nicber/arduino-jupyter/PROTOCOL.md

# CtrlLink

Un protocolo serie para gobernar desde un notebook de Jupyter un banco que corre
en un Arduino: fijar sus parámetros, aplicar un escalón y traerse de vuelta la
serie temporal que resulta.

```python
from ctrllink import CtrlLink

dev = CtrlLink()                 # o CtrlLink('COM3'), o '/dev/ttyACM0'
dev.ctl_uff = 100
df = dev.step('ctl_uff', 200, pre=0.3, post=1.2)    # un DataFrame, t = 0 en el escalón
df.plot(x='t', y=['u', 'y_uw'])
```

El dispositivo describe por sí mismo sus parámetros y sus canales de telemetría,
así que la computadora no sabe nada de ningún sketch en particular. Agregar un
parámetro al firmware la hace aparecer en el notebook sin tocar una línea del lado
de Python.

## Diseño

**Un puerto, dos direcciones, sin capa de encuadre.** Las líneas que empiezan
con `#` son texto: respuestas a comandos, eventos, diagnósticos. Cualquier otra
línea es una fila de telemetría. Esa única convención hace que el flujo sea a la
vez interpretable por la máquina y legible en el Monitor Serie del IDE de
Arduino, y permite que una depuración con `Serial.print` conviva con una captura
en vivo en lugar de corromperla.

**Hexadecimal de ancho fijo, en lugar de decimal o binario.** La razón es el
*ancho fijo*, no el hexadecimal. Una fila mide siempre lo mismo, así que el
presupuesto de ancho de banda es exacto en vez de ser el del peor caso, `emit()`
puede pedir exactamente el lugar que necesita, y una captura se decodifica en una
sola llamada vectorizada en lugar de recorrerse línea por línea:

```python
raw = bytes.fromhex(b''.join(rows).decode())
arr = np.frombuffer(raw, dtype=structured_dtype)
```

El hexadecimal además es algo más barato de generar que el decimal —una consulta
a tabla y un `swap` por byte, contra las divisiones sucesivas de `itoa`—, pero el
`itoa` de avr-libc está escrito a mano en assembler, así que la diferencia es
como un 20 % del costo de codificar, no un orden de magnitud. Lo que pesa es
sacar cada byte por la UART, no elegir cómo se escribe (ver *Ancho de banda*), así
que la diferencia es secundaria frente a las ventajas de encuadre de arriba.

Un encuadre binario (COBS + CRC) ahorraría otro ~40 % de los bytes, pero a
1 Mbaud el ancho de banda no es la restricción activa, y costaría la posibilidad
de leer el flujo con los ojos. Subir la velocidad es la palanca más barata:
115200 → 1 Mbaud es 8,7×, mientras que hexadecimal → binario es 1,4×.

**1 Mbaud, no 115200.** En un AVR de 16 MHz, 1000000 es un divisor exacto
(UBRR=1); 115200 cae en UBRR=16, que da 117647 baudios reales, un 2,1 % de error.
La velocidad más alta es además la más exacta. 250000 y 500000 también son
exactas, por si el puente USB-serie de alguna placa no llega más arriba.

**Las dos direcciones no son igual de robustas.** La telemetría a 1 Mbaud es
sólida: medida sobre cinco segundos, cero filas perdidas y cero huecos. Los
comandos no. Un byte entrante llega cada 10 µs, el USART del AVR guarda dos, y
entre el muestreador de 5 kHz y el manejador de TWI de nI2C mantienen las
interrupciones deshabilitadas durante mucho más que eso.

Medido en el banco (2026-09-16), 60 comandos `get loop_div` de 13 bytes por caso:

| | espaciados 0,5 ms/byte | de corrido |
|---|---|---|
| sin flujo | 60/60 | 14/60 |
| con flujo | 60/60 | 8/60 |

De 13 bytes, `(1-p)^13 = 14/60` da **p ≈ 11 % de los bytes sin flujo y ≈ 14 % con
flujo**. Que la pérdida exista
igual sin telemetría confirma que lo que se come los bytes es el muestreador y no
la emisión.

Por eso la computadora espacia los bytes de un comando 0,5 ms (`_BYTE_GAP` en
`ctrllink.py`), que los lleva a 60 de 60 en las dos condiciones. Los comandos son
raros y cortos --un `set` tarda del orden de 10 ms en enviarse--, así que no cuesta
nada, y el tick que informa `# mark` hace que incluso un escalón enviado en medio de
una captura quede ubicado en la muestra exacta. Encima de eso, la computadora
reintenta todo comando que el dispositivo declare no haber entendido, y verifica el
valor que devuelve un `set` en lugar de confiar en él: un *comando* deformado se
rechaza a los gritos, pero un *valor* deformado se aceptaría en silencio.

Marcar el muestreador como `ISR_NOBLOCK` sí lo arreglaría, y por qué no se hizo
se ve con los números. El manejador de TWI dura ~9 µs, que entra holgado en los ~20 µs que da el
buffer de dos bytes del USART: el que no entra es el del muestreador, de ~62 µs
medidos. `ISR_NOBLOCK` ahí bajaría el peor apagón de 62 a ~9 µs. Lo que hace
falta antes es proteger `m_sum[]`/`m_n[]` en `RowAdc`, que hoy se leen y se ponen
en cero dando por sentado que la ISR del ADC no anida. Queda pendiente; el
espaciado de bytes lo tapa por completo mientras tanto.

**El enlace se limpia solo.** Una celda de notebook se interrumpe en cualquier
parte: el botón de parar en mitad de una captura, un traceback a mitad de un
`set`. Ahí el dispositivo queda emitiendo filas que nadie va a leer y media línea
de comando en su buffer de entrada, y la celda siguiente hereda el desastre: los
datos de una captura aparecen como respuesta a un `get`. Así que toda operación
toma el enlace y, si sale por una excepción, lo deja limpio antes de dejarla
pasar: una línea vacía cierra el comando a medio escribir, un `stop` calla al
dispositivo y lo que quede en el camino de vuelta se descarta. La prueba de que
el flujo paró es la respuesta al `stop`, que el dispositivo da esté emitiendo o
no, y no el silencio: con `dec` alto una fila tarda más que cualquier ventana de
silencio razonable, y un `stop` se puede perder de ida como cualquier otro
comando, así que se repite hasta que llega la confirmación. Si ni eso se logra,
el enlace queda marcado y la operación siguiente lo intenta de nuevo antes de
mandar nada. Nunca hace falta reiniciar el kernel para recuperar el control de
la placa.

**Flujo continuo, no captura en buffer.** Un ATmega328P tiene 2 KB de SRAM, así
que una captura en buffer entra unas 175 muestras: 350 ms a 500 Hz, mucho menos
que un transitorio hasta el establecimiento. El flujo continuo no tiene límite de
duración; lo que queda acotado es la frecuencia de muestreo, y a 1 Mbaud ese
tope está muy por encima de lo que puede muestrear un UNO.

**Nunca bloquear el muestreo.** `Serial.write` bloquea en cuanto se llena el
buffer de transmisión --128 bytes en `Banco`, que se compila con
`-DSERIAL_TX_BUFFER_SIZE=128`; el core trae 64--, lo que frenaría el muestreo y
distorsionaría justamente la dinámica que se está midiendo. `emit()` consulta primero
`availableForWrite()` y descarta la fila si no hay lugar, contando el descarte.
Una fila descartada deja un hueco visible en la secuencia de ticks; una escritura
bloqueante dejaría un error de temporización invisible.

Con una excepción, que conviene anotar en lugar de afirmar que no la hay:
`cmd_set()` escribe su respuesta con `Serial.print` sin consultar
`availableForWrite()`, así que un `set` en medio de una captura es la única
escritura bloqueante que queda en el camino del flujo. Durante un flujo esa respuesta
son unos 48 bytes --`# mark`, `# v` y `# ok`--: con el buffer de 128 bytes casi
siempre entran sin esperar, pero con el buffer casi lleno la escritura espera a que
salgan, hasta ~480 µs a 1 Mbaud. Está acotada y aparece medida en `loop_late`, pero
existe.

## Ancho de banda

El puerto serie usa 10 bits por byte, así que el enlace transporta `baud/10`
bytes por segundo. Una fila cuesta `4 + Σ(anchos de canal) + 1` bytes, donde un
canal ocupa 4 caracteres hexadecimales si es int16 y 8 si es int32 o float.

| | fila | @115200 | @250k | @500k | @1M |
|---|---|---|---|---|---|
| 4 × int16 | 21 B | 548 Hz | 1,2 kHz | 2,4 kHz | 4,8 kHz |
| 4 × float | 37 B | 311 Hz | 676 Hz | 1,4 kHz | 2,7 kHz |

Eso es al 100 % de utilización. Conviene quedarse por debajo de la mitad: el
sketch `Banco` corre cinco canales a 500 Hz —un int32, tres de 16 bits y uno de 8,
27 bytes por fila—, que son 13,5 kB/s, o el 14 % de un enlace de 1 Mbaud.

Pero a 1 Mbaud el cable no es lo que se acaba primero, sino la CPU del
dispositivo. Formatear un byte, copiarlo al buffer y sacarlo por la interrupción
de la UART le cuesta a un ATmega328P a 16 MHz del orden de 10 µs, así que una fila
ancha pesa más que un paso de control PID entero. Por eso los canales se eligen
por captura (ver `chans` más abajo).

Medido en el banco con `Banco`, `loop_div = 1` y el muestreador del AS5600
corriendo a 5 kHz (2026-09-16), filas efectivamente atendidas por segundo:

| Fila | Techo |
|---|---|
| 27 B (cinco canales) | 922 filas/s |
| 17 B (dos canales) | 1138 filas/s |
| 9 B (un canal) | 1396 filas/s |

El `loop_div` más chico que no pierde ni un período con los cinco canales es
**6 (833 Hz)**.

**En las tres, `drops = 0`**: no se descartó una sola fila por falta de buffer. A
922 filas/s de 27 bytes son 25 kB/s, el 25 % del cable. Lo que se acaba es el
CPU, nunca el enlace, y por eso cortar canales sube el techo.

Adónde va la CPU: la lectura de I2C a 5 kHz cuesta unos 21 puntos (medido
cortándola), y la ISR del muestreador se lleva otros 31. `ControlDemo` corre además
la ley de control, así que sus techos son más bajos que éstos y no están medidos.

## Protocolo de línea

Los comandos son ASCII, uno por línea, terminados en `\n`. Toda respuesta
termina en `# ok`, `# err <motivo>` o `# data`, así que la computadora puede
esperar un terminador definido en lugar de adivinar con una espera fija.

| Comando | Respuesta |
|---|---|
| `id` | `# id CtrlLink 1 <sketch> chans=<n> row=<bytes> dt_us=<n>`; `row` con los canales activos |
| `params` | un `# p <nombre> <tipo> <frac> <valor>` por parámetro |
| `chans` | un `# c <i> <nombre> <tipo> <escala> <unidad>` por canal, activo o no |
| `get <nombre>` | `# v <nombre> <valor>` |
| `set <nombre> <valor>` | `# v <nombre> <valor>` |
| `start` | el encabezado del flujo, terminado en `# data`, y después las filas |
| `stop` | `# end rows=<n> drops=<n>` |

Los tipos son `i8 u8 i16 u16 i32 u32 f32`. Una línea vacía se ignora, así que
enviar una es una forma segura de resincronizar.

Dos parámetros no son del sketch sino de la biblioteca, y aparecen en `params` de
cualquier dispositivo:

- `dec` emite una fila cada tantos períodos.
- `chans` elige qué canales van en la fila: una máscara de 16 bits donde el bit
  `i` es el canal `i` de `chans`. Por omisión vale 65535, todos. **Se toma en
  `start`**: cambiarlo durante el flujo vale recién para la captura siguiente,
  porque las filas que ya están en camino se leen con el encabezado de ésta. Un
  `start` cuya fila no entre en el buffer de transmisión se rechaza con
  `# err fila demasiado larga: apagar canales con chans`.

El `<valor>` que va por el cable es siempre el almacenamiento crudo del
dispositivo. `<frac>` dice cuántos bits fraccionarios lleva ese almacenamiento,
así que la computadora lee `raw / 2**frac` y escribe `round(valor * 2**frac)`.
Un dispositivo puede entonces guardar una ganancia en Q22 y el polo de un filtro
en Q16 —lo que su aritmética prefiera— mientras la computadora los sigue fijando
como `0.5` y `0.02`, y la conversión ocurre del lado que tiene unidad de punto
flotante y no tiene plazo que cumplir. `frac = 0` es un entero común.

Potencias de dos en lugar de la `escala` flotante arbitraria de un canal, porque
eso es lo que es un formato de punto fijo, y porque cruza el cable de forma
exacta: ningún número fijo de decimales imprime de manera útil tanto una escala
Q22 (2,4e-7) como una Q30 (9,3e-10). Todo lo que necesite una escala que no sea
potencia de dos —grados por cuenta, miliamperes por LSB— es un canal, y un canal
tiene una.

Con el límite que se sigue de ahí, que hay que tener presente al declarar un
canal: la escala de un canal **sí** se imprime con un número fijo de decimales
(siete), así que una escala por debajo de 5e-8 sale `0.0000000`, `float()` la
acepta sin quejarse y la columna entera vuelve en cero. Las de `Banco` están
lejos de ese piso --lo peor son 2,8e-7 de error relativo en `COUNTS_TO_DEG`--
pero una escala Q24 ya no entra. Un canal que necesite una escala así de chica
tiene que publicarse con otra unidad.

### Flujo

El encabezado lista sólo los canales activos, en el orden de la tabla:

```
# begin
# rate dt_us=1000 dec=1
# col tick u16 1 tick
# col ref i16 0.0878906 deg
# col y i16 0.0878906 deg
# col u i16 1.0000000 pwm
# data
0412CDB90C800076
0413CDB90C830074
```

La columna cero es siempre un contador de ticks de 16 bits, que avanza una vez por
cada llamada a `emit()`, se emita o no una fila: las que saltea `dec` y las que se
descartan por falta de buffer igual consumen su número. Un período de control
que el lazo no llegó a atender, en cambio, no llama a `emit()` y no deja hueco en
`tick`: ése lo cuenta el sketch (en `Banco`, `loop_missed`). Da la vuelta cada 65536
llamadas y la computadora la desenrolla. Multiplicar por `dt_us` para obtener
segundos; multiplicar un canal por su `escala` para obtener unidades de
ingeniería. Todos los valores son hexadecimal sin signo del almacenamiento crudo,
con el nibble más significativo primero: un float son sus cuatro bytes IEEE-754,
no una conversión a decimal, lo que lo hace gratis de emitir en un dispositivo
sin unidad de punto flotante.

El dispositivo sólo emite valores; la conversión de unidades ocurre en la
computadora.

### Eventos durante una captura

`set` funciona mientras hay flujo, y el dispositivo informa el tick en el que el
valor entró en vigencia:

```
0412CDB90C800076
# mark 1043 ref 1024
0413CDB90C830074
```

Esto es lo que hace exacta una respuesta al escalón. La computadora programa el
escalón con una precisión del orden del milisegundo, pero la *medición* usa el
tick que informa el dispositivo, así que la fluctuación de la computadora nunca
entra en los datos.

## API del lado de la computadora

`CtrlLink(port, baud=1_000_000)` abre el puerto, resetea la placa y descubre el
dispositivo. El reset se fuerza con un flanco de bajada de DTR: abrir el puerto
no alcanza, porque la línea puede venir activada de la conexión anterior —en
macOS con un puente CH340 se queda así—, y entonces no hay flanco y la placa
sigue corriendo con el estado que le dejó la corrida pasada. `reset_wait=0` se
engancha a un sketch que ya está corriendo, sin resetear nada.

- Los parámetros son atributos, siempre en unidades reales: `dev.ctl_uff = 120`,
  `print(dev.ctl_uff)`. `dev.params` los lee todos de vuelta.
- `dev.capture(duration, events=[(retardo, nombre, valor), ...], canales=None)`
  → DataFrame. `canales=['y_uw', 'u']` emite sólo esos, fijando `chans` antes de
  arrancar y restituyendo la selección anterior al terminar, aunque la captura se
  interrumpa. Las columnas salen en el orden de la tabla del dispositivo.
- `dev.step(nombre, valor, pre=0.1, post=0.9, back=None, canales=None)` →
  DataFrame con `t = 0` en el escalón. Si se interrumpe, `back` se restituye
  igual: del otro lado del cable puede haber un motor empujando contra un tope.
- `dev.resync()` deja el enlace en un estado conocido. Se llama sola cuando hace
  falta; está expuesta para forzarla a mano después de algo que el módulo no vio
  pasar.

El DataFrame trae `t` en segundos más una columna por canal en unidades de
ingeniería. `df.attrs` guarda `dt_us`, `dec`, `units`, `marks`, `notes`, los
contadores `rows`/`drops` del propio dispositivo, y `gaps`, la cantidad de cortes
en la secuencia de ticks, que vale 0 en una captura limpia.

## Firmware

Se declaran los parámetros ajustables y la telemetría como tablas en PROGMEM y
el resto sale solo:

```cpp
static const CtrlParam PROGMEM g_params[] = {
    { "escala", CTRL_I32, &g_escala, 22 },  // Q22: la PC fija 0.5, el dispositivo guarda 2097152
    { "ctl_uff", CTRL_I16, &g_uff,  0 },    // un entero común
};

static const CtrlChannel PROGMEM g_channels[] = {
    { "y", CTRL_I16, &g_y, 360.0f / 4096, "deg" },
    { "u", CTRL_I16, &g_u, 1.0f,          "pwm" },
};

void setup() {
    CtrlLink::set_id(F("MySketch"));
    CtrlLink::begin(1000000, g_params, 2, g_channels, 2, /* dt_us */ 1000);
}

void loop() {
    if (tick_due()) {
        paso();              // escribe g_y, g_u
        CtrlLink::emit();    // una fila, nunca bloquea
    }
    CtrlLink::poll();        // a lo sumo un comando por llamada
}
```

`emit()` lee los canales a través de sus direcciones, así que hay que llamarlo
desde el mismo contexto que los escribe: `loop()`, no una ISR. Los nombres tienen
11 caracteres como máximo (`CTRL_NAME_LEN` = 12 con el NUL), que es lo que permite ponerles un prefijo de módulo: una
tabla de tres docenas de parámetros planos no dice quién es dueño de cuál, y
`ctl_uff` contra `ang_cal` contra `loop_div` lo dice sin ir a leer el sketch. La
tabla de canales admite hasta 16 entradas, una por bit de `chans`, y puede
declarar más de lo que entra en una fila: lo que tiene que entrar en el buffer de
transmisión es la selección activa, y `start` la rechaza si no, en lugar de
descartar todas las muestras en silencio.

## Medido

Los números de `Banco` están donde se usan: la pérdida de bytes de los comandos en
*Diseño*, y cuántas filas por segundo atiende la placa --922 con los cinco canales,
1138 con dos y 1396 con uno, sin descartar ninguna-- en *Ancho de banda*.

El CH340 merece un párrafo aparte: es el puente que traen la mayoría de los
clones de UNO y el que suele darse por limitado a velocidades bajas, y sobre un clon
con CH340G aguantó 1 Mbaud sin perder una sola fila: 4983 filas de 21 bytes
enviadas en 5 s, a 1 kHz, y 4983 recibidas, sin huecos de tick.

El retardo de atención es el costo honesto de hacer el paso dentro de `loop()` al
lado del manejo del puerto serie; el muestreo en sí es rígido, porque lo gobierna el
Timer2, así que una atención tardía aparece como fluctuación en `u`, no en `y`.
`loop_late` informa el peor retardo y `loop_missed` los períodos que no se llegaron
a atender. `start` pone los dos en cero y `stop` los congela, así que describen la
captura y nada más, y se pueden leer después de terminada.

## Instalación

Ver *Puesta en marcha* en el README.

## Organización

- `libraries/CtrlLink/` — el protocolo, lado placa
- `python/ctrllink.py` — el protocolo, lado computadora
- `python/test_ctrllink.py` — pruebas del lado computadora contra una simulación
  del dispositivo fiel byte a byte
- `Banco/` — el banco en lazo abierto: PWM sobre el actuador, AS5600 muestreado a
  5 kHz, corriente por el ADC, filas a 500 Hz
- `notebooks/hardware.ipynb` — cómo está armado el banco, cada parte del montaje,
  y la API para el TP2

```
arduino-cli compile --fqbn arduino:avr:uno --libraries ./libraries \
  --build-property compiler.c.extra_flags=-O2 \
  --build-property "compiler.cpp.extra_flags=-O2 -DSERIAL_TX_BUFFER_SIZE=128" \
  --build-property compiler.c.elf.extra_flags=-O2 \
  Banco
arduino-cli upload  --fqbn arduino:avr:uno --libraries ./libraries -p <puerto> Banco
```

`Banco` se apropia de los tres timers, el ADC, el USART y el TWI: la lista y sus
consecuencias están en `notebooks/hardware.ipynb`, sección 0.
