nicber/arduino-jupyter/python/ctrllink.py

"""Lado computadora del protocolo CtrlLink.

Se comunica por un puerto serie con un Arduino que corre la biblioteca CtrlLink.
El dispositivo describe por sí mismo sus parámetros ajustables y sus canales de
telemetría, así que este módulo no sabe nada de ningún sketch en particular:
agregar una ganancia al firmware la hace aparecer acá sin tocar una línea de este
lado.

    from ctrllink import CtrlLink

    dev = CtrlLink()                    # o CtrlLink('COM3'), o '/dev/ttyACM0'
    dev.ctl_uff = 100
    df = dev.step('ctl_uff', 200, pre=0.3, post=1.2)
    df.plot(x='t', y=['u', 'y_uw'])

Los nombres de ese ejemplo son los del sketch de este proyecto y no del protocolo:
los parámetros salen de la tabla del dispositivo, así que cada sketch trae los
suyos. `dev.params` los lista.

Las filas de telemetría son hexadecimal de ancho fijo, así que una captura se
decodifica en una sola llamada a numpy en lugar de interpretarse línea por línea;
recibir un flujo de 1 kHz no cuesta casi nada.

Acá los parámetros están siempre en unidades reales. El dispositivo guarda cada
uno en la forma de punto fijo que su aritmética prefiera y dice cuántos bits
fraccionarios son; este lado multiplica a la ida y divide a la vuelta, así que el
lazo que corre en un microcontrolador de 8 bits nunca ejecuta una instrucción de
punto flotante y quien lo maneja nunca ve una cuenta cruda.

El enlace se limpia solo. Si una celda se corta por el medio —el botón de parar
en mitad de una captura, una excepción a mitad de un `set`—, la operación
siguiente encuentra el dispositivo callado y el puerto vacío en lugar de heredar
un flujo a medio terminar, así que nunca hace falta reiniciar el kernel para
recuperar el control de la placa.
"""

from __future__ import annotations

import sys
import time
from contextlib import contextmanager
from dataclasses import dataclass

import numpy as np

# Tipo del cable -> dtype big-endian de numpy. El ancho hexadecimal de un campo es
# el doble de su itemsize, y todos los anchos son pares, así que una tanda de
# filas se convierte de hexadecimal en un solo bloque.
_TYPES = {
    'i8': np.dtype('>i1'),
    'u8': np.dtype('>u1'),
    'i16': np.dtype('>i2'),
    'u16': np.dtype('>u2'),
    'i32': np.dtype('>i4'),
    'u32': np.dtype('>u4'),
    'f32': np.dtype('>f4'),
}

# Lo que entra en cada tipo del cable. El dispositivo hace strtol y un cast, así
# que un valor que no entre queda guardado deformado y nadie lo restituye: más vale
# no mandarlo. Con punto fijo se llega antes de lo que parece --un i32 con frac 22
# se pasa en 512--, y el mensaje tiene que hablar del pedido y no del almacenamiento.
_LIMITS = {
    'i8':  (-128, 127),
    'u8':  (0, 255),
    'i16': (-32768, 32767),
    'u16': (0, 65535),
    'i32': (-2**31, 2**31 - 1),
    'u32': (0, 2**32 - 1),
}

# Los dígitos de una fila. El ancho solo no alcanza para reconocerla: una línea de
# texto que por casualidad mida lo mismo rompía la captura entera.
_HEXDIG = b'0123456789ABCDEFabcdef'

# Respuestas que dan por terminada la contestación a un comando.
_TERMINATORS = ('# ok', '# err', '# data')

# Errores que significan que el dispositivo no recibió lo que se le mandó, y no
# que lo recibió y objetó. Sólo vale la pena reintentar éstos.
_GARBLED = ('comando desconocido', 'comando demasiado largo', 'necesita')

# Y éste, que depende del comando: un byte perdido adentro del *nombre* da
# exactamente «no existe ese parametro», que parece una objeción legítima y no lo
# es. Si el nombre que se mandó está en la tabla del dispositivo, que no exista es
# prueba de deformación. Ver _es_deformacion().
_GARBLED_SI_EXISTE = 'no existe ese parametro'

# Contadores de salud del lazo. Son los únicos que este módulo conoce, y lo son
# porque no dependen de ningún hardware: cualquier dispositivo que hable este
# protocolo tiene un período de control que puede no llegar a cumplir.
#
# Cada entrada es (clave, parámetro): el nombre corto con el que queda en
# `df.attrs` y el parámetro del dispositivo del que sale. Son dos cosas distintas
# a propósito. El vocabulario del notebook es estable y el del dispositivo no: los
# parámetros llevan prefijo de módulo, y un sketch distinto puede llamarlos de otra
# manera sin que cambie el nombre por el que se los mira desde un gráfico.
#
#   missed   períodos de control que el lazo nunca atendió
#   maxlate  peor retardo entre el disparo de un tick y el momento en que el lazo
#            lo levanta, en us
#
# Son totales acumulados y no lecturas instantáneas, así que una captura los pone
# en cero primero y lo que vuelve describe esa captura y nada más. Un dispositivo
# que no declare alguno simplemente no lo informa: la lista se cruza contra la
# tabla de parámetros.
_HEALTH = (('missed', 'loop_missed'),
           ('maxlate', 'loop_late'))

# Todo lo demás que se pueda querer saber de una captura depende del equipo, y
# este módulo no sabe qué equipo hay del otro lado. Un sensor que no contesta, un
# imán mal montado, un bus que no sigue: nada de eso es del protocolo, así que no
# vive acá.
#
# Quien sí lo sepa se lo pasa a __init__ como `diagnostico`, un colaborador con
# cinco métodos, todos opcionales:
#
#   parametros_de_salud()  -> ((clave, parametro), ...)  cuentas, se ponen en cero
#   parametros_de_estado() -> ((clave, parametro), ...)  lecturas de ahora, no se
#                          ponen en cero
#   parametros_de_configuracion() -> (parametro, ...)  perillas que cambian lo
#                          que se mide; van en df.attrs['config']
#   notas_primero(df)      -> [texto, ...]   antes de las genéricas
#   notas_despues(df)      -> [texto, ...]   después
#
# Que las notas se partan en dos no es una comodidad: el orden importa. Si el
# sensor no está, todo lo demás que se mida es consecuencia de eso y no un problema
# por derecho propio, así que esa nota tiene que ir primera. Ver
# bench.DiagnosticoDeBanco.

# Los parámetros que administra la propia biblioteca y no el sketch: aparecen en
# `params` de cualquier dispositivo, pero no en su tabla. `dec` diezma el flujo y
# `chans` elige qué canales van en la fila; ver capture().
LINK_PARAMS = ('dec', 'chans')

# Fracción del período de control a partir de la cual vale la pena mencionar un
# retardo de atención, aunque todavía no se haya perdido nada.
_LATE_WARN = 0.5

# Segundos entre los bytes de un comando saliente.
#
# La telemetría corre a 1 Mbaud sin problemas, pero el camino de vuelta es frágil:
# llega un byte cada 10 us, el USART del AVR guarda dos, y entre el muestreador de
# 5 kHz y la interrupción de TWI de nI2C mantienen las interrupciones
# deshabilitadas durante más que eso. Enviados de corrido se pierde, medido, un
# 11 % de los bytes de comando sin flujo y un 14 % con flujo (ver PROTOCOL.md).
# Espaciarlos lo soluciona por completo --llegaron enteros 120 comandos de 120--,
# y los comandos son demasiado raros y cortos como para que el retardo
# importe: a medio milisegundo por byte, un `set` tarda del orden de 10 ms en
# enviarse.
_BYTE_GAP = 0.0005

# Los retardos más cortos que esto se esperan en vacío en lugar de dormirse. Ver
# _pause().
_SPIN_UNDER = 0.002


def _pause(seconds):
    """Un retardo corto que efectivamente es corto.

    Antes de Python 3.11, time.sleep() en Windows redondea hacia arriba hasta el
    tic del temporizador del sistema —15,6 ms por omisión, treinta veces la
    separación entre bytes de comando—. Dormir _BYTE_GAP ahí haría que un `set`
    tardara unas treinta veces más, y capture(), que alrededor de cada corrida
    envía un comando por contador y por perilla registrada --con Banco, unos
    treinta--, sumaría segundos de espera.

    Así que cualquier cosa por debajo de un par de milisegundos se espera en vacío
    sobre perf_counter(), que tiene alta resolución en todas partes. Cuesta tener
    la CPU ocupada durante los milisegundos que tarda en enviarse un comando, un
    costo aceptable a cambio de comportarse igual en cualquier máquina.
    """
    if seconds >= _SPIN_UNDER:
        time.sleep(seconds)
        return

    deadline = time.perf_counter() + seconds
    while time.perf_counter() < deadline:
        pass


class CtrlLinkError(RuntimeError):
    pass


def find_port(hint=None):
    """Busca en qué puerto serie está la placa.

    Los adaptadores Bluetooth y las consolas de depuración también se presentan
    como puertos serie, así que la búsqueda se limita a los de USB, y por
    identificador de fabricante USB, que todas las plataformas informan y que no
    dice nada sobre cómo se *llama* el puerto. Windows los llama COM3, macOS
    /dev/cu.usbmodem1101 y Linux /dev/ttyACM0, y buscar por esos nombres encuentra
    una placa en una máquina y nada en la siguiente.

    `hint` acota todavía más por subcadena, que es lo que hay que usar cuando hay
    más de una placa enchufada.
    """
    from serial.tools import list_ports

    found = list(list_ports.comports())
    usb = [p for p in found if p.vid is not None]

    if not usb:
        # Algunas plataformas y algunas versiones antiguas de pyserial dejan vid sin
        # cargar. Se recurre entonces a los nombres que suele tener un puerto serie
        # USB, puertos COM incluidos.
        usb = [p for p in found
               if any(tag in p.device for tag in
                      ('usbserial', 'usbmodem', 'ttyUSB', 'ttyACM',
                       'wchusbserial', 'COM'))]

    ports = [p.device for p in usb]

    if hint:
        ports = [p for p in ports if hint in p]

    if not ports:
        raise CtrlLinkError('no se encontró ningún puerto serie USB '
                            '-- ¿está enchufada la placa?')
    if len(ports) > 1:
        raise CtrlLinkError(f'se encontraron varios puertos serie USB '
                            f'({", ".join(ports)}); pasar uno explícitamente '
                            f'o acotarlo con un hint')
    return ports[0]


def _ended(buf):
    """True cuando la respuesta completa a `stop` está en el buffer.

    El dispositivo contesta "# end rows=... drops=..." y **después** "# ok".
    Darse por satisfecho con la línea "# end" deja el "# ok" todavía en el
    puerto, y entonces el comando siguiente lo lee como si fuera su propio
    terminador y vuelve sin datos, lo que se manifiesta como un "no hay valor en
    la respuesta para 'missed'" intermitente al terminar una captura. Así que se
    espera también la línea que cierra.
    """
    at = buf.find(b'# end ')
    if at < 0:
        return False

    end_of_line = buf.find(b'\n', at)
    if end_of_line < 0:
        return False

    return buf.find(b'\n', end_of_line + 1) >= 0


def _quiso_decir(name, candidatos):
    """La sugerencia para un nombre mal escrito, o '' si no se parece a ninguno."""
    import difflib
    parecidos = difflib.get_close_matches(name, candidatos, n=3)
    return f' ¿Quiso decir {" o ".join(map(repr, parecidos))}?' if parecidos else ''


@dataclass
class Param:
    """Un parámetro del dispositivo, y el formato de punto fijo en que se guarda.

    `frac` es cuántos bits fraccionarios lleva el entero del dispositivo, así que
    las unidades reales son `raw / 2**frac`. Una potencia de dos en lugar de una
    escala arbitraria, para que la conversión sea exacta en los dos sentidos y no
    se pierda nada al imprimirla: ningún número fijo de decimales sirve a la vez
    para una escala Q22 (2,4e-7) y para una Q30 (9,3e-10).
    """
    name: str
    type: str
    frac: int

    @property
    def integral(self) -> bool:
        """True si el dispositivo lo guarda como entero."""
        return self.type != 'f32'

    @property
    def scale(self) -> float:
        """Unidades reales por cuenta almacenada. Exacto: una potencia de dos."""
        return 2.0 ** -self.frac


@dataclass
class Column:
    name: str
    type: str
    scale: float
    unit: str

    @property
    def dtype(self) -> np.dtype:
        return _TYPES[self.type]

    @property
    def width(self) -> int:
        """Ancho de este campo, en caracteres hexadecimales."""
        return self.dtype.itemsize * 2


class CtrlLink:
    # Estado del enlace. Son atributos de clase para que también valgan en un
    # objeto armado sin pasar por __init__.
    _depth = 0       # operaciones anidadas: sólo la de más afuera limpia
    _broken = False  # una operación se cortó por el medio y dejó el enlace sucio

    # Quien sepa qué equipo hay del otro lado, o None. Atributo de clase por la
    # misma razón que los dos de arriba, y además porque sin él una property que
    # lo consulte falla con AttributeError y el intérprete cae en __getattr__:
    # el error que sale entonces nombra la property y no la causa.
    _diag = None

    def __init__(self, port=None, baud=1_000_000, reset_wait=1.8, timeout=1.0,
                 diagnostico=None):
        """Abre el puerto, resetea la placa y descubre el dispositivo.

        `reset_wait` es cuánto se le da al bootloader; con 0 no se resetea nada y
        el enlace se engancha a un sketch que ya está corriendo.

        `diagnostico` es quien sepa qué equipo hay del otro lado, para que este
        módulo no tenga que saberlo. Sin él, una captura informa lo del lazo y nada
        más, que es exactamente lo que el protocolo permite saber.
        """
        if port is None:
            port = find_port()

        # pyserial se importa recién acá: el resto del módulo --y el banco simulado,
        # que lo importa-- corre sin él.
        import serial

        self._diag = diagnostico
        self.ser = serial.Serial(port, baud, timeout=timeout)

        try:
            if reset_wait:
                self._reset_board(reset_wait)

            self._descubrir()
        except BaseException:
            # El puerto ya está abierto, y un puerto serie es exclusivo. En un
            # notebook el traceback de la celda sobrevive en sys.last_traceback,
            # así que este objeto a medio construir no se recolecta y se queda
            # con el puerto: el intento siguiente falla con «no se pudo abrir el
            # puerto» y parece un problema distinto del que realmente pasó.
            self.ser.close()
            raise

    # ------------------------------------------------------ gestión del puerto

    def _reset_board(self, wait):
        """Resetea la placa y espera a que arranque el sketch.

        Lo que resetea un UNO es el flanco de bajada de DTR, no que DTR esté
        activado: la línea llega al RESET por un condensador. Abrir el puerto
        activa DTR, así que alcanzaría con abrirlo *si* DTR hubiera estado
        desactivado antes; y no siempre lo está. En macOS, con un puente CH340,
        la línea se queda activada entre un cierre y la apertura siguiente, así
        que reabrir el puerto no genera ningún flanco y la placa no se entera.

        Sin el flanco, reconectar parecería resetear la placa sin hacerlo: una
        segunda corrida del notebook heredaría `loop_div`, las ganancias y el modo
        de la primera, y la puesta en marcha no lo detectaría, porque el
        dispositivo contesta el período en el que efectivamente está corriendo.

        Así que el flanco se produce a mano. Después hay que esperar: el
        bootloader tarda, y nada de lo que diga el dispositivo antes de correr
        setup() vale la pena leerse.
        """
        self.ser.dtr = False
        time.sleep(0.05)
        self.ser.dtr = True

        time.sleep(wait)
        self.ser.reset_input_buffer()

    def close(self):
        if not self.ser.is_open:
            return

        # Cerrar en medio de una captura deja al dispositivo emitiendo contra un
        # puerto que ya nadie lee. Reabrir lo resetea, así que no es fatal, pero
        # detenerlo cuesta un comando y no vale la pena dejarlo emitiendo.
        if self._broken or self._depth:
            try:
                self._send('stop')
                self._drain(timeout=0.3)
            except Exception:
                pass

        self.ser.close()
        self._broken = False

    def __enter__(self):
        return self

    def __exit__(self, *exc):
        self.close()

    # --------------------------------------------------------- toma del enlace
    #
    # Una celda de notebook se interrumpe en cualquier parte: el botón de parar
    # en medio de una captura, una excepción a mitad de un `set`, un traceback
    # que sale de algo que no tiene nada que ver. El enlace queda entonces en un
    # estado que ninguna de las dos puntas conoce del todo —el dispositivo
    # emitiendo filas que nadie lee, media línea de comando en su buffer de
    # entrada, media respuesta en el nuestro— y la celda siguiente hereda ese
    # estado: los datos de una captura aparecen como respuesta a un `get`, y
    # el enlace parece pedir un reinicio del kernel.
    #
    # Así que toda operación toma el enlace, y si sale por una excepción lo deja
    # limpio antes de dejarla pasar. Si ni siquiera eso se logra —una segunda
    # interrupción encima de la primera, la placa desenchufada— el enlace queda
    # marcado y la operación siguiente lo intenta de nuevo antes de mandar nada.

    @contextmanager
    def _hold(self, heal=True):
        """Toma el enlace para una operación y lo deja limpio pase lo que pase.

        `heal=False` es para la limpieza misma, que no puede llamarse a sí misma.
        """
        if self._depth:
            yield                 # anidada dentro de otra operación: ya está tomado
            return

        self._depth = 1
        try:
            if heal and self._broken:
                self._resync()    # levanta si el dispositivo no se deja limpiar

            try:
                yield
            except BaseException:
                self._broken = True
                if heal:
                    self._heal()
                raise
            else:
                self._broken = False
        finally:
            self._depth = 0

    def _heal(self):
        """Limpia el enlace sin levantar nada.

        Corre mientras una excepción está saliendo, así que taparla con otra
        sería cambiar un problema por uno peor: si no puede, deja el enlace
        marcado y la operación siguiente vuelve a intentarlo.
        """
        try:
            self._resync()
        except Exception:
            return
        self._broken = False

    def resync(self, timeout=6.0):
        """Deja el enlace en un estado conocido: nada a medio enviar, el
        dispositivo callado y contestando.

        Se llama sola cuando hace falta; está expuesta para poder forzarla a
        mano después de algo que este módulo no vio pasar.
        """
        with self._hold(heal=False):
            self._resync(timeout)

    def _resync(self, timeout=6.0):
        deadline = time.monotonic() + timeout

        # Una línea vacía termina el comando que haya quedado a medio escribir,
        # que si no se pegaría adelante del siguiente. El dispositivo descarta
        # las líneas vacías, así que también es inofensiva si no había nada a
        # medias.
        self._send('')

        # `stop` es idempotente, y el dispositivo lo contesta esté emitiendo o
        # no, así que su respuesta es la prueba de que paró. El silencio no
        # alcanza: con `dec` alto una fila puede tardar más que cualquier ventana
        # de silencio razonable, y entonces un puerto callado no significa nada.
        # El `stop` mismo se puede perder en el camino de ida como cualquier otro
        # comando, así que se repite hasta que llegue la confirmación.
        seen = bytearray()

        for _ in range(4):
            self._send('stop')
            self._drain(into=seen)
            if _ended(seen):
                break
        else:
            raise CtrlLinkError('el dispositivo no contesta a "stop" -- sigue '
                                'emitiendo, o dejó de escuchar; desenchufar y '
                                'volver a enchufar la placa')

        return self.sync(timeout=max(1.0, deadline - time.monotonic()))

    def _drain(self, into=None, settle=0.15, timeout=1.0):
        """Lee del puerto hasta que no quede nada que leer.

        Que no quede nada es que el puerto pase `settle` segundos callado, o que
        `into` —donde se va acumulando lo leído, si se lo pasa— ya contenga la
        respuesta completa a un `stop`, que es lo último que el dispositivo tiene
        para decir. Devuelve False si se agotó `timeout` con el dispositivo
        todavía hablando, que es lo que pasa cuando el flujo no paró.
        """
        deadline = time.monotonic() + timeout
        quiet_since = time.monotonic()

        while True:
            now = time.monotonic()
            waiting = self.ser.in_waiting

            if waiting:
                chunk = self.ser.read(waiting)
                if into is not None:
                    into += chunk
                    if _ended(into):
                        return True
                quiet_since = now
            elif now - quiet_since >= settle:
                return True
            elif now >= deadline:
                return False
            else:
                time.sleep(0.005)

    # ------------------------------------------------------------- comandos

    def _readline(self, deadline) -> str | None:
        """Una línea, o None una vez pasado `deadline`."""
        while time.monotonic() < deadline:
            raw = self.ser.readline()
            if raw:
                return raw.decode('ascii', 'replace').rstrip('\r\n')
        return None

    def _send(self, line):
        """Escribe un comando con sus bytes espaciados. Ver _BYTE_GAP."""
        for byte in (line + '\n').encode('ascii'):
            self.ser.write(bytes([byte]))
            if _BYTE_GAP:
                _pause(_BYTE_GAP)
        self.ser.flush()

    def cmd(self, line, timeout=2.0, tries=3) -> list[str]:
        """Envía un comando y devuelve las líneas de su respuesta, terminador incluido.

        Una respuesta que diga que el dispositivo no entendió el comando significa
        que se perdieron bytes en el camino de ida, así que el comando se
        reenvía. Un error que signifique que el dispositivo entendió y objetó se
        levanta de inmediato.

        Las filas de telemetría que lleguen mientras la respuesta está en vuelo se
        descartan, así que es seguro llamar a esto en medio de una captura; pero
        durante una captura conviene el argumento `events` de capture(), que
        conserva las filas.
        """
        with self._hold():
            return self._cmd(line, timeout, tries)

    def _cmd(self, line, timeout, tries):
        for attempt in range(tries):
            self._send(line)

            deadline = time.monotonic() + timeout
            reply = []

            while True:
                text = self._readline(deadline)
                if text is None:
                    raise CtrlLinkError(f'se agotó la espera de una respuesta a {line!r}')
                if not text.startswith('#'):
                    continue  # una fila de telemetría que se adelantó a la respuesta
                reply.append(text)
                if not text.startswith(_TERMINATORS):
                    continue

                if not text.startswith('# err'):
                    return reply

                reason = text[6:]
                if attempt + 1 < tries and self._es_deformacion(line, reason):
                    break  # el comando se deformó en tránsito; se manda de nuevo
                raise CtrlLinkError(f'{line!r}: {reason}')

    def _es_deformacion(self, line, reason):
        """Si el error significa que al dispositivo le llegó otra cosa de la que se mandó.

        Los tres de _GARBLED lo significan siempre. «no existe ese parametro» sólo
        si el nombre que se mandó SÍ está en la tabla: entonces lo que no existe es
        lo que llegó, no lo que se pidió, y reintentar es lo correcto. Sin esto, un
        byte perdido adentro del nombre --la deformación más probable que hay-- se
        trataría como una objeción legítima y el `set` no se reintentaría.
        """
        if any(g in reason for g in _GARBLED):
            return True

        if _GARBLED_SI_EXISTE not in reason:
            return False

        campos = line.split()
        return len(campos) > 1 and campos[1] in self.__dict__.get('_params', {})

    def sync(self, timeout=4.0) -> str:
        """Vacía lo que el dispositivo estuviera diciendo y confirma que escucha."""
        deadline = time.monotonic() + timeout
        while time.monotonic() < deadline:
            self.ser.reset_input_buffer()
            try:
                for text in self.cmd('id', timeout=0.5):
                    if text.startswith('# id '):
                        return text[5:]
            except CtrlLinkError:
                continue
        raise CtrlLinkError('no hubo respuesta a "id" -- puerto equivocado, '
                            'velocidad equivocada, o el sketch no está '
                            'corriendo CtrlLink')

    # ----------------------------------------------------------- descubrimiento

    def _descubrir(self):
        """Confirma que el dispositivo escucha y lee su identidad, parámetros y canales."""
        self.info = self.sync()
        # `_params` se asigna al final a propósito: es lo que __setattr__ usa para
        # decidir si un nombre es un parámetro, y mientras no exista los atributos
        # normales del objeto se asignan sin pasar por esa comprobación.
        params = self._read_params()
        self.channels = self._read_channels()
        self._params = params

    def _read_params(self) -> dict:
        """nombre -> Param, tal como los declara el dispositivo.

        El formato es el del propio dispositivo: guarda cada parámetro en la forma
        de punto fijo que su aritmética prefiera y dice cuántos bits fraccionarios
        son. Todo lo que está por encima de esta línea trabaja en unidades
        naturales y nunca ve el entero.
        """
        params = {}
        for text in self.cmd('params'):
            if not text.startswith('# p '):
                continue

            fields = text[4:].split(None, 3)
            if len(fields) < 4:
                # Un sketch grabado con una versión de CtrlLink anterior al
                # punto fijo declara los parámetros sin la columna de bits
                # fraccionarios. Conviene decirlo explícitamente: si no, lo que
                # se ve es un ValueError de desempaquetado, que no indica la causa.
                raise CtrlLinkError(
                    f'el dispositivo declara sus parámetros en un formato '
                    f'anterior ({text!r}): tiene grabado un sketch desactualizado. '
                    f'Volver a grabarlo -- sync_board(force_upload=True) lo hace.')

            name, type_, frac, _value = fields
            params[name] = Param(name, type_, int(frac))
        return params

    def _read_channels(self) -> list[Column]:
        """La tabla de canales, verificada contra lo que el propio dispositivo declara.

        El índice de cada línea y el total que informa `id` se comparan en lugar de
        descartarse. La máscara de _select_channels() se arma con la posición en
        ESTA lista, así que una línea perdida correría la tabla entera: se pediría
        el canal `e` y volvería `y` rotulado `e`, sin un solo aviso.
        """
        chans = []
        for text in self.cmd('chans'):
            if not text.startswith('# c '):
                continue
            indice, name, type_, scale, *unit = text[4:].split()
            if int(indice) != len(chans):
                raise CtrlLinkError(
                    f'la tabla de canales llegó incompleta: el canal {name!r} dice '
                    f'ser el número {indice} y va en la posición {len(chans)}. '
                    f'Se perdió una línea en el cable; volver a conectar.')
            if type_ not in _TYPES:
                raise CtrlLinkError(
                    f'el canal {name!r} declara un tipo que este módulo no conoce '
                    f'({type_!r}): se deformó en el cable, o el sketch habla una '
                    f'versión más nueva del protocolo.')
            chans.append(Column(name, type_, float(scale),
                                unit[0] if unit else ''))

        for field in self.info.split():
            if field.startswith('chans='):
                if int(field[6:]) != len(chans):
                    raise CtrlLinkError(
                        f'el dispositivo declara {field[6:]} canales y describió '
                        f'{len(chans)}: se perdió alguna línea en el cable. '
                        f'Volver a conectar.')
                break

        return chans

    @property
    def dt(self) -> float:
        """Período de control en segundos, preguntado al dispositivo y no supuesto.

        Se mueve cuando se mueve `loop_div`, y cualquier conversión entre
        magnitudes de tiempo continuo y por muestra necesita el valor vigente.
        """
        for field in self.cmd('id')[0].split():
            if field.startswith('dt_us='):
                return int(field[6:]) * 1e-6
        raise CtrlLinkError('el dispositivo no informó su período de control')

    def _del_diagnostico(self, metodo, *args):
        """Lo que el colaborador conteste a `metodo`, o nada si no hay colaborador.

        Todos sus métodos son opcionales, así que un objeto que sólo sepa nombrar
        parámetros no tiene que además saber redactar notas.
        """
        fn = getattr(self._diag, metodo, None) if self._diag is not None else None
        return fn(*args) if fn is not None else ()

    @property
    def _health(self) -> tuple:
        """Los contadores acumulados que este dispositivo exponga, como (clave, param).

        Se deduce de la tabla de parámetros en lugar de guardarse en caché, así
        que acompaña a un dispositivo que se haya conectado a mano y no a través
        de __init__.
        """
        pairs = tuple(_HEALTH) + tuple(self._del_diagnostico('parametros_de_salud'))
        return tuple((k, p) for k, p in pairs if p in self._params)

    @property
    def _state(self) -> tuple:
        """Las lecturas de ahora que exponga, como (clave, param). No se ponen en cero."""
        pairs = tuple(self._del_diagnostico('parametros_de_estado'))
        return tuple((k, p) for k, p in pairs if p in self._params)

    @property
    def _config(self) -> tuple:
        """Las perillas que cambian lo que se mide, de las que este dispositivo tenga."""
        return tuple(p for p in self._del_diagnostico('parametros_de_configuracion')
                     if p in self._params)

    @property
    def params(self) -> dict:
        """Cada parámetro y su valor actual, releídos del dispositivo."""
        return {name: self.get(name) for name in self._params}

    def get(self, name):
        """El valor del parámetro, en unidades reales.

        El nombre que devuelve el dispositivo se compara en lugar de descartarse: el
        protocolo ya lo manda, verificarlo es gratis, y es la única deformación que
        produce una respuesta bien formada. Sin esto, `get('ref')` podía devolver el
        valor de `mode`.
        """
        for text in self.cmd(f'get {name}'):
            if text.startswith('# v '):
                echoed, value = text[4:].split(None, 1)
                self._mismo_nombre(name, echoed)
                return self._coerce(name, value)
        raise CtrlLinkError(f'no hay valor en la respuesta para {name!r}')

    @staticmethod
    def _mismo_nombre(pedido, contestado):
        if contestado != pedido:
            raise CtrlLinkError(
                f'se preguntó por {pedido!r} y el dispositivo contestó por '
                f'{contestado!r}: la respuesta se deformó en el cable.')

    def set(self, name, value, tries=3):
        """Fija un parámetro, en unidades reales, y confirma lo que guardó el dispositivo.

        Un comando corrompido en general se rechaza de plano, pero un *valor*
        deformado se aceptaría en silencio, así que el valor devuelto se verifica
        en lugar de darse por bueno. La verificación contempla la cuantización del
        propio dispositivo: un parámetro guardado en punto fijo no puede contener
        todos los valores que se le pidan, y redondear al representable más cercano
        es lo correcto, no un error.
        """
        stored = None

        for _ in range(tries):
            for text in self.cmd(f'set {name} {self._encode(name, value)}'):
                if not text.startswith('# v '):
                    continue
                nombre, echoed = text[4:].split(None, 1)
                self._mismo_nombre(name, nombre)
                stored = self._coerce(name, echoed)
                if self._agrees(name, stored, value):
                    return stored
                break

        raise CtrlLinkError(
            f'se fijo {name} en {value!r} pero el dispositivo '
            f'informa {stored!r}')

    def _encode(self, name, value):
        """Unidades reales -> el entero (o float) que el dispositivo quiere en el cable.

        Se verifica que entre en el tipo del dispositivo ANTES de mandarlo: allá hay
        un strtol y un cast, así que un valor que no entra queda guardado deformado
        y nadie lo restituye. Con punto fijo se llega mucho antes de lo que parece,
        y el mensaje habla del pedido y no del almacenamiento.
        """
        param = self._params[name]

        if not param.integral:
            # Nueve cifras redondean un float32 sin pérdida, y dejan la línea muy por
            # debajo del largo máximo de un comando: str(float) de un número chico
            # con exponente se pasa.
            return f'{float(value):.9g}'

        raw = int(round(float(value) * 2.0 ** param.frac))
        lo, hi = _LIMITS.get(param.type, (None, None))
        if lo is not None and not lo <= raw <= hi:
            escala = param.scale if param.frac else 1
            raise CtrlLinkError(
                f'{value!r} no entra en {name}, que el dispositivo guarda como '
                f'{param.type} con {param.frac} bit(s) fraccionarios: el rango va de '
                f'{lo * escala:g} a {hi * escala:g}.')
        return raw

    def _coerce(self, name, text):
        """El entero (o float) del cable -> unidades reales."""
        param = self._params[name]

        if not param.integral:
            return float(text)
        raw = int(text)
        return raw * param.scale if param.frac else raw

    def _agrees(self, name, stored, requested):
        try:
            wanted = float(requested)
        except (TypeError, ValueError):
            return False

        param = self._params[name]

        # Un parámetro entero guarda el representable más cercano a lo pedido, así
        # que el eco puede apartarse medio paso y nada más. Sin holgura relativa: en
        # un entero grande como `ang_lutw` (unos 4e6) el 1e-6 de abajo dejaría pasar
        # un eco deformado en ±4.
        if param.integral:
            return abs(float(stored) - wanted) <= param.scale / 2

        # Un `f32` guarda exactamente lo que se le pide; la holgura es para los seis
        # decimales con los que lo imprime. Su `frac` es 0 por convención, así que
        # el medio paso de un entero sería 0,5 y desarmaría la verificación.
        return abs(float(stored) - wanted) <= max(5e-7, abs(wanted) * 1e-6)

    # Los parámetros como atributos, para que en un notebook se lea
    # `dev.kp = 2.5`. Todo lo que no esté en la tabla del dispositivo cae en el
    # manejo normal de atributos.
    def __getattr__(self, name):
        params = self.__dict__.get('_params', {})
        if name in params:
            return self.get(name)
        raise AttributeError(name)

    def __setattr__(self, name, value):
        params = self.__dict__.get('_params', {})
        if name in params:
            self.set(name, value)
            return

        # Un nombre que no está en la tabla y que tampoco es un atributo que este
        # objeto ya tenga es, casi siempre, un parámetro mal escrito. Dejarlo caer
        # en el manejo normal de atributos lo guardaría en el objeto, __getattr__ ni
        # se enteraría, y `dev.reff = 1000` se leería de vuelta como 1000 con la placa
        # sin enterarse. Con un motor del otro lado eso es creer que se bajó una
        # ganancia y que el lazo siga con la vieja.
        if params and not name.startswith('_') and name not in self.__dict__:
            raise AttributeError(
                f'{name!r} no es un parámetro del dispositivo ni un atributo de '
                f'este objeto, así que asignarlo no llegaría a la placa.'
                f'{_quiso_decir(name, params)}')

        super().__setattr__(name, value)

    def __dir__(self):
        return list(super().__dir__()) + list(self.__dict__.get('_params', {}))

    # -------------------------------------------------------------- captura

    def capture(self, duration, events=(), poll=0.005, warn=True, canales=None):
        """Emite durante `duration` segundos y devuelve un DataFrame.

        `canales` es la lista de canales que van en la captura, por nombre; por
        omisión, los que el dispositivo tenga activos, que al arrancar son todos.
        Cada canal cuesta bytes de cable y tiempo de CPU del lado del dispositivo
        --en un UNO, del orden de 10 us por byte--, así que emitir sólo los que se
        van a mirar es lo que permite subir la frecuencia del lazo; ver el techo
        medido en la sección «El enlace» del README. Las columnas
        salen en el orden de la tabla del dispositivo, no en el de la lista, y la
        selección anterior se restituye al terminar, así que la celda siguiente
        recibe lo mismo que habría recibido sin ésta.

        `events` es una secuencia de (retardo_s, nombre, valor): cada parámetro se
        fija esa cantidad de segundos después de que arranca el flujo. El
        dispositivo informa el tick exacto en el que cayó cada set, así que la
        fluctuación de programación de la computadora no entra en la medición; ver
        `df.attrs['marks']`.

        Los contadores de salud del dispositivo se ponen en cero antes de la
        corrida y se leen después, así que `df.attrs` dice si el lazo realmente
        llegó mientras se producían estas filas en particular. Todo problema
        detectado además se imprime, porque una captura que perdió períodos en silencio se ve
        exactamente igual que una que no hasta que uno va a fijarse. Pasar
        `warn=False` para tener los números sin el comentario.

        Si la captura se interrumpe —el botón de parar del notebook, un
        Ctrl-C—, el dispositivo queda callado igual antes de que la excepción
        llegue a la celda: ver _hold().
        """
        # _select_channels publica el valor previo acá adentro y no lo devuelve: si
        # la interrupción cae DENTRO de ella --entre el `set chans` y la lectura de
        # su respuesta-- el dispositivo ya aplicó la máscara nueva y un valor
        # devuelto no llegaría a nadie, así que no se restituiría nada y la captura
        # siguiente volvería con las columnas que dejó ésta.
        self._chans_previo = None

        try:
            with self._hold():
                self._select_channels(canales)
                df = self._capture(duration, events, poll, warn)
        except BaseException:
            # _hold() ya dejó el enlace limpio, así que restituir es un comando
            # común. Si ni eso sale, la excepción que viene es la noticia.
            if self._chans_previo is not None:
                try:
                    self.set('chans', self._chans_previo)
                except Exception:
                    pass
            raise
        finally:
            previo, self._chans_previo = self._chans_previo, None

        if previo is not None:
            self.set('chans', previo)

        return df

    def _select_channels(self, canales):
        """Activa sólo `canales` y deja en `_chans_previo` la máscara que había.

        Sin `canales` no toca nada.
        """
        if canales is None:
            return

        if isinstance(canales, str):
            canales = [canales]

        if 'chans' not in self._params:
            raise CtrlLinkError(
                'el dispositivo no permite elegir canales: tiene grabada una '
                'versión de CtrlLink anterior a `chans`. Volver a grabar el sketch.')

        names = [c.name for c in self.channels]
        unknown = [c for c in canales if c not in names]
        if unknown:
            raise CtrlLinkError(f'no hay canales llamados {unknown}; los que hay son {names}')

        mask = 0
        for name in canales:
            mask |= 1 << names.index(name)

        # Se publica ANTES de emitir el `set`: a partir de ahí la máscara puede
        # estar cambiada, y quien limpie tiene que saber a qué volver.
        self._chans_previo = self.get('chans')
        self.set('chans', mask)

    def _capture(self, duration, events, poll, warn):
        pending = sorted(events, key=lambda e: e[0])

        for _clave, param in self._health:
            self.set(param, 0)

        self.ser.reset_input_buffer()
        header = self.cmd('start')
        columns, dt_us, dec = self._parse_header(header)

        buf = bytearray()
        started = time.monotonic()
        deadline = started + duration

        while True:
            now = time.monotonic()

            while pending and now - started >= pending[0][0]:
                _, name, value = pending.pop(0)

                # Con el formato del parámetro, igual que set(): un evento habla
                # las mismas unidades reales que el resto de la interfaz, y sin
                # esto un `ref` en punto fijo sale 2**frac veces más chico. Lo que
                # este camino sí saltea es la confirmación, y a propósito: en
                # medio de una captura no hay respuesta que esperar sin comerse la
                # serie temporal. El `# mark` que devuelve el dispositivo trae el
                # valor que efectivamente guardó, así que la verificación existe
                # igual, sólo que después y en los datos.
                self._send(f'set {name} {self._encode(name, value)}')

            if now >= deadline:
                break

            chunk = self.ser.read(max(1, self.ser.in_waiting))
            if chunk:
                buf += chunk
            elif not pending:
                time.sleep(poll)

        # Seguir leyendo hasta que el dispositivo confirme que paró, para tener a
        # mano tanto la cola del flujo como los recuentos finales de filas. Tiene
        # que estar la línea entera, no sólo sus primeros bytes: esperar apenas el
        # prefijo "# end" le entrega al decodificador una línea cortada a mitad de
        # campo.
        #
        # Un "stop" se puede perder en el camino de ida como cualquier otro
        # comando, y no hay respuesta contra la cual reintentar hasta que el flujo
        # efectivamente termine, así que simplemente se repite hasta que el
        # dispositivo conteste.
        for _ in range(4):
            self._send('stop')

            tail_deadline = time.monotonic() + 1.5
            while not _ended(buf) and time.monotonic() < tail_deadline:
                chunk = self.ser.read(max(1, self.ser.in_waiting))
                if chunk:
                    buf += chunk
                else:
                    time.sleep(poll)

            if _ended(buf):
                break
        else:
            raise CtrlLinkError('el dispositivo no dejó de emitir')

        # Duración real de la ventana de emisión, medida entre el momento en que
        # el dispositivo confirmó `start` y aquel en que confirmó `stop`. Es la
        # única referencia de tiempo independiente que hay: los ticks los cuenta
        # el dispositivo y avanzan una vez por período *atendido*, así que
        # dividir filas por ticks da el período nominal pase lo que pase y no
        # puede delatar un lazo que no llega.
        wall = time.monotonic() - started

        df = self._decode(buf, columns, dt_us, dec)
        df.attrs['wall'] = wall

        # Se leen una vez que el flujo paró, no durante: un `get` en medio de una
        # captura cuesta milisegundos de tráfico de comandos, que es justamente lo
        # que se está midiendo.
        df.attrs.update(self.health())

        # Con qué configuración se midió, tal como quedó al terminar la captura. Es
        # lo que ensayo.guardar() escribe arriba del CSV.
        df.attrs['config'] = dict({'dispositivo': getattr(self, 'info', '')},
                                  **{p: self.get(p) for p in self._config})
        df.attrs['health'] = self._health_notes(df)

        if warn:
            for note in df.attrs['health']:
                print(f'ctrllink: {note}', file=sys.stderr)

        return df

    def health(self):
        """Los contadores de salud del dispositivo y su estado, como dict.

        Vacío si el sketch no expone ninguno.
        """
        return {clave: self.get(param)
                for clave, param in self._health + self._state}

    def _health_notes(self, df):
        """Avisos legibles sobre una captura, el más grave primero.

        Todo lo que hay acá es una forma de que la serie temporal esté mal sin
        parecerlo: un período perdido es una muestra que el controlador nunca
        calculó, y una fila descartada es una que calculó y nunca envió. Ninguna de
        las dos deja marca en los datos mismos.

        Y todo lo que hay acá es del protocolo y del lazo, no del equipo. Lo que
        dependa del hardware lo redacta el colaborador, y va antes o después de esto
        según importe más o menos que un período perdido.
        """
        notes = list(self._del_diagnostico('notas_primero', df))
        dt_us = df.attrs['dt_us']
        rate = 1e6 / dt_us if dt_us else 0

        missed = df.attrs.get('missed') or 0
        if missed:
            notes.append(
                f'se perdieron {missed} período(s) de control '
                f'({missed / max(rate, 1):.3f} s de tiempo de lazo): el '
                f'muestreador volvió a pasar antes de que se atendiera el tick '
                f'anterior, así que esos períodos directamente no corrieron. '
                f'Emitir menos canales con capture(..., canales=[...]) --cada '
                f'fila le cuesta al lazo más que el cálculo de control--, bajar '
                f'la frecuencia del lazo, o sacarle trabajo al paso de control.')

        if missed and dt_us:
            notes.append(
                f'el eje `t` quedó {missed * dt_us * 1e-6:.3f} s corto: los ticks '
                f'avanzan una vez por período ATENDIDO, así que un período perdido '
                f'no deja hueco y no se ve en los datos. Toda constante de tiempo '
                f'que se identifique de acá sale chica en esa proporción. '
                f'`df.attrs["wall"]` tiene la duración real de la ventana.')

        late = df.attrs.get('maxlate')
        if late is not None and dt_us and late > dt_us * _LATE_WARN:
            # El retardo se mide desde el primer tick sin atender, así que puede
            # valer muchos períodos: con un 7530 %, decir «llegó, pero por poco»
            # sería exactamente al revés.
            veces = late / dt_us
            cola = ('el lazo llegó, pero por poco.' if veces < 2 else
                    'o sea que el lazo se atrasó ' + f'{veces:.1f} períodos enteros.')
            notes.append(
                f'peor retardo de atención {late} us contra un período de '
                f'{dt_us} us ({veces:.0%}): {cola}')

        # El eje de tiempo contra el reloj de pared, que es la única referencia
        # independiente que hay. Cualquier forma de que los dos se separen --no sólo
        # un período perdido-- aparece acá.
        wall = df.attrs.get('wall')
        tick = df.attrs.get('tick')
        if wall and dt_us and tick is not None and len(tick) > 1:
            span = (int(tick[-1]) - int(tick[0]) + df.attrs.get('dec', 1)) * dt_us * 1e-6
            if abs(span - wall) > max(0.05 * wall, 4 * dt_us * 1e-6):
                notes.append(
                    f'el eje `t` abarca {span:.3f} s y la ventana de emisión duró '
                    f'{wall:.3f} s: los ticks y el reloj de pared no coinciden, así '
                    f'que el eje de tiempo de esta captura no es de fiar.')

        basura = df.attrs.get('basura') or 0
        if basura:
            notes.append(
                f'se descartaron {basura} línea(s) que no eran ni comentario ni '
                f'fila: algo más está escribiendo en el puerto, o se perdieron '
                f'bytes. Las filas que sí llegaron se decodificaron igual.')

        if df.attrs.get('dec_movido'):
            notes.append(
                '`dec` se movió durante la captura, así que el paso entre ticks no '
                'es uno solo y no se buscaron huecos en la secuencia.')

        drops = df.attrs.get('drops') or 0
        if drops:
            notes.append(
                f'se descartaron {drops} fila(s) de telemetría: el dispositivo no '
                f'tenía lugar en su buffer de transmisión. Subir dec, o emitir '
                f'menos canales con capture(..., canales=[...]).')

        sent = df.attrs.get('rows')
        if sent and len(df) < sent:
            notes.append(
                f'{sent - len(df)} de {sent} fila(s) enviadas nunca llegaron: se '
                f'perdieron bytes entre el dispositivo y acá.')

        gaps = df.attrs.get('gaps') or 0
        if gaps and not (drops or (sent and len(df) < sent)):
            notes.append(f'{gaps} hueco(s) en la secuencia de ticks: faltan filas '
                         f'en la serie temporal.')

        return notes + list(self._del_diagnostico('notas_despues', df))

    def _marca_del_escalon(self, df, name, value):
        """La marca del escalón de `name` en la captura, y su fila.

        El `set` del evento se manda sin verificar a propósito --verificarlo costaría
        tráfico en medio de la captura-- porque el `# mark` que devuelve el
        dispositivo trae el valor que efectivamente guardó. Si no está, esa
        verificación no ocurrió y el escalón puede no haber ocurrido tampoco: volver
        con un DataFrame de aspecto normal, con `t` medido desde el arranque y sin
        escalón adentro, es lo peor que se puede hacer.
        """
        filas = df.attrs.get('mark_rows') or [None] * len(df.attrs['marks'])
        marks = [(m, f) for m, f in zip(df.attrs['marks'], filas) if m[1] == name]
        if not marks:
            raise CtrlLinkError(
                f'el dispositivo nunca confirmó el escalón de {name!r}: no hay '
                f'ninguna marca en la captura. El `set` se perdió en el cable, así '
                f'que estos datos no tienen el escalón adentro.')

        marca, fila = marks[0]
        if not self._agrees(name, marca[2], value):
            raise CtrlLinkError(
                f'se pidió un escalón de {name} a {value!r} y el dispositivo marcó '
                f'{marca[2]!r}: el valor se deformó en el cable.')
        return marca, fila

    def step(self, name, value, pre=0.1, post=0.9, back=None, warn=True, canales=None):
        """Captura una respuesta al escalón, con `t = 0` en el escalón mismo.

        Mantiene `pre` segundos, pone `name` en `value`, y mantiene `post`
        segundos más. Si se da `back`, el parámetro se restituye al final.
        `canales` es como en capture().
        """
        try:
            df = self.capture(pre + post, events=[(pre, name, value)], warn=warn,
                              canales=canales)
            marca, fila = self._marca_del_escalon(df, name, value)
        except BaseException:
            # El escalón ya salió, o puede haber salido: ni interrumpir la captura ni
            # descubrir que la marca falta lo deshacen, y dejar un parámetro movido en
            # un dispositivo que sigue corriendo no es un estado en el que convenga
            # abandonarlo. El enlace ya quedó limpio para este punto, así que
            # restituir es un comando común; si aun así no se puede, la excepción que
            # viene saliendo es la noticia importante.
            if back is not None:
                try:
                    self.set(name, back)
                except Exception:
                    pass
            raise

        # Se desplaza en el espacio de ticks, no en segundos: restar dos float que
        # son cada uno un tick por un período deja un residuo de redondeo, y un t de
        # -5e-17 pone la muestra del escalón del lado equivocado de t < 0.
        origin = self._mark_tick(df, marca[0], fila)
        df['t'] = (df.attrs['tick'] - origin) * (df.attrs['dt_us'] * 1e-6)

        if back is not None:
            self.set(name, back)

        return df

    @staticmethod
    def _mark_tick(df, raw_tick, fila=None):
        """Tick desenrollado de una marca, que el dispositivo informa en 16 bits crudos.

        Los ticks del propio cuadro ya están desenrollados, así que los dos viven
        en espacios distintos y no se pueden restar sin más.

        `fila` es en qué fila de la captura llegó la marca, que es lo que desempata
        cuando hay más de un tick del cuadro cuyos 16 bits bajos coinciden --una
        captura de más de 65536 ticks, o sea 65 s a 1 kHz--. Sin desempatar se
        tomaría el primer candidato y el origen quedaría 65,5 s corrido.
        """
        tick = df.attrs['tick']

        if len(tick) == 0:
            return 0

        here = np.flatnonzero((tick & 0xFFFF) == raw_tick)
        if len(here):
            if len(here) == 1 or fila is None:
                return int(tick[here[0]])
            return int(tick[here[int(np.argmin(np.abs(here - fila)))]])

        # La diezmación o una fila descartada pueden dejar al tick marcado sin
        # fila propia; se lo ubica por cuánto queda pasado el primer tick de la
        # captura. La diferencia va CON SIGNO: la marca puede preceder al primer
        # tick del cuadro --las filas que más se descartan son justo las primeras,
        # porque el encabezado de `start` deja el buffer cargado-- y sin signo eso
        # daría 65536 - 1 y correría el origen 65,5 s.
        delta = ((raw_tick - (tick[0] & 0xFFFF) + 0x8000) & 0xFFFF) - 0x8000
        return int(tick[0] + delta)

    # ---------------------------------------------------------- decodificación

    @staticmethod
    def _parse_header(lines):
        columns, dt_us, dec = [], None, 1

        for text in lines:
            if text.startswith('# col '):
                name, type_, scale, *unit = text[6:].split()
                if type_ not in _TYPES:
                    # Acá todavía se está a tiempo: esto corre inmediatamente
                    # después de `start` y antes de que salga una sola fila. Sin
                    # esta comprobación el tipo se tocaría recién en _decode(), o
                    # sea un KeyError pelado después de toda la captura.
                    raise CtrlLinkError(
                        f'el encabezado declara el canal {name!r} con un tipo que '
                        f'este módulo no conoce ({type_!r}): se deformó en el cable, '
                        f'o el sketch habla una versión más nueva del protocolo.')
                columns.append(Column(name, type_, float(scale),
                                      unit[0] if unit else ''))
            elif text.startswith('# rate '):
                fields = dict(f.split('=') for f in text[7:].split())
                dt_us = int(fields['dt_us'])
                dec = int(fields['dec'])

        if not columns or dt_us is None:
            raise CtrlLinkError('el dispositivo no envió un encabezado de flujo utilizable')

        return columns, dt_us, dec

    def _decode(self, buf, columns, dt_us, dec):
        import pandas as pd

        dtype = np.dtype([(c.name, c.dtype) for c in columns])
        width = sum(c.width for c in columns)

        # println() emite CRLF y las filas emiten sólo LF; el hexadecimal nunca
        # contiene CR, así que descartar todos los CR de entrada uniformiza los dos
        # tipos de línea.
        lines = buf.replace(b'\r', b'').split(b'\n')

        marks, notes, mark_rows = [], [], []
        stats = {'rows': None, 'drops': None}
        rows = []
        basura = 0

        for line in lines:
            if line.startswith(b'#'):
                text = line.decode('ascii', 'replace')
                if text.startswith('# mark '):
                    tick, name, value = text[7:].split(None, 2)
                    if name not in self._params:
                        raise CtrlLinkError(
                            f'el dispositivo marcó un parámetro que no está en su '
                            f'tabla ({name!r}): la línea se deformó en el cable.')
                    marks.append((int(tick), name, self._coerce(name, value)))
                    # En qué fila de la captura cayó. El tick de una marca viaja en
                    # 16 bits crudos, y en una captura de más de 65536 ticks hay más
                    # de una fila que le corresponde: esto dice cuál.
                    mark_rows.append(len(rows))
                elif text.startswith('# note '):
                    notes.append(text[7:])
                elif text.startswith('# end '):
                    stats.update((k, int(v)) for k, v in
                                 (f.split('=', 1) for f in text[6:].split()
                                  if '=' in f))
            elif len(line) == width and not line.translate(None, _HEXDIG):
                rows.append(line)
            elif line:
                # Una línea que no es ni comentario ni fila: medir lo mismo que una
                # fila no alcanza para entrar, porque bytes.fromhex() tiraría la
                # captura entera con un ValueError que no dice qué línea fue. Se
                # cuentan y las informa _health_notes(), que es la maquinaria que
                # ya existe para esto.
                basura += 1

        raw = bytes.fromhex(b''.join(rows).decode('ascii')) if rows else b''

        # El cable es big-endian, así que frombuffer devuelve campos big-endian.
        # pandas se niega a indexarlos en una máquina little-endian, y algunos de
        # sus caminos devuelven los valores equivocados en silencio en lugar de dar
        # error, así que el arreglo se lleva al orden nativo antes de que nada más
        # lo toque.
        arr = np.frombuffer(raw, dtype=dtype).astype(dtype.newbyteorder('='))

        tick = self._unwrap(arr['tick'].astype(np.int64))

        df = pd.DataFrame({'t': tick * dt_us * 1e-6})
        for column in columns:
            if column.name == 'tick':
                continue
            values = arr[column.name]
            df[column.name] = values * column.scale if column.scale != 1.0 else values

        # Un hueco en la secuencia de ticks es una fila que el dispositivo descartó
        # o una que se perdió en el camino. En cualquier caso es un agujero en la
        # serie temporal, no una pausa.
        # `dec` sale del encabezado, que se imprime en `start`, pero el protocolo
        # permite moverlo durante el flujo: si se movió, el paso entre ticks deja de
        # ser uno solo y contar diferencias distintas de `dec` informaría huecos que
        # no existen: 63 en una captura de 140 filas enviadas y 140 recibidas.
        dec_movido = any(m[1] == 'dec' for m in marks)
        gaps = (0 if dec_movido or len(tick) <= 1
                else int(np.count_nonzero(np.diff(tick) != dec)))

        df.attrs.update(dt_us=dt_us, dec=dec, marks=marks, notes=notes,
                        gaps=gaps, tick=tick, mark_rows=mark_rows,
                        basura=basura, dec_movido=dec_movido,
                        units={c.name: c.unit for c in columns},
                        **stats)
        return df

    @staticmethod
    def _unwrap(tick):
        """Deshace la vuelta al cero del tick de 16 bits del dispositivo."""
        if len(tick) < 2:
            return tick
        wraps = np.concatenate([[0], np.cumsum(np.diff(tick) < 0)])
        return tick + wraps * 65536
