nicber/arduino-jupyter/python/catalogo.py

"""Qué significa cada parámetro de la placa, y cómo mostrarlo.

Es la mitad del banco que está escrita para una persona: la placa declara su tabla
al conectarse --nombre, tipo y escala, que es lo que la aritmética necesita-- y acá
está lo que hace falta para entenderla. Unidad, si se puede mover o sólo mirar, y una
línea de qué es.

Vive en un módulo propio y sin una sola dependencia. Lo usan las dos puntas, el
banco real y el simulado, y el simulado tiene que poder correr sin pyserial para que
la clase se pueda dar con el cable desenchufado.

Que no se desactualice no depende de la buena voluntad: `test_catalogo.py` compara
esta tabla contra la del sketch y falla si sobra o falta una entrada. Es la misma
idea que el golden de `test_tablas.py`.
"""

# Cada entrada es (clase, unidad, qué es). La clase va primera porque es lo primero
# que alguien quiere saber: contesta «¿esto lo puedo mover?».
#
#   perilla   se fija; es una decisión de quien hace el experimento
#   lectura   la placa la publica; escribirla no significa nada
#   cuenta    un total acumulado; ponerla en cero empieza a contar de nuevo
_CATALOGO = {
    # Lo único que mueve el motor.
    'ctl_uff':     ('perilla', '-255 a 255',  'el comando sobre el actuador; lo que salió efectivamente es el canal u'),

    # El actuador.
    'mot_bidir':   ('perilla', '0, 1',        '1 con puente en H; 0 con un solo cuadrante, y un comando negativo sale como cero'),

    # El sensor de ángulo y su calibración.
    'ang_inv':     ('perilla', '0, 1',        '1 si el ángulo se publica con el signo invertido; lo mide bringup()'),
    'ang_cal':     ('perilla', '0, 1',        '1 si la corrección de la tabla está aplicada'),
    'ang_lutw':    ('perilla', 'empaquetado', 'una entrada de la tabla: (índice << 16) | valor'),
    'ang_lutsum':  ('lectura', '',            'suma de Fletcher de la tabla: verifica las 64 con una lectura'),
    'ang_status':  ('lectura', 'bits',        'STATUS del AS5600: imán detectado, muy débil, muy fuerte'),
    'ang_present': ('lectura', '0, 1',        '0 si el sensor no contesta en el bus I2C'),
    'ang_agc':     ('lectura', '0 a 255',     'ganancia con la que lee; contra un extremo, imán mal montado'),
    'ang_mag':     ('lectura', 'cuentas',     'módulo del vector de campo que ve el sensor'),
    'ang_busovr':  ('cuenta',  'muestras',    'muestras que el bus I2C no llegó a seguir'),
    'ang_buserr':  ('cuenta',  'transferencias', 'transferencias del sensor que fallaron'),

    # La medición de corriente.
    'cur_zero':    ('perilla', 'cuentas ADC', 'el cero del sensor, en cuentas crudas del conversor y no en la unidad del canal i; `dev.zero_current()` lo mide'),
    'cur_frac':    ('lectura', 'bits',        'bits fraccionarios de la unidad del canal i: 4 son dieciseisavos de cuenta del conversor'),
    'cur_inv':     ('perilla', '0, 1',        '1 si la corriente se publica con el signo invertido; lo mide bringup()'),
    'cur_div':     ('perilla', '1/10000',     'relación del divisor de los 5 V del sensor en A1: la corriente sale de A0/A1; 0 = sin divisor, contra AVCC. La mide dev.medir_divisor() o la declara dev.declarar_divisor()'),
    'cur_a1':      ('lectura', 'cuentas',     'A1: la fracción de los 5 V del sensor que lee el divisor; 0 sin divisor'),
    'cur_notch':   ('perilla', 'máscara',     'notch de la red sobre la corriente, cada uno por separado: 1 = 50 Hz, 2 = 100 Hz, 4 = 150 Hz, 7 los tres, 0 ninguno (por omisión); dos notch por armónico, en 49,5 y 50,5 Hz, sin calibrar la red'),
    'cur_notchr':  ('perilla', '1/1000',      'radio del polo del notch: más cerca de 1, más angosto y más lento'),
    'cur_nyq':     ('perilla', '0, 1',        'notch en el Nyquist de las filas (250 Hz a 500 Hz), donde cae lo que queda del PWM: 1 prendido (por omisión), 0 apagado'),
    'cur_ma':      ('perilla', '0, 1',        'media de 4 ticks de 5 kHz, un período del PWM, antes de sumar la fila: 1 prendida (por omisión), 0 apagada'),
    'cur_filas':   ('perilla', 'filas',       'promedio de la corriente sobre tantas filas: 10 a 500 Hz son 20 ms y anulan la red y lo que queda del PWM; 1 = sólo la fila'),

    # El reloj del muestreo.
    'loop_div':    ('perilla', 'muestras',    'muestras de 5 kHz por fila: 10 son 500 Hz, 5 son 1 kHz'),
    'loop_late':   ('cuenta',  'us',          'peor retardo entre el disparo de un tick y su atención'),
    'loop_missed': ('cuenta',  'períodos',    'filas que la placa nunca llegó a atender'),

    # Del enlace y no del sketch: éste lo administra CtrlLink.
    'dec':         ('perilla', 'períodos',    'emitir una fila cada tantos períodos, para no saturar el cable'),
    'chans':       ('perilla', 'bits',        'qué canales van en la fila, uno por bit; mejor capture(..., canales=[...])'),
}

# Las perillas que no son de configuración: el comando es el experimento mismo --y
# ya viene en el canal u--, `ang_lutw` es un registro de escritura y las dos del
# enlace no cambian lo que se mide.
_NO_CONFIGURAN = ('ctl_uff', 'ang_lutw', 'dec', 'chans')

# Y una lectura que sí configura: la suma dice qué tabla estaba puesta.
_TABLAS = ('ang_lutsum',)


def de_configuracion():
    """Las perillas que cambian lo que mide una captura, en el orden de la tabla.

    Es lo que `df.attrs['config']` registra de cada captura, y lo que
    `ensayo.guardar()` escribe arriba del CSV.
    """
    return tuple(n for n, (clase, _, _) in _CATALOGO.items()
                 if (clase == 'perilla' and n not in _NO_CONFIGURAN) or n in _TABLAS)


# El título de cada grupo, en el orden en que conviene leerlos: primero lo que se
# mueve para hacer un experimento, después lo que se mira.
_GRUPOS = (
    ('ctl',   'El comando'),
    ('mot',   'El actuador'),
    ('ang',   'El sensor de ángulo'),
    ('cur',   'La medición de corriente'),
    ('loop',  'El reloj del muestreo'),
    ('',      'El enlace'),
)


def catalogo_de(nombre):
    """Lo que se sabe de un parámetro: (clase, unidad, qué es).

    Devuelve una entrada vacía si no está, y no levanta excepción a propósito: un
    sketch puede declarar un parámetro que este archivo todavía no conozca, y eso
    tiene que salir como una fila sin explicación y no como una celda que no corre.
    De que la tabla esté completa se encarga `test_catalogo.py`.
    """
    return _CATALOGO.get(nombre, ('', '', ''))


def nombres_conocidos():
    """Los nombres que este catálogo explica. Lo usa el test que lo verifica."""
    return set(_CATALOGO)


def por_grupo(nombres):
    """Los nombres repartidos por grupo, en el orden de _GRUPOS.

    Un nombre que no caiga en ningún prefijo conocido va al último grupo, así que no
    desaparece de la lista por no haber sido previsto.
    """
    quedan = list(nombres)
    salida = []

    for prefijo, titulo in _GRUPOS:
        miembros = ([n for n in quedan if n.startswith(prefijo + '_')] if prefijo
                    else list(quedan))
        quedan = [n for n in quedan if n not in miembros]

        if miembros:
            salida.append((titulo, sorted(miembros)))

    return salida


# ------------------------------------------------------------------- la vista
#
# Las dos formas de mostrar lo mismo: texto para una terminal y una tabla para
# Jupyter. Las dos toman los mismos datos en lugar de un objeto, así que sirven igual
# para el banco real y para el simulado, y ninguna de las dos puntas tiene que
# saber de la otra.
#
#   encabezado  qué dispositivo es, en una línea
#   resumen     la segunda línea: frecuencias, cuántos canales
#   nombres     los parámetros que este dispositivo declara
#   valor_de    nombre -> texto con el valor de ahora
#   canales     [(nombre, escala, unidad)], o vacío

_AYUDA = (
    'para verificar el equipo: rest()  zero_current()  bringup()',
    'para medir: capture(segundos)  step(parámetro, valor)',
    'para procesar: ensayo.velocidad()  ensayo.normalizar()  ensayo.guardar()',
)


def texto(encabezado, resumen, nombres, valor_de, canales=()):
    """La descripción entera como texto plano."""
    lineas = [encabezado, '', resumen]

    for titulo, miembros in por_grupo(nombres):
        lineas += ['', titulo, '-' * len(titulo)]

        for nombre in miembros:
            clase, unidad, que_es = catalogo_de(nombre)
            lineas.append(f'  {nombre:<12} {valor_de(nombre):>12}  '
                          f'{unidad:<14} {clase:<8} {que_es}')

    if canales:
        lineas += ['', 'los canales que devuelve capture(), con su escala:']
        lineas += [f'  {n:<7} {escala:>12.5f} {unidad} por unidad del canal'
                   for n, escala, unidad in canales]

    return '\n'.join(lineas + [''] + list(_AYUDA))


def html(encabezado, resumen, nombres, valor_de, canales=()):
    """La misma descripción como tabla, que es lo que Jupyter muestra.

    Se arma a mano y no con pandas para no arrastrar el estilo de un DataFrame, que
    en una tabla de cuarenta filas de texto se lee peor que una lista. Los colores
    son los de la paleta de los notebooks, y los tres de `clase` son el punto: de un
    vistazo se ve qué se puede mover.
    """
    from html import escape

    COLOR = {'perilla': '#2a78d6', 'lectura': '#52514e', 'cuenta': '#eda100'}

    def celda(x, **estilo):
        css = ';'.join(f'{k.replace("_", "-")}:{v}' for k, v in estilo.items())
        return f'<td style="{css};padding:2px 12px 2px 0">{escape(str(x))}</td>'

    partes = [f'<div style="font-weight:600">{escape(encabezado)}</div>',
              f'<div style="color:#52514e">{escape(resumen)}</div>',
              '<table style="border-collapse:collapse;font-size:90%">']

    for titulo, miembros in por_grupo(nombres):
        partes.append('<tr><td colspan="5" style="padding:12px 0 2px;'
                      f'font-weight:600">{escape(titulo)}</td></tr>')

        for nombre in miembros:
            clase, unidad, que_es = catalogo_de(nombre)
            partes.append(
                '<tr>'
                + celda(nombre, font_family='monospace')
                + celda(valor_de(nombre), font_family='monospace', text_align='right')
                + celda(unidad, color='#52514e')
                + celda(clase, color=COLOR.get(clase, '#52514e'))
                + celda(que_es)
                + '</tr>')

    partes.append('</table>')

    if canales:
        partes.append('<div style="color:#52514e;padding-top:10px">canales de '
                      + escape(', '.join(f'{n} ({u})' for n, _e, u in canales))
                      + '</div>')

    partes += [f'<div style="color:#52514e;padding-top:4px">{escape(l)}</div>'
               for l in _AYUDA]
    return ''.join(partes)
