nicber/arduino-jupyter/ControlDemo/ControlDemo.ino

// Lazo de control de posición sobre CtrlLink, gobernado desde un notebook de
// Jupyter.
//
// Hardware:
// Arduino UNO
// Sensor de posición de efecto Hall: AS5600 (I2C)   SDA -> A4, SCL -> A5
// Medición de corriente (opcional): ACS712 en A0, y en A1 los 5 V que lo alimentan
// por un divisor resistivo, si la placa no funciona a 5 V
// Actuador (opcional): puente L298N, ENA -> 9 (PWM, 1250 Hz), IN1 -> 6, IN2 -> 7
//
// Este archivo no hace casi nada por sí mismo: arma los módulos, los cablea entre
// sí y publica sus parámetros. Cada cosa que se puede medir, accionar o ajustar
// tiene un dueño, y el dueño se lleva su estado adentro:
//
//   g_clock    el reloj del lazo          Sampler/SampleClock.h
//   g_adc      el conversor, encadenado    Sense/RowAdc.h
//   g_sense    la corriente con sentido: la ventana, el divisor, el cero, el notch
//                                          Sense/CurrentSense.h
//   g_current  la corriente que lee el lazo Control/LoopCurrent.h
//   g_sampler  el ángulo, muestreado y desenrollado en la ISR
//                                          AngleSensor/AngleSampler.h
//   g_lut      la corrección del ángulo    Calibracion/AngleLut.h
//   g_angle    la posición del lazo        Control/LoopAngle.h
//   g_health   qué se le puede creer al sensor  AngleSensor/SensorHealth.h
//   g_pid      la ley de control           Control/Pid.h
//   g_set      la referencia y el objetivo Control/Setpoint.h
//   g_motor    el puente                   Control/LoopDrive.h
//
// Lo que queda acá es lo que de verdad es de este sketch y de ningún módulo: qué
// pines, qué sensor, qué escalas, y el orden en el que las cosas arrancan.
//
// El Timer2 muestrea el AS5600 a 5 kHz; cada `loop_div` muestras se ejecuta la ley
// de control, así que la frecuencia del lazo es 5000/loop_div Hz y por omisión vale
// 500 Hz. De esa manera el muestreo mantiene un período rígido aun cuando el
// cálculo de control fluctúe. `loop_late` informa cuánta fluctuación hubo y
// `loop_missed` cuenta los períodos de control que se saltearon del todo.
//
// El ángulo y la corriente de cada período se congelan en la ISR, en el tick mismo,
// y no cuando loop() llega a atenderlo: si no, un paso atendido tarde calcularía con
// una medición de hasta `loop_late` después, y en un lazo cerrado ese retardo
// variable entra en la realimentación. Congelado, el ángulo tiene un retardo fijo de
// un tick (200 us), y la ventana de la corriente termina en el tick. Ver Banco.ino,
// donde se midió.
//
// La ley de control es aritmética entera de punta a punta; ver ControlMath. Y
// también lo es cada parámetro que lee: cada uno se guarda en la forma de punto
// fijo que la aritmética necesita, y la tabla de parámetros declara la escala
// que lo convierte. La computadora multiplica a la ida y divide a la vuelta, así
// que el alumno sigue escribiendo `dev.pid_kp = 0.5` y la ley de control no ejecuta
// una sola instrucción de punto flotante. El único punto flotante que queda es el de
// los coeficientes del notch de la red, que refresh_tuning() recalcula cuando la
// computadora escribe un parámetro, fuera del paso de control.
//
// Los nombres de los parámetros llevan un prefijo de módulo, y eso es lo que hace
// que una tabla de tres docenas de entradas planas diga quién es dueño de cada
// una: `pid_kp` contra `ang_offset` contra `mot_top`. La computadora los descubre
// en tiempo de ejecución, así que agregar una ganancia no cuesta nada del lado de
// Python.
//
// El puerto serie va a 1 Mbaud. En un AVR de 16 MHz ése es un divisor exacto
// (UBRR=1), a diferencia de 115200, que queda 2,1 % desviado. La telemetría
// sostiene esa velocidad con comodidad, pero los bytes entrantes llegan cada
// 10 us y el USART guarda sólo dos, así que entre el muestreador de 5 kHz y la
// interrupción de TWI de nI2C se pierde un pequeño porcentaje de los bytes de un
// comando enviado de corrido. La computadora espacia los bytes de comando para
// compensarlo; ver PROTOCOL.md. Los comandos son raros y diminutos, así que eso
// no cuesta nada.
//
// La tabla de canales entera son 47 bytes por fila, o el 24 % del enlace a 500 Hz,
// que es el "bastante por debajo de la mitad" que le gusta a este protocolo. Pero
// antes que el cable se acaba la CPU: formatear una fila y sacarla por la UART le
// cuesta a esta placa más que el paso PID. Por eso la computadora elige qué canales
// emitir en cada captura --`chans`, o `capture(..., canales=[...])` del lado de
// Python--. Los techos medidos en PROTOCOL.md son de Banco; éste corre además la ley
// de control, así que los suyos son más bajos y no están medidos con el muestreo del
// AS5600 a 5 kHz.
//
// Periféricos de los que se apropia este sketch: el Timer2, así que analogWrite()
// en los pines 3 y 11 y tone() dejan de funcionar; el Timer1, que modula el
// puente con su propio TOP, así que analogWrite() en los pines 9 y 10 y Servo
// dejan de servir; y el ADC, que se maneja directamente acá, así que no hay que
// llamar a analogRead(). El Timer0 sigue llevando millis(), pero a 1000 Hz en lugar
// de 976,6 Hz, así que millis() queda un 2,4 % rápido y el PWM de los pines 5 y 6 deja
// de servir (ver BoardStart/BoardClock.h).

#include <nI2C.h>

#include <AS5600.h>
#include <NI2CBus.h>
#include <BoardStart.h>
#include <CtrlLink.h>
#include <FixedPoint.h>
#include <FirstOrderFilter.h>

#include <AngleLut.h>
#include <AngleSampler.h>
#include <SensorHealth.h>
#include <CurrentSense.h>
#include <RowAdc.h>
#include <HBridge.h>
#include <LoopAngle.h>
#include <LoopCurrent.h>
#include <LoopDrive.h>
#include <Pid.h>
#include <SampleClock.h>
#include <Setpoint.h>

// -------------------------------------------------------------------- el banco

static const uint32_t BAUD           = 1000000;
static const uint16_t SAMPLE_HZ      = 5000;
static const int16_t  COUNTS_PER_REV = 4096;

// Actuador: un puente en H L298N. ENA lleva la magnitud por PWM y el par IN1/IN2
// el sentido. Se puede correr el lazo sin nada conectado acá: los pines conmutan
// igual y todo lo demás, telemetría incluida, se comporta idéntico.
//
// ENA va al pin 9 porque es OC1A, y el Timer1 es el único que queda libre: el
// Timer0 (pines 5 y 6) lleva millis() y el Timer2 (pines 3 y 11) es el muestreador
// de 5 kHz. IN1 e IN2 son salidas digitales comunes y pueden ir a cualquier pin. Ver
// HBridge.h.
static const uint8_t MOTOR_PWM_PIN = 9;     // ENA del L298N, OC1A
static const uint8_t MOTOR_IN1_PIN = 6;     // IN1
static const uint8_t MOTOR_IN2_PIN = 7;     // IN2

// El TOP del Timer1 con el que arranca el PWM del puente, que es la forma en que
// se guarda la frecuencia: f = 16 MHz / (2 * top). Se guarda el TOP y no los Hz
// por la misma razón por la que el divisor del lazo se guarda como divisor y no
// como frecuencia: es por lo que cuenta el hardware, es exacto, y la conversión la
// hace el lado que tiene la aritmética: `dev.mot_top` del lado del notebook.
//
// Por qué ~1 kHz y no 20 kHz con un L298N: notebooks/hardware.ipynb, sección 2.1.
// Por qué 1250 Hz, lo mismo que en Banco: son exactamente 4 ticks del muestreador de
// 5 kHz, que sale del mismo reloj, y la media de 4 ticks de RowAdc (`cur_ma`) tiene
// ceros en todos los armónicos del PWM; lo que se pliega igual cae en el Nyquist de
// los períodos, donde va el notch de `cur_nyq`. Las dos cosas valen para este TOP:
// con otro `mot_top` hay que volver a elegirlas, o apagarlas. Con un puente MOSFET
// --un TB6612FNG, un DRV8833-- se podría modular mucho más rápido.
static const uint16_t PWM_TOP_DEFAULT = 6400;   // 1250 Hz

// Medición de corriente en A0. Nada de este bloque entra en la ley de control
// salvo que alguien ponga el objetivo en corriente: sobre todo fija las unidades
// que se le informan a la computadora.
static const uint8_t SENSE_CHANNEL = 0;
static const uint8_t SUPPLY_CHANNEL = 1;

// La sensibilidad del sensor, que es lo único que convierte cuentas en amperes.
// 185 mV/A es un ACS712-05B conectado directo, que es como está pensado el banco.
// Atención si no cierra con lo que mide un tester en serie con el motor: un reposo muy
// por debajo de los 2500 mV que da un ACS712 alimentado a 5 V delata un divisor en
// la salida, y un divisor divide las dos cosas a la vez --el cero y la
// sensibilidad--, así que ahí va 185 dividido por lo mismo.
static const float SENSE_MV_PER_A = 185.0f;

// El ADC convierte de corrido contra AVCC y cada período del lazo promedia todas sus
// conversiones: una conversión suelta cae siempre en la misma fase del PWM, y la
// corriente adentro del período es un escalón de cientos de mA. Contra AVCC, porque
// es donde un ACS712 --bipolar y ratiométrico-- reposa con margen para los dos
// sentidos. La corriente de base del transistor carga la alimentación del micro y
// corre la lectura mientras conduce; con el divisor de los 5 V del sensor en A1 y
// `cur_div`, la corriente sale de A0/A1 y eso se cancela: ver Sense/SupplyRatio.h. Las
// referencias internas del LGT8F328P se probaron y no sirven con el I2C del AS5600
// funcionando: ver Sense/RowAdc.h.
//
// Todo cuenta en la escala de SupplyRatio en las dos placas: una cuenta equivalente son
// 1,25 mV en la entrada, así que con 185 mV/A son 6,8 mA --27 en el UNO, que cuenta de
// a cuatro--. Acá el canal publica cuentas enteras y no dieciseisavos como en Banco:
// las ganancias del PID de LoopCurrent están afinadas en cuentas.
static const uint16_t ADC_FULL         = 4096;
static const int16_t  SENSE_ZERO       = ADC_FULL / 2;
static const float    SENSE_MA_PER_LSB =
    (float)SupplyRatio::UV_PER_COUNT / SENSE_MV_PER_A;

// Un período: una ventana larga atrasa el lazo.
static const uint8_t CURRENT_ROWS = 1;

// Son dos elecciones independientes, y vale la pena mantenerlas separadas.
//
// `ctl_mode` elige el controlador: la ley que convierte un error en un comando.
// `ctl_target` elige la realimentación: sobre qué magnitud medida cierra esa ley.
// Un controlador es un caso en control_step(); una realimentación es una rama en
// measured_value(). Ninguno de los dos sabe del otro.
enum : uint8_t
{
    MODE_OPEN = 0,      // u = ctl_uff, controlador puenteado
    MODE_PID  = 1,      // PID sobre la magnitud seleccionada
    MODE_RAMP = 2,      // PID, con la referencia avanzando por período
};

// La referencia está siempre en las unidades crudas de la magnitud seleccionada:
// cuentas para POSITION, LSBs del ADC para CURRENT.
enum : uint8_t
{
    TARGET_POSITION = 0,
    TARGET_CURRENT  = 1,
};

// ------------------------------------------------------------------ los módulos

typedef AS5600<NI2CBus>                                        Sensor;
typedef AngleLut<COUNTS_PER_REV, 64>                           Lut;
typedef LoopAngle<COUNTS_PER_REV>                              Angle;
typedef LoopDrive<HBridge<MOTOR_PWM_PIN, MOTOR_IN1_PIN, MOTOR_IN2_PIN> > Motor;
typedef RowAdc<SENSE_CHANNEL, SUPPLY_CHANNEL>                  Adc;

// Los divisores por omisión: 10 muestras de 5 kHz por período de control son
// 500 Hz de lazo.
static SampleClock  g_clock(10);
static Adc          g_adc;
static CurrentSense g_sense(SENSE_ZERO, CURRENT_ROWS);
static LoopCurrent  g_current;
static Lut          g_lut;
static Angle        g_angle;
static AngleSampler<Sensor, COUNTS_PER_REV> g_sampler;
static SensorHealth g_health;
static Pid          g_pid;
static Setpoint     g_set(MODE_OPEN, TARGET_POSITION);
static Motor        g_motor(PWM_TOP_DEFAULT);

// ------------------------------------------------ lo que es de este sketch y de nadie

// El filtro lento interno del AS5600, y lo último que de verdad se le escribió.
//
// Son dos campos y no dos globales sueltas, y ninguno es un static escondido
// adentro de la función de ajuste: escribirle al sensor puede fallar --viaja por el
// bus-- y entonces el intento siguiente tiene que volver a probar, así que hace
// falta saber qué quedó puesto. Ver AS5600::write_slow_filter().
struct SensorFilter
{
    uint8_t want;       // el parámetro que fija la computadora
    uint8_t applied;    // lo último que el sensor aceptó
};

// SF_2X es el más rápido: el retardo de respuesta al escalón son 0,286 ms contra
// los 2,2 ms de 16x, y para un lazo esos 1,9 ms son mucho más caros que el ruido.
static SensorFilter g_sfilt = { 3, 0xFF };

// Una sola instancia de la escritura, para setup() y para refresh_tuning(): este sketch
// va justo de flash.
static bool __attribute__((noinline)) write_sensor_filter(void)
{
    return Sensor::write_slow_filter(g_sfilt.want, g_clock);
}

// Lo que la placa mide de sí misma al arrancar, publicado para que la computadora
// no tenga que adivinarlo. Ver BoardStart.h.
struct BoardFacts
{
    uint16_t adcfs;     // fondo de escala real del conversor de esta placa
    uint16_t bgadc;     // el canal interno contra Vcc, en cuentas
    uint16_t malsb;     // mA por cuenta de `i` en esta placa, en Q8
    uint8_t  bus;       // estado eléctrico de las líneas del bus al arrancar
};

static BoardFacts g_board = { ADC_FULL, 0, 0, 0 };

// 1 si la cuenta de este período repite la anterior: la transferencia del AS5600
// que tenía que traerla no terminó a tiempo. El mismo canal que en Banco.
static uint8_t g_y_rep = 0;

// La cuenta cruda del sensor, sin corregir, sin offset y sin el signo invertido.
// Es lo que indexa la tabla de calibración, así que es lo que la computadora
// necesita para calcularla: reconstruirla desde el ángulo desenrollado se puede,
// pero deshacer un signo y un offset a mano es justo el lugar donde una
// calibración sale espejada y nadie se da cuenta hasta el final.
static uint16_t g_y_raw = 0;

// Prende y apaga la corrección en caliente, que es lo que permite medir cuánto
// sirve en lugar de suponerlo.
static uint8_t g_cal = 0;

// Una entrada de la tabla de calibración por escritura. Ver AngleLut::apply().
static uint32_t g_lutw = Lut::NOTHING;

// Los polos de los tres filtros. El estado filtrado vive adentro de cada módulo,
// pero el polo es un parámetro y se publica desde acá: alpha = dt / (tau + dt), una
// fracción en [0, 1]. alpha = 1 deja pasar la señal tal cual, que es la manera de
// apagar un filtro. Una computadora que piense en constantes de tiempo hace la
// conversión, porque es el lado que conoce dt.
//
// Juntos y no cada uno al lado de su módulo, para que se vea que son tres del mismo
// tipo y que los tres se aplican en el mismo lugar.
static int32_t g_alpha_y = Angle::Alpha::from_int(1).raw();                  // posición
static int32_t g_alpha_i = LoopCurrent::Alpha::from_float(0.1667f).raw();   // corriente
static int32_t g_alpha_e = Pid::Alpha::from_float(0.0909f).raw();            // error

// El contador de escrituras que se vio la última vez. Es de este archivo y no
// static adentro de una función, por la misma razón que todo lo demás: estado
// escondido en un lugar donde nadie lo busca.
static uint16_t g_last_writes = 0;

// ------------------------------------------------------------ la calibración

// La tabla NO se guarda en la placa. El dispositivo arranca siempre sin calibrar,
// y quien tiene la tabla es la computadora, que la empuja al conectarse --ver
// extras/calibracion_as5600/calib.py--. Es una decisión, no una limitación de memoria:
//
//   - Una calibración es una propiedad del *banco* --este imán, en este eje, con
//     este sensor--, no de la placa. En un archivo se lee, se compara, se revisa
//     y entra en el repositorio; en la EEPROM es estado invisible que sobrevive
//     a la reprogramación y que nadie recuerda haber puesto.
//   - Un dispositivo que arranca sin corregir no puede mentirle a nadie. El caso
//     feo de la EEPROM no es la tabla que falta: es la tabla vieja, de otro
//     montaje, que se aplica en silencio.
//   - Y para el aula: la corrección se prende y se apaga con `ang_cal` mientras el
//     motor gira. Eso es lo que hace que se pueda mostrar.

// --------------------------------------------------------------------- tablas

// Cada entrada se guarda exactamente como la quiere la aritmética; la columna de
// escala es lo que le permite a la computadora seguir hablando en unidades
// naturales. El prefijo dice de qué módulo es el parámetro.
static const CtrlParam PROGMEM g_params[] =
{
    { "pid_kp",      CTRL_I32, &g_pid.kp,            Pid::Kp::FRAC     },
    { "pid_ki",      CTRL_I32, &g_pid.ki,            Pid::Ki::FRAC     },
    { "pid_kd",      CTRL_I32, &g_pid.kd,            Pid::Kd::FRAC     },
    { "pid_alpha",   CTRL_I32, &g_alpha_e,           Pid::Alpha::FRAC  },

    { "ctl_ref",     CTRL_I32, &g_set.ref,           Setpoint::FRAC    },
    { "ctl_rate",    CTRL_I32, &g_set.rate,          Setpoint::FRAC    },
    { "ctl_uff",     CTRL_I16, &g_set.uff,           0                 },
    { "ctl_mode",    CTRL_U8,  &g_set.mode,          0                 },
    { "ctl_target",  CTRL_U8,  &g_set.target,        0                 },

    { "mot_top",     CTRL_U16, &g_motor.top,         0                 },
    { "mot_bidir",   CTRL_U8,  &g_motor.bidir,       0                 },
    { "mot_inv",     CTRL_U8,  &g_motor.invert,      0                 },

    { "ang_offset",  CTRL_I16, &g_angle.offset,      0                 },
    { "ang_alpha",   CTRL_I32, &g_alpha_y,           Angle::Alpha::FRAC },
    { "ang_cal",     CTRL_U8,  &g_cal,               0                 },
    { "ang_sfilt",   CTRL_U8,  &g_sfilt.want,        0                 },
    { "ang_lutw",    CTRL_U32, &g_lutw,              0                 },
    { "ang_lutsum",  CTRL_U16, &g_lut.sum,           0                 },
    { "ang_y",       CTRL_I16, &g_angle.track.y,     0                 },
    { "ang_y_uw",    CTRL_I32, &g_angle.track.y_uw,  0                 },
    { "ang_status",  CTRL_U8,  &g_health.status,     0                 },
    { "ang_present", CTRL_U8,  &g_health.present,    0                 },
    { "ang_agc",     CTRL_U8,  &g_health.agc,        0                 },
    { "ang_mag",     CTRL_U16, &g_health.magnitude,  0                 },
    { "ang_busovr",  CTRL_U16, &g_health.overruns,   0                 },
    { "ang_buserr",  CTRL_U16, &g_health.errors,     0                 },

    { "cur_zero",    CTRL_I16, &g_sense.zero,              0                 },
    { "cur_inv",     CTRL_U8,  &g_sense.invert,            0                 },
    { "cur_alpha",   CTRL_I32, &g_alpha_i,           LoopCurrent::Alpha::FRAC },
    { "cur_filas",   CTRL_U8,  &g_sense.window.rows,       0                 },
    { "cur_div",     CTRL_U16, &g_sense.ratio.div_e4,      0                 },
    { "cur_a1",      CTRL_U16, &g_sense.ratio.supply,      0                 },
    { "cur_notch",   CTRL_U8,  &g_sense.notch.harmonics,   0                 },
    { "cur_notchr",  CTRL_U16, &g_sense.notch.pole_milli,  0                 },
    { "cur_nyq",     CTRL_U8,  &g_sense.notch.nyquist,     0                 },
    { "cur_ma",      CTRL_U8,  &g_adc.ma,                  0                 },
    { "cur_ma_lsb",  CTRL_U16, &g_board.malsb,       8                 },

    { "board_adcfs", CTRL_U16, &g_board.adcfs,       0                 },
    { "board_bgadc", CTRL_U16, &g_board.bgadc,       0                 },
    { "board_bus",   CTRL_U8,  &g_board.bus,         0                 },

    { "loop_div",    CTRL_U8,  &g_clock.divide,      0                 },
    { "loop_late",   CTRL_U16, &g_clock.late,        0                 },
    { "loop_missed", CTRL_U16, &g_clock.missed,      0                 },
};

static const float COUNTS_TO_DEG = 360.0f / COUNTS_PER_REV;

// Los canales NO llevan prefijo: son columnas de una serie temporal y viajan
// hasta un DataFrame, donde el nombre lo escribe quien grafica. Un prefijo ahí
// sería ruido en cada llamada a plot().
//
// `ref` y `e` están en las unidades crudas de lo que seleccione `ctl_target`, así
// que no llevan escala de ingeniería: declarar grados sería mentir apenas el lazo
// pase a corriente. La computadora multiplica por la escala de `y_uw` o la de `i`
// según corresponda.
static const CtrlChannel PROGMEM g_channels[] =
{
    { "ref",   CTRL_I32, &g_set.ref,      1.0f / (1 << Setpoint::FRAC), "tgt" },
    { "y_raw", CTRL_U16, &g_y_raw,        COUNTS_TO_DEG,    "deg" },
    { "y_uw",  CTRL_I32, &g_angle.track.y_uw, COUNTS_TO_DEG,    "deg" },
    { "y_rep", CTRL_U8,  &g_y_rep,        1.0f,             ""    },
    { "y_uwf", CTRL_I32, &g_angle.y_uwf,  COUNTS_TO_DEG,    "deg" },
    { "e",     CTRL_I16, &g_set.e,        1.0f,             "tgt" },
    { "u",     CTRL_I16, &g_motor.u,      1.0f,             "pwm" },
    { "i",     CTRL_I16, &g_current.i,    SENSE_MA_PER_LSB, "mA"  },
};

// ----------------------------------------------------------------------- la ISR

// Una muestra del sensor por tick, y en el tick de cada período se congela lo que
// el lazo va a usar. Cada módulo se lleva su estado.
ISR(TIMER2_COMPA_vect)
{
    // Lo que el ADC sumó en este tick, antes que nada: el ADC no interrumpe esta ISR.
    g_adc.close_tick();

    g_sampler.on_tick();

    if (g_clock.on_isr())
    {
        g_sampler.freeze();
        g_adc.close_row();
    }
}

// El ADC convierte de corrido, sin relación con el muestreador: cada conversión se
// suma al período en curso. Ver Sense/RowAdc.h.
ISR(ADC_vect)
{
    g_adc.on_conversion();
}

// ------------------------------------------------------------------- el lazo

// Lee los sensores y actualiza todas las variables medidas. Corre una vez por
// período de control cualquiera sea el modo, así que la telemetría sigue viva en
// lazo abierto.
//
// La corrección de la tabla se aplica acá y no adentro del seguimiento del ángulo:
// así el seguimiento no sabe que existe una calibración, y la decisión de corregir
// o no queda donde se toma. La tabla se indexa con la cuenta cruda, que es la
// única que conserva el ángulo de adentro de la vuelta.
//
// La corriente pasa por la misma cadena que en Banco (ver Sense/CurrentSense.h), y
// LoopCurrent la redondea a cuentas y la filtra para el lazo.
static void measure(void)
{
    uint16_t raw16;
    int32_t  raw_uw;
    bool     fresh;
    g_sampler.take(raw16, raw_uw, fresh);
    g_y_rep = !fresh;

    uint32_t sum, supply_sum;
    uint16_t n, supply_n;
    g_adc.row(sum, n, supply_sum, supply_n);

    g_sense.push(sum, n, supply_sum, supply_n);
    g_current.update(g_sense.i);

    const Lut::Counts raw = (Lut::Counts)raw16;

    g_y_raw = (uint16_t)raw;
    const int32_t corrected_uw = raw_uw - (g_cal ? g_lut.correction(raw) : 0);
    g_angle.update_unwrapped(corrected_uw);
}

// El despacho de la realimentación: sobre qué magnitud medida cierra el lazo.
static Setpoint::Value measured_value(void)
{
    if (g_set.target == TARGET_CURRENT)
    {
        return (Setpoint::Value)g_current.i;
    }

    // Posición. Con ang_alpha = 1 el filtro deja pasar la señal tal cual, así que
    // ésta es la cuenta desenrollada cruda salvo que la computadora haya pedido
    // suavizado.
    return (Setpoint::Value)g_angle.y_uwf;
}

static void control_step(void)
{
    measure();

    if (g_set.mode == MODE_RAMP)
    {
        // La rampa es el PID con una referencia móvil, así que es el PID más una
        // línea y no un controlador aparte.
        g_set.advance();
    }

    const Setpoint::Value e = g_set.error(measured_value());

    // Avisarle al controlador con qué configuración se está por correr. Reinicia si
    // cambió el modo *o* el objetivo, porque el integrador acumula en las unidades
    // de la magnitud realimentada. Ver Pid::configure().
    g_pid.configure(g_set.mode, g_set.target, e);

    Motor::Command u;

    switch (g_set.mode)
    {
        case MODE_PID:
        case MODE_RAMP:
            u = g_pid.step(e, g_motor.floor(), Motor::MAX, g_set.uff);
            break;

        // Lazo abierto: la computadora pone `ctl_uff` directamente sobre el
        // actuador. Éste es el modo para identificar la planta. Y un modo
        // desconocido cae acá a propósito: un error de tipeo en la computadora no
        // puede dejar el actuador gobernado por un controlador que nadie eligió.
        case MODE_OPEN:
        default:
            u = Pid::clamp(g_set.uff, g_motor.floor(), Motor::MAX);
            break;
    }

    g_motor.write(u);
}

// ---------------------------------------------------------------------- ajuste

// Aplica lo que la computadora acaba de escribir. Los parámetros llegan ya en la
// forma que quiere la aritmética --esa conversión es trabajo de la computadora--
// así que esto no hace más que avisarle a cada dueño que su parámetro se movió. Lo
// único caro es el notch de la red, que recalcula sus coeficientes en punto
// flotante; corre entre dos pasos de control, no adentro de uno.
//
// Una línea por dueño. Cada módulo se hace cargo de su propia detección de
// cambios, así que un barrido de ganancia no sacude el puente ni reescribe la
// tabla de calibración: eso vive adentro del que sabe por qué importa.
//
// Lo dispara el contador de escrituras de CtrlLink: una comparación de 16 bits por
// pasada de loop(), en lugar de vigilar parámetro por parámetro.
static void refresh_tuning(void)
{
    CtrlLink::set_period_us(g_clock.apply(SAMPLE_HZ));

    g_motor.apply();

    g_pid.refresh(Motor::MAX);
    g_pid.set_alpha(Pid::Alpha::from_raw(g_alpha_e));

    g_angle.set_alpha(Angle::Alpha::from_raw(g_alpha_y));
    g_current.set_alpha(LoopCurrent::Alpha::from_raw(g_alpha_i));

    g_lut.apply(g_lutw);

    g_sense.apply((float)SAMPLE_HZ / (float)g_clock.divide);
    g_adc.alternate(g_sense.ratio.active());

    // Siempre: si la cadena del ADC quedó parada, esto es lo único que la levanta.
    g_adc.reconfigure();

    // El filtro del sensor, sólo cuando cambió: escribirlo en cada `set pid_kp`
    // pararía el muestreador sin motivo. Sólo con el muestreador corriendo, porque
    // la lectura del CONF que precede a la escritura viaja en un tick de muestreo;
    // y nunca en medio de una captura, porque para el muestreador hasta 7 ms. Si la
    // escritura no sale, no se marca como aplicada y la escritura siguiente de
    // cualquier parámetro vuelve a probar.
    if (g_sfilt.want > Sensor::SF_2X)
    {
        g_sfilt.want = Sensor::SF_2X;
    }

    if (g_clock.running() && !CtrlLink::streaming() && g_sfilt.want != g_sfilt.applied
        && write_sensor_filter())
    {
        g_sfilt.applied = g_sfilt.want;
    }
}

// ------------------------------------------------------------------- Arduino

void setup()
{
    // El reloj antes que nada: si la placa no corre a 16 MHz, el UART de acá abajo
    // emite al ritmo equivocado y ni el mensaje de error llega. Ver BoardStart.h.
    board::clock_begin();

    // millis() en fase fija con el muestreador. Ver BoardStart/BoardClock.h.
    board::millis_1000hz();

    // El ancho del conversor primero, porque es lo que dice qué placa es; esa sonda
    // no necesita una referencia correcta, porque cae al CLKPR de arranque.
    g_board.adcfs = board::adc_full_scale();

    // Y enseguida la referencia, antes de cualquier cosa que mida. En una de las
    // dos placas del banco los bits REFS no la eligen, así que todo lo que se mida
    // antes de esta línea corre contra una referencia de resabio: el bandgap, y
    // sobre todo el estado eléctrico de las líneas del bus, que se juzga con
    // umbrales que son fracciones del fondo de escala.
    board::adc_select_vcc(g_board.adcfs >= ADC_FULL);

    g_board.bgadc = board::adc_bandgap();

    // La escala del canal de corriente, en Q8, para la computadora: la de RowAdc,
    // que es la misma en las dos placas.
    g_board.malsb = (uint16_t)(256.0f * SENSE_MA_PER_LSB + 0.5f);

    // El estado eléctrico del bus, antes de que el TWI tome las líneas. Desde el
    // protocolo, un cable al aire, un módulo sin alimentación y un corto contra
    // masa se ven los tres igual --el sensor no contesta-- y se arreglan en lugares
    // distintos. Medirlo cuesta cuatro conversiones y una sola vez.
    g_board.bus = board::bus_check(g_board.adcfs);

    // Y la falla que sobrevive a todo lo anterior: los dos cables cambiados entre
    // sí. El bus se ve impecable y no contesta nadie. Se pregunta antes de
    // destrabar, que es lo que después deja el bus en un estado conocido.
    if (board::responds_swapped(Sensor::DEVICE_ADDRESS))
    {
        g_board.bus |= board::BUS_SWAPPED;
    }

    board::bus_recover();

    // El puente: deja ENA abierto y las dos entradas de sentido en bajo, que es el
    // estado del que parte write().
    g_motor.begin();

    CtrlLink::set_id(F("ControlDemo"));
    CtrlLink::begin(BAUD,
                    g_params,   sizeof(g_params)   / sizeof(g_params[0]),
                    g_channels, sizeof(g_channels) / sizeof(g_channels[0]),
                    (uint32_t)g_clock.divide * 1000000UL / SAMPLE_HZ);

    // El conversor antes que refresh_tuning(), que lo reconfigura. Los dos filtros del
    // PWM arrancan prendidos, como en Banco.
    g_adc.begin(g_board.adcfs);
    g_sense.notch.nyquist = 1;
    g_adc.ma              = 1;
    refresh_tuning();

    Sensor::begin();
    g_clock.begin(SAMPLE_HZ);

    // El filtro del sensor, recién ahora: la lectura del CONF que precede a la
    // escritura viaja en un tick de muestreo, así que antes de esta línea no hay
    // quién la lleve. Unos pocos intentos, por si la primera muestra todavía no
    // salió; sin sensor en el bus se sigue igual.
    // Si no sale, `applied` queda distinto de `want` y refresh_tuning() vuelve a
    // probar con la próxima escritura de parámetro.
    for (uint8_t i = 0; i < 10 && g_sfilt.applied != g_sfilt.want; i++)
    {
        if (write_sensor_filter())
        {
            g_sfilt.applied = g_sfilt.want;
        }
        else
        {
            delay(2);
        }
    }

    CtrlLink::note(F("ControlDemo listo"));
}

void loop()
{
    if (g_clock.take())
    {
        control_step();

        g_health.accumulate(Sensor::overruns(), Sensor::errors(), Sensor::present());

        CtrlLink::emit();
    }

    // Después del paso de control, nunca antes: un `set` que caiga justo cuando se
    // dispara un tick quedaría de otro modo por delante de él.
    const uint16_t writes = CtrlLink::writes();
    if (writes != g_last_writes)
    {
        g_last_writes = writes;
        refresh_tuning();
    }

    // El montaje del imán, sólo entre capturas: cada lectura le cuesta al muestreo
    // dos muestras. Ver SensorHealth::refresh_mounting().
    if (!CtrlLink::streaming())
    {
        g_health.refresh_mounting<Sensor>(millis());
    }

    CtrlLink::poll();

    // Después de poll(): ver SampleClock::window().
    g_clock.window(CtrlLink::streaming());
}
