nicber/arduino-jupyter/python/test_ctrllink.py

"""Ejercita el módulo del lado computadora contra un dispositivo CtrlLink simulado byte a byte.

El simulacro reproduce lo que CtrlLink.cpp realmente pone en el cable —CRLF en las
líneas de println() y sólo LF en las filas de telemetría incluidos—, así que el
decodificador se prueba contra el encuadre real y no contra una versión idealizada.
"""
import sys, time
sys.path.insert(0, __import__("os").path.dirname(__file__) or ".")

import numpy as np

# La simulación del dispositivo vive en su propio módulo: la usan estas pruebas y
# también las de la calibración, y un archivo de pruebas que importa a otro corre
# al otro entero.
from fakeuno import PARAMS, CHANS, WIDTH, FakeUno, OldFakeUno, FakeSerial, connect



failures = []


def _raises(call, kind):
    try:
        call()
    except kind:
        return True
    except Exception:
        return False
    return False


def check(label, condition, detail=''):
    print(f'{"PASA " if condition else "FALLA"}  {label}' + (f'  -- {detail}' if detail and not condition else ''))
    if not condition:
        failures.append(label)


# ------------------------------------------------------------ descubrimiento
dev = connect(FakeUno())
check('se interpreta id', dev.info.startswith('CtrlLink 1 FakeUno'), dev.info)
check('se descubren los parámetros', set(dev._params) == set(PARAMS), str(dev._params))
check('se descubren los canales', [c.name for c in dev.channels] == ['ref', 'y', 'e', 'u'])
check('parámetro float tipado', dev._params['kp'].type == 'f32')
check('se descubre el formato del parámetro', dev._params['kq'].frac == 22
      and dev._params['kq'].scale == 2.0 ** -22, str(dev._params['kq']))

# ------------------------------------------------------- acceso a parámetros
dev.kp = 2.5
check('ida y vuelta de un float', abs(dev.kp - 2.5) < 1e-6, str(dev.kp))
dev.ref = 1024
check('ida y vuelta de un entero', dev.ref == 1024, str(dev.ref))
check('el entero sigue siendo entero', isinstance(dev.ref, int))
check('instantánea de parámetros', dev.params['kp'] == 2.5, str(dev.params))
try:
    dev.nonexistent
    check('un atributo desconocido levanta excepción', False)
except AttributeError:
    check('un atributo desconocido levanta excepción', True)

# ------------------------------------------------------------------ captura
dev.ref = 0
df = dev.capture(0.30)
check('la captura devolvió filas', len(df) > 100, f'{len(df)} filas')
check('columnas como se declararon', list(df.columns) == ['t', 'ref', 'y', 'e', 'u'], str(list(df.columns)))
check('sin huecos de tick', df.attrs['gaps'] == 0, str(df.attrs['gaps']))
check('el tiempo crece uniformemente',
      np.allclose(np.diff(df['t']), 1e-3, atol=1e-9), str(np.unique(np.diff(df['t']))[:3]))
check('coincide el conteo de filas del dispositivo', abs(df.attrs['rows'] - len(df)) <= 2,
      f"dispositivo {df.attrs['rows']} contra computadora {len(df)}")
check('se informan los descartes', df.attrs['drops'] == 0)
check('un canal escalado es float', df['y'].dtype == float)
check('un canal sin escalar sigue entero', np.issubdtype(df['u'].dtype, np.integer), str(df['u'].dtype))
check('se transportan las unidades', df.attrs['units']['y'] == 'deg')
check('las columnas están en el orden de bytes nativo',
      all(df[c].values.dtype.byteorder in '=|' for c in df.columns if c != 't'),
      str({c: df[c].values.dtype.str for c in df.columns}))
check('el indexado booleano funciona en todas las columnas',
      all(len(df[c][df['t'] > df['t'].median()]) > 0 for c in df.columns))

# ------------------------------------------------------------------- escalón
dev.ref = 0
df = dev.step('ref', 2048, pre=0.10, post=0.25)
marks = df.attrs['marks']
check('el escalón produjo una marca', len(marks) == 1 and marks[0][1] == 'ref', str(marks))
check('t es exactamente cero en el escalón', (df['t'] == 0.0).sum() == 1,
      str(df['t'].abs().min()))
check('la muestra del escalón no cuenta como previa',
      df['u'][df['t'] < 0].nunique() <= 1, str(df['u'][df['t'] < 0].unique()))
check('el escalón tiene datos previos al disparo', (df['t'] < 0).sum() > 50, str((df['t'] < 0).sum()))
check('el escalón tiene datos posteriores al disparo', (df['t'] > 0).sum() > 100, str((df['t'] > 0).sum()))
check('ref efectivamente dio el escalón', df['ref'].iloc[0] == 0 and df['ref'].iloc[-1] > 100,
      f"{df['ref'].iloc[0]} -> {df['ref'].iloc[-1]}")

# Un escalón sobre un parámetro en punto fijo tiene que llegar en unidades
# reales, igual que un `set`. El camino del evento no espera confirmación --en
# medio de una captura no hay respuesta que esperar-- así que la marca que
# devuelve el dispositivo es la única prueba de lo que realmente guardó, y es
# contra eso que se verifica.
dev.kq = 0.0
dfq = dev.step('kq', 1.5, pre=0.05, post=0.10)
mq = [m for m in dfq.attrs['marks'] if m[1] == 'kq']
check('un escalón en punto fijo llega en unidades reales',
      len(mq) == 1 and abs(mq[0][2] - 1.5) < 2.0 ** -22, str(dfq.attrs['marks']))
check('y el dispositivo lo guardó escalado', abs(dev.kq - 1.5) < 2.0 ** -22, str(dev.kq))
dev.kq = 0.0

check('la respuesta se establece hacia ref',
      abs(df['y'].iloc[-1] - df['ref'].iloc[-1]) < abs(df['y'].iloc[0] - df['ref'].iloc[-1]))
check('se aplicó el escalado', abs(df['ref'].max() - 2048 * 0.0878906) < 0.01, str(df['ref'].max()))

# ---------------------------------------------------------------- diezmado
dev.set('dec', 4)
dev.ref = 0
df = dev.capture(0.30)
check('se informa el diezmado', df.attrs['dec'] == 4)
check('separación de muestras diezmadas',
      np.allclose(np.diff(df['t']), 4e-3, atol=1e-9), str(np.unique(np.diff(df['t']))[:3]))
check('la corrida diezmada no tiene huecos', df.attrs['gaps'] == 0, str(df.attrs['gaps']))
dev.set('dec', 1)

# ------------------------------------------------------ elección de canales
from ctrllink import CtrlLinkError

dev.ref = 2048
df = dev.capture(0.20, canales=['u', 'y'])
check('se emiten sólo los canales pedidos', list(df.columns) == ['t', 'y', 'u'], str(list(df.columns)))
check('y en el orden de la tabla, no el de la lista', list(df.columns)[1:] == ['y', 'u'])
check('la fila angosta se decodifica sin huecos', len(df) > 100 and df.attrs['gaps'] == 0,
      f'{len(df)} filas, {df.attrs["gaps"]} huecos')
check('los valores son los de esos canales',
      abs(df['y'].iloc[-1] - 2048 * 0.0878906) < abs(df['y'].iloc[0] - 2048 * 0.0878906) + 1e-9
      and df['u'].abs().max() <= 255)
check('la selección anterior se restituye', dev._uno_raw('chans') == 0xFFFF, str(dev._uno_raw('chans')))

df = dev.capture(0.05)
check('sin canales= salen todos', list(df.columns) == ['t', 'ref', 'y', 'e', 'u'], str(list(df.columns)))

check('un canal que no existe se explica',
      _raises(lambda: dev.capture(0.05, canales=['y', 'nada']), CtrlLinkError))
check('y no toca la selección', dev._uno_raw('chans') == 0xFFFF, str(dev._uno_raw('chans')))

df = dev.capture(0.05, canales='u')
check('un solo canal puede ir como texto', list(df.columns) == ['t', 'u'], str(list(df.columns)))

# La máscara se toma en `start`: un `set chans` a mitad de captura no puede cambiar
# el ancho de las filas que ya se están leyendo con el encabezado de esta corrida.
df = dev.capture(0.20, events=[(0.05, 'chans', 1)])
check('cambiar chans durante el flujo no cambia la captura en curso',
      list(df.columns) == ['t', 'ref', 'y', 'e', 'u'] and df.attrs['gaps'] == 0,
      f'{list(df.columns)}, {df.attrs["gaps"]} huecos')
df = dev.capture(0.05)
check('vale para la captura siguiente', list(df.columns) == ['t', 'ref'], str(list(df.columns)))
dev.set('chans', 0xFFFF)

dfs = dev.step('ref', 1024, pre=0.05, post=0.10, back=0, canales=['y'])
check('step acepta canales=', list(dfs.columns) == ['t', 'y'], str(list(dfs.columns)))
check('y también restituye la selección', dev._uno_raw('chans') == 0xFFFF)

dev.set('chans', 0b0101)
df = dev.capture(0.05, canales=['u'])
check('restituye la selección que había, no todos', dev._uno_raw('chans') == 0b0101,
      str(dev._uno_raw('chans')))
dev.set('chans', 0xFFFF)

uno_c = FakeUno()
dev_c = connect(uno_c)
dev_c.ser.fail_read_after = 3          # se corta en plena captura
check('una captura con canales= interrumpida se interrumpe',
      _raises(lambda: dev_c.capture(0.40, canales=['y']), KeyboardInterrupt))
check('y deja la selección como estaba', uno_c.params['chans'][2] == 0xFFFF,
      str(uno_c.params['chans'][2]))

uno_v = FakeUno()
del uno_v.params['chans']              # un sketch sin el parámetro `chans`
dev_v = connect(uno_v)
check('un dispositivo sin chans lo explica en lugar de fallar sin explicación',
      _raises(lambda: dev_v.capture(0.05, canales=['y']), CtrlLinkError))
check('y sin canales= sigue funcionando', len(dev_v.capture(0.05)) > 10)
dev.ref = 0

# ------------------------------------------- vuelta al cero del tick de 16 bits
uno = FakeUno(start_tick=65500)
dev2 = connect(uno)
df = dev2.capture(0.20)
tick = df.attrs['tick']
check('el tick dio la vuelta durante la corrida', tick[0] < 65536 <= tick[-1], f'{tick[0]} .. {tick[-1]}')
check('el tick desenrollado es monótono', bool(np.all(np.diff(tick) == 1)))
check('el tiempo es monótono a través de la vuelta', bool(np.all(np.diff(df['t']) > 0)))

# ------------------------- escalón cuya marca cae del otro lado de la vuelta
uno = FakeUno(start_tick=65450)
dev4 = connect(uno)
dev4.ref = 0
df = dev4.step('ref', 2048, pre=0.10, post=0.20)
tick = df.attrs['tick']
check('el escalón con vuelta dio la vuelta', tick[0] < 65536 <= tick[-1], f'{tick[0]} .. {tick[-1]}')
check('el escalón con vuelta quedó en cero en la marca',
      abs(df['t'].abs().min()) < 1.5e-3, str(df['t'].abs().min()))
check('el escalón con vuelta tiene los dos lados',
      (df['t'] < 0).sum() > 50 and (df['t'] > 0).sum() > 50,
      f"{(df['t'] < 0).sum()} antes, {(df['t'] > 0).sum()} después")
check('en el escalón con vuelta ref efectivamente se movió',
      df['ref'].iloc[0] == 0 and df['ref'].iloc[-1] > 100)

# --------------------------------------------------------- entrada mal formada
uno = FakeUno()
dev3 = connect(uno)
uno.out += b'GARBAGE\nDEADBEE\n'          # filas de ancho equivocado antes del encabezado
df = dev3.capture(0.15)
check('se descartan las filas cortas', len(df) > 50 and df.attrs['gaps'] == 0, f'{len(df)} filas')

# ------------------------------------------------- parámetros en punto fijo
# El dispositivo los guarda como enteros; la computadora es el único lado que los
# ve alguna vez en unidades reales.
dev.kq = 0.5
check('un parámetro en punto fijo se guarda como entero',
      dev._uno_raw('kq') == 1 << 21, str(dev._uno_raw('kq')))
check('un parámetro en punto fijo se relee en unidades reales', abs(dev.kq - 0.5) < 1e-6, str(dev.kq))

dev.kq = -0.001
check('ida y vuelta de un punto fijo negativo', abs(dev.kq + 0.001) < 1e-6, str(dev.kq))

# Por debajo de la resolución del dispositivo: redondear al valor representable
# más cercano es la respuesta correcta, no una escritura fallida.
dev.kq = 1e-9
check('fijar por debajo de la resolución no levanta excepción', abs(dev.kq) < 1e-6, str(dev.kq))

dev.alpha = 0.1667
check('alpha cuantizado a Q16', dev._uno_raw('alpha') == round(0.1667 * 65536),
      str(dev._uno_raw('alpha')))
check('alpha se relee cerca', abs(dev.alpha - 0.1667) < 2 ** -17, str(dev.alpha))

check('dt leído del dispositivo', abs(dev.dt - 0.001) < 1e-9, str(dev.dt))

# --------------------------------------------------------------------- salud
# Una captura pone en cero los contadores que el dispositivo declara, así que lo
# que vuelve describe esa captura y no todo lo ocurrido desde que arrancó la placa.
#
# Cada contador tiene dos nombres: la clave con la que queda en df.attrs y el
# parámetro del dispositivo del que sale. El primero es el vocabulario del
# notebook y es estable; el segundo lleva prefijo de módulo y es del sketch.
uno = FakeUno()
uno.params['loop_missed'] = ('u16', 0, 77)     # resto de alguna corrida anterior
uno.params['loop_late']   = ('u16', 0, 900)
dev4 = connect(uno)

check('se descubren los contadores del lazo',
      dev4._health == (('missed', 'loop_missed'), ('maxlate', 'loop_late')),
      str(dev4._health))

df = dev4.capture(0.15)
check('los contadores de corridas anteriores se ponen en cero antes de la corrida', df.attrs['missed'] == 0
      and df.attrs['maxlate'] == 0, str(df.attrs['maxlate']))
check('una captura limpia no informa nada', df.attrs['health'] == [], str(df.attrs['health']))

# Ahora un dispositivo que pierde períodos, llega tarde y descarta filas mientras
# emite.
uno = FakeUno(unhealthy={'loop_missed': 12, 'loop_late': 950}, drops=4)
dev5 = connect(uno)
df = dev5.capture(0.15, warn=False)

check('se informan los períodos perdidos', df.attrs['missed'] == 12, str(df.attrs['missed']))
notes = ' | '.join(df.attrs['health'])
check('se explican los períodos perdidos', 'perdieron' in notes and '12' in notes, notes)
check('se explica la atención tardía', '950 us' in notes, notes)
check('se explican las filas descartadas', 'descartaron' in notes, notes)
check('health() los lee directamente', dev5.health()['missed'] == 12, str(dev5.health()))

import ctrllink as _cl

# ------------------------------------------- el enlace no sabe de ningún sensor
# Lo que sigue es la propiedad que hace que este módulo sirva para otro equipo:
# los avisos sobre una captura no nombran el AS5600 ni sus pines desde acá adentro.
#
# Un dispositivo con todas las fallas, y un enlace sin diagnóstico: lo que vuelve
# tiene que hablar del lazo y de nada más.
uno = FakeUno(unhealthy={'loop_missed': 5, 'ang_buserr': 3, 'ang_busovr': 7,
                         'ang_present': 0})
sin_diagnostico = connect(uno)
df = sin_diagnostico.capture(0.15, warn=False)
notes = ' | '.join(df.attrs['health'])

for palabra in ('AS5600', 'SDA', 'SCL', 'pull-up', 'motor', 'sensor', 'iman',
                'imán', 'angulo', 'ángulo'):
    check(f'un enlace sin diagnóstico no menciona {palabra}', palabra not in notes, notes)

check('y tampoco pide los contadores del sensor', sin_diagnostico._state == (), str(sin_diagnostico._state))
check('pero sí informa lo del lazo', 'perdieron' in notes, notes)

# ------------------------------------------------- sensor ausente en el bus
# Con un colaborador que sepa que hay un AS5600, en cambio, aparece todo eso. El
# estado dice si el sensor contesta *ahora*, que es lo que separa un imán mal
# montado -- el sensor contesta e informa un problema del imán -- de un sensor que
# no está.
from bench import DiagnosticoDeBanco

uno = FakeUno()
con_diag = connect(uno, diagnostico=DiagnosticoDeBanco())
check('con colaborador se descubren los contadores del sensor',
      con_diag._health == (('missed', 'loop_missed'), ('maxlate', 'loop_late'),
                           ('sovr', 'ang_busovr'), ('serr', 'ang_buserr')),
      str(con_diag._health))
check('y los parámetros de estado',
      con_diag._state == (('spres', 'ang_present'), ('mstat', 'ang_status')),
      str(con_diag._state))

uno = FakeUno(unhealthy={'ang_present': 0, 'ang_buserr': 2})
dev6 = connect(uno, diagnostico=DiagnosticoDeBanco())
df = dev6.capture(0.15, warn=False)
notes = ' | '.join(df.attrs['health'])
check('el sensor ausente se informa', df.attrs['spres'] == 0, str(df.attrs['spres']))
check('el sensor ausente se explica primero',
      df.attrs['health'] and 'no contesta' in df.attrs['health'][0], notes)
check('el sondeo al sensor ausente no se cuenta como intermitencia',
      'transferencia(s) del sensor' not in notes, notes)

# Con el sensor presente, en cambio, las fallas sueltas sí son intermitencias.
uno = FakeUno(unhealthy={'ang_buserr': 2})
dev7 = connect(uno, diagnostico=DiagnosticoDeBanco())
df = dev7.capture(0.15, warn=False)
notes = ' | '.join(df.attrs['health'])
check('con el sensor presente las fallas sueltas se informan',
      'transferencia(s) del sensor' in notes, notes)
check('los contadores sanos no generan avisos', 'desborde' not in notes, notes)

# El estado no se pone en cero antes de una captura: hacerlo sería inventar una
# lectura, y además dejaría el sensor diciendo "ausente" en cada corrida.
check('el estado no se pone en cero antes de la corrida',
      dev7._uno_raw('ang_present') == 1, str(dev7._uno_raw('ang_present')))

# ---------------------------------------------- fin de captura sin carrera
# El dispositivo contesta "# end ..." y después "# ok". Darse por satisfecho con
# el "# end" deja el "# ok" en el puerto, y el comando siguiente lo lee como su
# propio terminador y vuelve vacio.
check('_ended espera la línea que cierra',
      not _cl._ended(b'# end rows=149 drops=0\r\n'))
check('_ended con la respuesta completa',
      _cl._ended(b'# end rows=149 drops=0\r\n# ok\r\n'))
check('_ended con una fila delante',
      _cl._ended(b'0412CDB9\n# end rows=1 drops=0\r\n# ok\r\n'))

# ----------------------------------------------- duración real de la ventana
# La única referencia de tiempo independiente que hay: los ticks los cuenta el
# dispositivo y avanzan una vez por período *atendido*, así que filas sobre
# ticks da el período nominal pase lo que pase.
df = dev7.capture(0.20, warn=False)
check('la captura informa su duración real',
      0.20 <= df.attrs['wall'] < 0.20 * 4, str(df.attrs.get('wall')))

# ------------------------------------------------------ firmware desactualizado
uno_old = OldFakeUno()
dev8 = _cl.CtrlLink.__new__(_cl.CtrlLink)
dev8.ser = FakeSerial(uno_old)
try:
    dev8._descubrir()
    check('el firmware desactualizado se explica', False)
except Exception as exc:
    check('el firmware desactualizado se explica',
          isinstance(exc, _cl.CtrlLinkError) and 'sketch desactualizado' in str(exc), str(exc))

# ------------------------------------------------------------- portabilidad
# Dos cosas que funcionan en esta máquina y no funcionarían en otra, así que se
# verifican acá en lugar de que las descubra un alumno en una distinta.

class _FakePort:
    def __init__(self, device, vid=None):
        self.device, self.vid = device, vid


import serial.tools.list_ports as _lp

_real_comports = _lp.comports

# Los puertos se eligen por identificador de fabricante USB, no por como se
# llaman: COM3 en Windows, /dev/cu.usbmodem en macOS, /dev/ttyACM0 en Linux.
_lp.comports = lambda: [_FakePort('COM1'), _FakePort('COM3', vid=0x2341)]
check('se encuentra el puerto COM de Windows', _cl.find_port() == 'COM3', _cl.find_port())

_lp.comports = lambda: [_FakePort('/dev/cu.Bluetooth-Incoming-Port'),
                        _FakePort('/dev/cu.usbmodem1101', vid=0x2341)]
check('se ignora el puerto Bluetooth', _cl.find_port() == '/dev/cu.usbmodem1101',
      _cl.find_port())

# Algunas plataformas dejan vid sin cargar; el respaldo por nombre tiene que
# cubrir COM también.
_lp.comports = lambda: [_FakePort('COM3')]
check('el respaldo por nombre cubre COM', _cl.find_port() == 'COM3', _cl.find_port())

_lp.comports = lambda: [_FakePort('COM1', vid=1), _FakePort('COM3', vid=2)]
check('se rechazan los puertos ambiguos',
      _raises(lambda: _cl.find_port(), _cl.CtrlLinkError))
check('el hint desambigua', _cl.find_port('COM3') == 'COM3')

_lp.comports = _real_comports

# La separación entre bytes de comando es medio milisegundo. Antes de Python 3.11,
# time.sleep() en Windows redondea hacia arriba hasta el tic de 15,6 ms del
# sistema, lo que haría cada comando treinta veces más lento de lo previsto, así
# que las esperas cortas se hacen en vacío. La cota es lo bastante holgada como
# para no ser inestable en una maquina ocupada y sigue estando un orden de
# magnitud por debajo de la falla que previene.
_t0 = time.perf_counter()
for _ in range(200):
    _cl._pause(_cl._BYTE_GAP)
_each = (time.perf_counter() - _t0) / 200
check('las esperas cortas son realmente cortas', _each < 2e-3, f'{_each * 1e6:.0f} us cada una')
check('las esperas largas siguen durmiendo', _cl._SPIN_UNDER <= 2e-3, str(_cl._SPIN_UNDER))

# --------------------------------------------------------------------- banco
# Las convenciones del equipo, que se apoyan sobre el protocolo en lugar de estar
# dentro de él: los canales por nombre, y las unidades de un ensayo.
import bench
import ensayo
import tempfile
from pathlib import Path
import pandas as pd

rig = bench.Bench.__new__(bench.Bench)
rig.channels = [_cl.Column('y_uw', 'i32', 360.0 / 4096, 'deg'),
                _cl.Column('i',    'i16', 26.4,         'mA')]

check('un canal por nombre', rig.channel('i').scale == 26.4)
check('un canal desconocido levanta excepción',
      _raises(lambda: rig.channel('nope'), _cl.CtrlLinkError))

# Un eje que gira parejo a una vuelta por segundo, muestreado a 500 Hz, con el
# comando positivo: la velocidad tiene que dar 2*pi rad/s.
_t = np.arange(0, 1.0, 0.002)
_df = pd.DataFrame({'t': _t, 'y_uw': 360.0 * _t, 'u': np.full(len(_t), 204.0),
                    'i': np.full(len(_t), 100.0)})
_tv, _w = ensayo.velocidad(_df, ventana=0)
check('la velocidad sale en rad/s',
      np.allclose(_w, 2 * np.pi) and len(_w) == len(_t) - 1, str(_w[:3]))
check('el promedio no cambia una velocidad constante',
      np.allclose(ensayo.velocidad(_df, ventana=0.05)[1], 2 * np.pi))
check('el promedio es centrado: una rampa de velocidad no se atrasa',
      abs(ensayo.velocidad(pd.DataFrame({'t': _t, 'y_uw': 360.0 * _t ** 2}),
                           ventana=0.05)[1][250] - 2 * np.pi * 2 * _tv[250]) < 0.05)
_rampa = pd.DataFrame({'t': _t, 'y_uw': np.rad2deg(50.0 * _t ** 2)})
_tr, _wr = ensayo.velocidad(_rampa, ventana=0)
check('la diferencia central no atrasa: en una rampa de velocidad da 2at en t',
      np.allclose(_wr[:-1], 100.0 * _tr[:-1]), str(np.abs(_wr[:-1] - 100.0 * _tr[:-1]).max()))
_hueco = _rampa.drop(index=300).reset_index(drop=True)
_th, _wh = ensayo.velocidad(_hueco, ventana=0)
check('una fila perdida no se convierte en un pico: se divide por el tiempo real',
      np.abs(_wh[5:-5] - 100.0 * _th[5:-5]).max() < 0.2)
_df['y_uw'] = -_df['y_uw']
_n = ensayo.normalizar(_df, ventana=0)
check('normalizar no toca el signo: ya viene resuelto de la placa',
      np.allclose(_n['omega'], -2 * np.pi))
check('normalizar pone u en por ciento e i en amperes',
      abs(_n['u'].iloc[0] - 80.0) < 1e-9 and abs(_n['i'].iloc[0] - 0.1) < 1e-12)
check('normalizar trae las columnas de un ensayo', list(_n.columns) == ensayo.COLUMNAS)
with tempfile.TemporaryDirectory() as _tmp:
    _ruta = ensayo.guardar(_df, Path(_tmp) / 'sub' / 'e.csv', ventana=0)
    _leido = ensayo.cargar(_ruta)
check('guardar y cargar devuelven lo mismo',
      np.allclose(_leido.to_numpy(), _n.to_numpy(), rtol=1e-5, atol=1e-6))

# El archivo dice con qué configuración se midió.
_df.attrs['config'] = {'dispositivo': 'CtrlLink 1 Banco', 'loop_div': 10, 'cur_div': 2817}
with tempfile.TemporaryDirectory() as _tmp:
    _ruta = ensayo.guardar(_df, Path(_tmp) / 'c.csv', ventana=0.02)
    _texto = _ruta.read_text(encoding='utf-8')
    _leido = ensayo.cargar(_ruta)
    _pandas = pd.read_csv(_ruta, comment='#')
check('guardar escribe la configuración arriba de las columnas',
      '# loop_div: 10' in _texto and _texto.index('# loop_div') < _texto.index('t,u,'), _texto[:200])
check('cargar devuelve la configuración en attrs',
      _leido.attrs['config'].get('loop_div') == 10 and _leido.attrs['config'].get('cur_div') == 2817
      and _leido.attrs['config'].get('ventana') == 0.02
      and _leido.attrs['config'].get('dispositivo') == 'CtrlLink 1 Banco', str(_leido.attrs['config']))
check('pandas lo lee salteando el encabezado', list(_pandas.columns) == ensayo.COLUMNAS)


class _DiagConKp:
    def parametros_de_configuracion(self):
        return ('kp', 'ki', 'no_existe')


_devc = connect(FakeUno(), diagnostico=_DiagConKp())
_c1 = _devc.capture(0.1, warn=False).attrs['config']
_devc.kp = 1.25
_c2 = _devc.capture(0.1, warn=False).attrs['config']
_devc.step('kp', 2.0, pre=0.05, post=0.05, warn=False)
_c3 = _devc.capture(0.1, warn=False).attrs['config']
check('la captura registra la configuración que el dispositivo tiene',
      _c1.get('kp') == 0.5 and 'ki' in _c1 and 'no_existe' not in _c1, str(_c1))
check('un set se refleja en la captura siguiente', _c2.get('kp') == 1.25, str(_c2))
check('un evento de captura no deja la configuración anterior', _c3.get('kp') == 2.0, str(_c3))

# --------------------------------------------- celda cortada por el medio
# Lo que realmente pasa en un notebook: el botón de parar en mitad de una
# captura, un traceback a mitad de un `set`. El dispositivo queda emitiendo o el
# comando queda a medio escribir, y la celda siguiente encontraría el enlace en un
# estado inconsistente. La operación siguiente tiene que encontrar el enlace limpio sin reiniciar nada.

uno = FakeUno()
dev9 = connect(uno)
dev9.ser.fail_read_after = 3          # se corta en plena captura
check('la captura interrumpida propaga la interrupción',
      _raises(lambda: dev9.capture(0.40), KeyboardInterrupt))
check('la captura interrumpida detuvo el flujo del dispositivo', not uno.streaming)
check('la captura interrumpida dejó el enlace limpio', dev9._broken is False)

dev9.ref = 512
check('después de la interrupción se puede fijar un parámetro', dev9.ref == 512, str(dev9.ref))
df = dev9.capture(0.20)
check('después de la interrupción se puede volver a capturar',
      len(df) > 50 and df.attrs['gaps'] == 0, f"{len(df)} filas, {df.attrs['gaps']} huecos")

# Una excepción cualquiera, no una interrupción: el enlace no distingue, porque
# lo que lo ensucia es haberse cortado y no el motivo.
uno = FakeUno()
dev10 = connect(uno)
dev10.ser.fail_with = ValueError
dev10.ser.fail_read_after = 3
check('una excepción en plena captura sale a la celda',
      _raises(lambda: dev10.capture(0.40), ValueError))
check('una excepción en plena captura también detiene el flujo del dispositivo', not uno.streaming)
check('el enlace sobrevive a una excepción cualquiera', dev10.get('kp') == 0.5, str(dev10.get('kp')))

# Cortado a mitad de una línea de comando: los bytes que llegaron están en el
# buffer del dispositivo y se pegarían adelante del comando siguiente.
uno = FakeUno()
dev11 = connect(uno)
dev11.ser.fail_write_after = 3        # "set" enviado, el resto no
check('el comando interrumpido propaga la interrupción',
      _raises(lambda: dev11.set('ref', 1024), KeyboardInterrupt))
check('la media línea no corrompe el comando siguiente', dev11.kp == 0.5, str(dev11.kp))
check('el comando interrumpido no dejó la referencia a medias', dev11.ref == 0, str(dev11.ref))

# Un escalón interrumpido no deja la referencia en pie: `back` es donde el
# usuario indicó que quería terminar, y del otro lado del cable puede haber un
# motor empujando contra un tope.
uno = FakeUno()
dev12 = connect(uno)
dev12.ref = 0
dev12.ser.fail_read_after = 3
check('el escalón interrumpido propaga la interrupción',
      _raises(lambda: dev12.step('ref', 2048, pre=0.05, post=0.35, back=0),
              KeyboardInterrupt))
check('el escalón interrumpido restituye la referencia', dev12.ref == 0, str(dev12.ref))

# La limpieza se puede pedir a mano, para lo que este módulo no vio pasar.
uno = FakeUno()
dev13 = connect(uno)
dev13.cmd('start')
check('el dispositivo quedó emitiendo', uno.streaming)
dev13.resync()
check('resync detuvo el flujo del dispositivo', not uno.streaming)
check('resync deja el enlace usable', dev13.get('kp') == 0.5, str(dev13.get('kp')))

# Un enlace marcado como sucio se limpia automáticamente antes de mandar nada,
# aunque nadie haya llegado a limpiarlo en su momento (una segunda interrupción
# encima de la primera).
uno = FakeUno()
dev14 = connect(uno)
dev14.cmd('start')
dev14._broken = True
check('un enlace sucio se limpia antes del comando siguiente',
      dev14.get('kp') == 0.5 and not uno.streaming, str(uno.streaming))

# Un `stop` se puede perder en el camino de ida, y entonces el puerto en silencio
# no prueba nada: con `dec` alto una fila tarda más que cualquier ventana de
# silencio razonable. La limpieza espera la confirmación del `stop`, no el
# silencio, y lo reintenta hasta tenerla.
uno = FakeUno()
dev15 = connect(uno)
dev15.set('dec', 400)                 # una fila cada 400 ms
dev15.ser.deaf_after_fail = 6         # el primer "stop" de la limpieza se pierde
dev15.ser.fail_read_after = 2
check('la captura lenta interrumpida propaga la interrupción',
      _raises(lambda: dev15.capture(0.40), KeyboardInterrupt))
check('un stop perdido se reintenta hasta que el dispositivo confirma',
      not uno.streaming)
check('el enlace queda usable después del stop perdido',
      dev15.get('kp') == 0.5, str(dev15.get('kp')))
dev15.set('dec', 1)

# ---------------------------------------- el puerto no queda tomado si falla
# Un puerto serie es exclusivo. Si el descubrimiento falla después de abrirlo, el
# traceback de la celda sobrevive en sys.last_traceback y se queda con el puerto:
# el intento siguiente falla con "no se pudo abrir el puerto" y parece otra cosa.

class _MutePort:
    """Un puerto que abre pero del que no contesta nadie."""
    def __init__(self):
        self.is_open = True
        self.edges = []          # transiciones de DTR, que es lo que resetea la placa
        self._dtr = True
    @property
    def dtr(self):
        return self._dtr
    @dtr.setter
    def dtr(self, value):
        self._dtr = value
        self.edges.append(value)
    def readline(self):
        return b''
    def read(self, n=1):
        return b''
    @property
    def in_waiting(self):
        return 0
    def write(self, data):
        return len(data)
    def flush(self):
        pass
    def reset_input_buffer(self):
        pass
    def close(self):
        self.is_open = False


import serial

_opened = []
_real_serial, _real_sync = serial.Serial, _cl.CtrlLink.sync


def _mute_serial(*args, **kwargs):
    _opened.append(_MutePort())
    return _opened[-1]


def _mute_sync(self, timeout=4.0):
    raise _cl.CtrlLinkError('no hubo respuesta a "id"')


serial.Serial, _cl.CtrlLink.sync = _mute_serial, _mute_sync
try:
    check('un descubrimiento fallido se explica',
          _raises(lambda: _cl.CtrlLink('COM9', reset_wait=0.02), _cl.CtrlLinkError))
    _raises(lambda: _cl.CtrlLink('COM9', reset_wait=0), _cl.CtrlLinkError)
finally:
    serial.Serial, _cl.CtrlLink.sync = _real_serial, _real_sync

check('un descubrimiento fallido no se queda con el puerto',
      bool(_opened) and not _opened[0].is_open)

# Lo que resetea un UNO es el flanco de bajada de DTR, no que DTR quede activado.
# Abrir el puerto no alcanza: la línea puede venir activada de la conexión
# anterior, y entonces no hay flanco y la placa sigue corriendo con el estado que
# le dejó la corrida pasada.
check('la placa se resetea con un flanco de DTR y no con abrir el puerto',
      _opened[0].edges == [False, True], str(_opened[0].edges))
check('reset_wait=0 se engancha a un sketch que ya corre, sin resetear',
      _opened[1].edges == [], str(_opened[1].edges))

# ------------------------------------------------- error del lado dispositivo
try:
    dev3.cmd('bogus')
    check('un error del dispositivo levanta excepción', False)
except Exception as exc:
    check('un error del dispositivo levanta excepción',
          'comando desconocido' in str(exc), str(exc))

# -------------------------------------- lo que volvía mal sin quejarse
#
# Todo lo de acá tiene la misma forma: el dispositivo contesta algo bien formado
# pero equivocado, y la computadora lo daba por bueno. Un error del enlace que
# levanta excepción se ve; uno que devuelve un DataFrame de aspecto normal, no.


def _levanta(fn, tipos=(Exception,)):
    """(si levantó, el mensaje). Para afirmar sobre el mensaje y no sólo el tipo."""
    try:
        fn()
    except tipos as exc:
        return True, str(exc)
    return False, 'no levantó nada'


# Un f32 no tiene cuantización, así que la verificación de un `set` no puede
# aflojarse medio LSB entero para él: eso dejaba pasar 0,4 de error.
class _MienteEnFloat(FakeUno):
    def command(self, cmd):
        if cmd.startswith('set kp '):
            pedido = float(cmd.split()[2])
            self.params['kp'] = ('f32', 0, pedido)      # guarda lo que se le pide
            self.println(f'# v kp {pedido + 0.4:.6f}')  # e informa otra cosa
            self.println('# ok')
            return
        super().command(cmd)


dev_f = connect(_MienteEnFloat())
salto, msg = _levanta(lambda: dev_f.set('kp', 2.0))
check('un f32 informado con 0,4 de error no se acepta', salto, msg)

# Un entero no tiene más holgura que medio paso. Una relativa, sobre un valor del
# tamaño de una entrada empaquetada de la tabla (`ang_lutw`, unos 4e6), dejaría
# pasar un eco corrido en unas pocas cuentas.
class _MienteEnEntero(FakeUno):
    def __init__(self, veces, **kw):
        super().__init__(**kw)
        self.params['lutw'] = ('u32', 0, 0)
        self.veces = veces

    def command(self, cmd):
        if cmd.startswith('set lutw ') and self.veces:
            self.veces -= 1
            pedido = int(cmd.split()[2])
            self.params['lutw'] = ('u32', 0, pedido)
            self.println(f'# v lutw {pedido + 3}')
            self.println('# ok')
            return
        super().command(cmd)


salto, msg = _levanta(lambda: connect(_MienteEnEntero(veces=99)).set('lutw', 0x003F0123))
check('un entero grande informado con 3 cuentas de error no se acepta', salto, msg)
uno_e = _MienteEnEntero(veces=1)
dev_e = connect(uno_e)
check('y un eco deformado una vez se reintenta',
      dev_e.set('lutw', 0x003F0123) == 0x003F0123 and uno_e.veces == 0, str(dev_e.lutw))

# Un nombre mal escrito no puede quedarse en el objeto y leerse de vuelta: con un
# motor del otro lado eso es creer que se bajó una ganancia y que el lazo siga con
# la vieja.
dev_n = connect(FakeUno())
salto, msg = _levanta(lambda: setattr(dev_n, 'reff', 1000), (AttributeError,))
check('un parámetro mal escrito levanta en lugar de guardarse en el objeto', salto, msg)
check('y no llegó a la placa', dev_n.ref == 0, str(dev_n.ref))

# El nombre que devuelve `# v` se compara: es la única deformación que produce una
# respuesta bien formada.
class _ContestaOtroParametro(FakeUno):
    def command(self, cmd):
        if cmd == 'get ref':
            self.println('# v mode 77')
            self.println('# ok')
            return
        super().command(cmd)


salto, msg = _levanta(lambda: connect(_ContestaOtroParametro()).get('ref'))
check('un `# v` que contesta por otro parámetro se rechaza', salto, msg)

# La máscara de canales se arma con la posición en la tabla que armó la
# computadora, así que una línea perdida corría la tabla entera y se pedía un canal
# y volvía otro con el nombre del pedido.
class _PierdeUnCanal(FakeUno):
    def command(self, cmd):
        if cmd == 'chans':
            for i, (n, t, sc, u) in enumerate(CHANS):
                if i == 1:
                    continue
                self.println(f'# c {i} {n} {t} {sc:.7f} {u}'.rstrip())
            self.println('# ok')
            return
        super().command(cmd)


salto, msg = _levanta(lambda: connect(_PierdeUnCanal()))
check('una línea perdida de la tabla de canales se detecta', salto, msg)

# Un valor que no entra en el tipo del dispositivo queda guardado deformado y nadie
# lo restituye, así que se rechaza antes de mandarlo.
dev_r = connect(FakeUno())
salto, msg = _levanta(lambda: dev_r.set('ref', 40000))
check('un valor que no entra en el i16 se rechaza antes de mandarlo', salto, msg)
check('y el parámetro quedó donde estaba', dev_r.ref == 0, str(dev_r.ref))
salto, msg = _levanta(lambda: dev_r.set('kq', 1000))
check('y con punto fijo también: kq es i32 con frac 22, o sea +/-512', salto, msg)

# Una línea que no es hexadecimal pero mide lo mismo que una fila --un reinicio por
# brownout, un print de depuración-- tiraba la captura entera con un ValueError que
# no decía qué línea había sido.
class _EscupeBasura(FakeUno):
    def __init__(self, **kw):
        super().__init__(**kw)
        self._filas = 0

    def _pump(self):
        antes = len(self.out)
        super()._pump()
        if self.streaming and len(self.out) > antes:
            self._filas += 1
            if self._filas == 5:
                ancho = WIDTH['u16'] + sum(WIDTH[CHANS[i][1]] for i in self.active)
                self.out += (b'Z' * ancho) + b'\n'


df_b = connect(_EscupeBasura()).capture(0.2, warn=False)
check('una línea de basura del ancho justo no mata la captura', len(df_b) > 0,
      str(len(df_b)))
check('y se cuenta en lugar de pasar inadvertida', df_b.attrs.get('basura') == 1,
      str(df_b.attrs.get('basura')))

# El `set` de un evento se manda sin verificar a propósito, porque el `# mark` que
# devuelve el dispositivo ES la verificación. Si no llega, el escalón puede no haber
# ocurrido, y volver con un cuadro de aspecto normal es lo peor que se puede hacer.
class _SordoAlSet(FakeUno):
    def command(self, cmd):
        if self.streaming and cmd.startswith('set '):
            self.println('# ok')
            return
        super().command(cmd)


salto, msg = _levanta(
    lambda: connect(_SordoAlSet()).step('ref', 1000, pre=0.05, post=0.1, warn=False))
check('un escalón sin marca levanta en lugar de devolver datos sin escalón', salto, msg)

# «no existe ese parametro» sobre un nombre que SÍ está en la tabla es prueba de
# que se deformó en tránsito, no una objeción legítima: es lo que produce un byte
# perdido adentro del nombre, que es la deformación más probable que hay.
class _ComeUnaLetra(FakeUno):
    def __init__(self, **kw):
        super().__init__(**kw)
        self._primero = True

    def command(self, cmd):
        if cmd.startswith('set ref ') and self._primero:
            self._primero = False
            self.println('# err no existe ese parametro')
            return
        super().command(cmd)


dev_d = connect(_ComeUnaLetra())
dev_d.set('ref', 1000)
check('«no existe ese parametro» sobre un nombre de la tabla se reintenta',
      dev_d.ref == 1000, str(dev_d.ref))
salto, msg = _levanta(lambda: connect(FakeUno()).set('noexiste', 1))
check('y un nombre que de verdad no está en la tabla sigue levantando', salto, msg)

print()
print(f'{len(failures)} falla(s)' + (': ' + ', '.join(failures) if failures else ''))
sys.exit(1 if failures else 0)
