nicber/arduino-jupyter/python/banco_simulado.py

"""Un banco simulado, para poder dar la clase sin la placa.

Expone lo mismo que `Bench` --los parámetros como atributos, `capture()`,
`step()`, `bringup()`-- pero las capturas salen de un modelo en lugar de un
motor. Los notebooks corren el mismo código en los dos casos, y lo único que
cambia es de dónde vienen las filas.

El modelo sigue al banco real, no al de un libro, incluidas sus no
idealidades. El actuador es un transistor a masa con su diodo de rueda libre:
empuja y no frena, un comando negativo empujaría para el mismo lado --por eso,
con `mot_bidir` en cero, se recorta a cero igual que en la placa--, y con el
comando en cero el eje sigue por inercia hasta que lo para el rozamiento, que
tarda segundos. El motor no se reinicia entre capturas --sigue girando mientras
la computadora hace otra cosa, igual que el real--, así que un ensayo que no
espere a que el eje pare mide la cola del anterior.

Es simulado y lo indica. Tiene adentro un error de sensor y un motor elegidos de
antemano, así que "descubrirlos" no prueba nada sobre ningún banco; lo que prueba
es que el procedimiento encuentra lo que hay que encontrar. Cuando el banco
está, se usa el banco.
"""
import math
import time
from collections import namedtuple

import numpy as np
import pandas as pd

import bench
import catalogo
import tabla_angulo
from ctrllink import CtrlLinkError
from tabla_angulo import CUENTAS, GRADOS_POR_CUENTA

# El error de ángulo que este banco imaginario tiene adentro, en cuentas. El
# primero es el imán descentrado, el segundo la inclinación. Son los órdenes que
# la literatura anticipa y las amplitudes son las de un montaje imperfecto pero
# realista: 6 cuentas son 0,53 grados.
ERROR_SENSOR = {1: (6.0, 0.7), 2: (2.5, -2.0)}

# Además, una ondulación de par del motor, enganchada al ángulo igual que el
# error del sensor, con la amplitud referida a 5 vueltas por segundo. Cae como
# omega^-2, que es lo que hace la inercia, y es lo único que distingue una cosa
# de la otra. Un notebook que la calibre como si fuera el sensor está mal.
RIPPLE_MOTOR = (3, 4.0, -1.0)   # (orden, cuentas a 5 rev/s, fase)

# El motor y su actuador. Un transistor a masa con diodo de rueda libre, a 1250 Hz,
# resuelto período a período con la solución exacta del circuito RL: mientras el
# transistor conduce la armadura ve Vs, cuando se abre la corriente se descarga
# por el diodo contra Vd, y en ninguno de los dos tramos puede invertirse. Con
# L/R = 0,2 ms contra un período de 0,8 ms la corriente se extingue antes del final
# del período casi siempre --conducción discontinua--, y eso es lo que dobla la
# curva estática, acorta la constante de tiempo con la velocidad y deja un salto
# al 100 %, donde el transistor no se abre nunca.
#
# El rozamiento es Coulomb con un arranque más alto que el deslizamiento, más un
# viscoso. Los números se eligieron para parecerse a lo medido en el banco: zona
# muerta entre 7 y 10 %, ganancia de ~17 (rad/s)/% abajo y ~3 arriba, bajadas
# unas 1,8 veces más lentas que las subidas, y una corriente de decenas de mA que
# con el eje trabado no llega a un cuarto de ampere.
MOTOR = dict(
    Vs=5.0,         # V, la fuente
    Vd=0.7,         # V, el diodo de rueda libre
    R=24.0,         # ohm
    L=4.8e-3,       # H
    Ke=0.006,       # V/(rad/s), y N·m/A
    J=7.5e-7,       # kg·m², con el disco
    Tc=5.5e-5,      # N·m, Coulomb girando
    Ts=7.7e-5,      # N·m, lo que hace falta para despegar
    B=2.33e-7,      # N·m/(rad/s)
)
PWM_T = 1 / 1250    # s, como PWM_TOP en Banco.ino

# La placa promedia todas las conversiones de la ventana de `cur_filas` filas, con
# el ADC libre, y eso da la media de la corriente sin sesgo de fase. Acá se modela
# igual: la media de cada período de PWM, promediada sobre la ventana, más un ruido
# de 120 mA RMS por conversión (medido en el clon) dividido por la raíz de las
# conversiones que entran. En el clon, a /32 y con el relleno de Sense/RowAdc.h,
# entran 3 por tick de 200 us: 30 por fila de 2 ms. Con el divisor la mitad son de A1;
# el modelo no tiene divisor y las cuenta todas como de A0.
CONVERSIONES_POR_S = 3 * 5000
RUIDO_CONVERSION_MA = 120.0

# El retardo entre el eje y lo que informa el sensor: el filtro del AS5600 en 2x
# más el muestreo.
RETARDO_S = 0.5e-3

# La medición de corriente, con las escalas del sketch: 1,25 mV por cuenta
# equivalente (UV_PER_COUNT en Sense/SupplyRatio.h) y un ACS712 de 185 mV/A. El
# reposo no cae justo en media escala.
#
# El canal `i` no publica cuentas sino dieciseisavos de cuenta, igual que el sketch
# (`cur_frac`), así que su escala es la de una cuenta dividida por 16. `cur_zero`,
# los rieles y el margen siguen en cuentas enteras.
MV_POR_CUENTA = 1.25
MA_POR_CUENTA = 1000.0 * MV_POR_CUENTA / 185.0
CUR_FRAC      = 4
SUBCUENTAS    = 1 << CUR_FRAC
MA_POR_UNIDAD = MA_POR_CUENTA / SUBCUENTAS
# El reposo del sensor, en cuentas crudas de A0: 57 por encima de la media escala,
# como un sensor con ese offset. No es el reposo de la placa del banco, que con el
# divisor puesto mide 2000-2001 cuentas equivalentes, la mitad de la alimentación
# del sensor: el simulado no tiene divisor (`cur_div` = 0), y un offset es lo que el
# cero de la corriente tiene que absorber. bringup() no se queja con él en 12 de
# 12 semillas sanas.
REPOSO_I = 2048 + 57         # cuentas

_Canal = namedtuple('_Canal', 'name scale unit')

CANALES = {
    'y_raw': _Canal('y_raw', GRADOS_POR_CUENTA, 'deg'),
    'y_uw':  _Canal('y_uw',  GRADOS_POR_CUENTA, 'deg'),
    'y_rep': _Canal('y_rep', 1.0,               ''),
    'u':     _Canal('u',     1.0,               'pwm'),
    'i':     _Canal('i',     MA_POR_UNIDAD,     'mA'),
}

# Más que esto de reloj de pared entre dos llamadas no se integra: con el comando
# quieto, en veinte segundos el eje ya llegó a donde iba a llegar.
_PONERSE_AL_DIA_S = 20.0


class BancoSimulado:
    """Todo lo que los notebooks le piden a un banco."""

    def __init__(self, ruido=0.5, semilla=0, motor=None):
        self._rng = np.random.default_rng(semilla)
        self.ruido = ruido
        self.motor = dict(MOTOR, **(motor or {}))

        # Las perillas y las lecturas de la placa, con los mismos nombres. Las
        # lecturas son las de un banco sano, y están para que la tabla que muestra
        # `dev` sea la misma con el cable enchufado y sin él.
        self.ang_cal = 0
        self.mot_bidir = 0
        self.ang_inv = 0                # el cableado imaginario ya tiene los signos bien
        self.cur_inv = 0
        self._filas = 10
        self.cur_div = 0                # sin divisor: el banco simulado no tiene caída
        self.cur_a1 = 0
        self.cur_notch = 0              # apagado, como en la placa; el simulado no tiene red
        self.cur_notchr = 950
        self.cur_nyq = 1                # prendidos como en la placa; el simulado no los aplica
        self.cur_ma = 1
        self.cur_zero = 2048
        self.cur_frac = CUR_FRAC        # el canal `i` va en dieciseisavos de cuenta
        self.loop_div = 10
        self.dec = 1
        self.chans = 0xFFFF
        self.ang_present = 1
        self.ang_status = 0x20          # imán detectado, ni débil ni fuerte
        self.ang_agc = 128              # media escala: la distancia correcta
        self.ang_mag = 1800
        self.ang_busovr = self.ang_buserr = 0
        self.loop_late = 0              # como en la placa, hasta la primera captura
        self.loop_missed = 0

        self.lut = [0] * tabla_angulo.LUT_SIZE
        self.ang_lutw = 0xFFFFFFFF
        self._lutw_aplicado = 0xFFFFFFFF

        # El estado del motor, que sobrevive a las capturas.
        self._uff = 0
        self._w = 0.0                   # rad/s
        self._theta = 1234.0            # cuentas, desde el arranque
        self._i = 0.0                   # A
        self._reloj = time.monotonic()

        self.info = 'CtrlLink 1 Banco (SIMULADO) chans=5 dt_us=2000'
        self.simulado = True

    @property
    def dt(self):
        return self.loop_div / 5000.0

    # ------------------------------------------------------ los parámetros

    @property
    def ctl_uff(self):
        return self._uff

    @ctl_uff.setter
    def ctl_uff(self, valor):
        # Lo que pasó desde la última vez, con el comando que había.
        self._ponerse_al_dia()
        self._uff = self._recortar(valor)

    @property
    def cur_filas(self):
        return self._filas

    @cur_filas.setter
    def cur_filas(self, valor):
        # Como WindowMean::apply(): de 1 a MAX_ROWS = 32 filas.
        self._filas = min(32, max(1, int(valor)))

    def _recortar(self, valor):
        """Lo que hace HBridge::write(): -255..255, o 0..255 en un solo cuadrante."""
        return int(round(min(255, max(-255 if self.mot_bidir else 0, float(valor)))))

    def set(self, name, value, tries=3):
        if name == 'ang_lutw':
            value = int(value) & 0xFFFFFFFF
            self.ang_lutw = value

            if value != self._lutw_aplicado:
                self._lutw_aplicado = value
                tabla_angulo.escribir(self.lut, value)
            return value

        setattr(self, name, value)
        return getattr(self, name)

    def get(self, name):
        if name == 'ang_lutsum':
            return tabla_angulo.checksum(self.lut)
        return getattr(self, name)

    @property
    def params(self):
        return {n: self.get(n) for n in self._nombres()}

    def channel(self, name):
        try:
            return CANALES[name]
        except KeyError:
            raise KeyError(f'no hay ningún canal llamado {name!r}') from None

    @property
    def channels(self):
        return list(CANALES.values())

    def close(self):
        """No hay nada que cerrar; está para que una celda con `dev.close()` corra."""
        self.rest()

    def rest(self):
        self.ctl_uff = 0

    # El cero de la corriente es el de `Bench`, el mismo código: sólo cambia de
    # dónde salen el signo y la escala, que acá son fijos.
    zero_current = bench.Bench.zero_current
    _reposo_de_corriente = bench.Bench._reposo_de_corriente
    _cuentas_de_corriente = bench.Bench._cuentas_de_corriente

    def _signo_corriente(self):
        return -1 if self.cur_inv else 1

    def _ma_por_cuenta(self):
        return MA_POR_CUENTA

    def configurar(self, bidir=None, cero=True, say=print, **_):
        """Lo mismo que `Bench.configurar()`. El motor simulado es de un cuadrante
        diga lo que diga `bidir`: declararlo al revés se ve igual que en un banco B′."""
        if bidir is not None:
            self.mot_bidir = int(bool(bidir))
        if cero:
            self.zero_current()

    # ------------------------------------------------------ autodescripción

    def _nombres(self, filtro=''):
        tiene = {n for n in catalogo.nombres_conocidos() if hasattr(self, n)}
        tiene.add('ang_lutsum')
        return sorted(n for n in tiene if filtro in n)

    def _para_describir(self, filtro=''):
        canales = ([(c.name, c.scale, c.unit) for c in CANALES.values()]
                   if not filtro else ())
        resumen = (f'filas a {1 / self.dt:.0f} Hz, {len(CANALES)} canales de '
                   f'telemetría  -- Datos simulados: no provienen de una medición.')
        return self.info, resumen, self._nombres(filtro), self._valor_legible, canales

    # Lo demás es lo de `Bench`, que arma las dos vistas con _para_describir().
    describe = bench.Bench.describe
    _valor_legible = bench.Bench._valor_legible
    __repr__ = bench.Bench.__repr__
    _repr_html_ = bench.Bench._repr_html_

    # ------------------------------------------------------------ el motor

    def _periodo(self, D, w, i0):
        """Un período de PWM con la velocidad congelada.

        Devuelve (corriente al final, corriente media), en A.
        """
        p = self.motor
        R, T = p['R'], PWM_T
        tau = p['L'] / R
        emf = p['Ke'] * w
        ton = D * T

        def tramo(i, a, t):
            # i(t) = a + (i - a) e^{-t/tau}, que se detiene en cero si va a cruzarlo:
            # ni el transistor ni el diodo dejan pasar corriente al revés.
            if a < 0.0:
                if i <= 0.0:
                    return 0.0, 0.0
                tz = tau * math.log((i - a) / (-a))
                if tz < t:
                    return 0.0, a * tz + (i - a) * tau * (1.0 - math.exp(-tz / tau))
            e = math.exp(-t / tau)
            return a + (i - a) * e, a * t + (i - a) * tau * (1.0 - e)

        a_on = (p['Vs'] - emf) / R
        a_off = (-p['Vd'] - emf) / R

        i, area = i0, 0.0
        if ton > 0.0:
            i, area = tramo(i0, a_on, ton)
        if ton < T:
            i, ar = tramo(i, a_off, T - ton)
            area += ar

        return i, area / T

    def _integrar(self, comandos):
        """Avanza el motor un período de PWM por comando. Devuelve (w, theta, i media) por período."""
        p = self.motor
        J, T = p['J'], PWM_T
        w, theta, i = self._w, self._theta, self._i

        n = len(comandos)
        ws, thetas, muestras = np.empty(n), np.empty(n), np.empty(n)
        a_cuentas = CUENTAS / (2 * math.pi)

        for k in range(n):
            # El transistor sólo ve el módulo del comando: uno negativo empuja para
            # el mismo lado.
            D = min(255, abs(int(comandos[k]))) / 255.0
            i, i_med = self._periodo(D, w, i)
            par = p['Ke'] * i_med

            if w <= 0.0 and par <= p['Ts']:
                w_nueva = 0.0
            else:
                w_nueva = w + (par - p['Tc'] - p['B'] * w) / J * T
                if w_nueva < 0.0:
                    w_nueva = 0.0

            theta += 0.5 * (w + w_nueva) * T * a_cuentas
            w = w_nueva

            ws[k], thetas[k], muestras[k] = w, theta, i_med

        self._w, self._theta, self._i = w, theta, i
        return ws, thetas, muestras

    def _ponerse_al_dia(self):
        """Integra el reloj de pared que pasó desde la última vez, con el comando de ahora."""
        ahora = time.monotonic()
        transcurrido = min(ahora - self._reloj, _PONERSE_AL_DIA_S)
        self._reloj = ahora

        n = int(transcurrido / PWM_T)
        if n > 0:
            self._integrar(np.full(n, self._uff))

    def _error_sensor(self, theta, w):
        """El error de ángulo en cuentas: el del sensor, más el del motor."""
        e = np.zeros_like(theta)

        for k, (A, phi) in ERROR_SENSOR.items():
            e += A * np.sin(2*np.pi*k*theta/CUENTAS + phi)

        k, A, phi = RIPPLE_MOTOR

        # El piso de velocidad es del modelo, no de la física: omega^-2 diverge y
        # sin un piso el eje casi detenido tendría una ondulación de cientos de
        # cuentas, que no se parece a ningún banco.
        seguro = np.maximum(np.abs(w) / (2 * np.pi), 2.0)
        e += A * (5.0/seguro)**2 * np.sin(2*np.pi*k*theta/CUENTAS + phi)

        return e

    # ---------------------------------------------------------- la captura

    def capture(self, duration, events=(), poll=0.005, warn=True, canales=None):
        self._ponerse_al_dia()

        # Como en la placa, `tick` avanza una vez por período de control y `dec`
        # emite una fila cada tantos: las filas van separadas `dec` ticks.
        dec = max(1, int(self.dec))
        filas = int(round(float(duration) / (self.dt * dec)))
        tick = np.arange(filas, dtype=np.int64) * dec
        t = tick * self.dt
        n = max(1, int(math.ceil(filas * self.dt / PWM_T)) + 1)

        # El comando período a período, y el que queda puesto al terminar.
        comandos = np.full(n, self._uff, dtype=np.int64)
        t_periodo = np.arange(n) * PWM_T
        for retardo, nombre, valor in sorted(events, key=lambda e: float(e[0])):
            if nombre == 'ctl_uff':
                v = self._recortar(valor)
                comandos[t_periodo >= float(retardo) - 1e-12] = v
                self._uff = v
            else:
                self.set(nombre, valor)

        theta0, w0 = self._theta, self._w
        ws, thetas, muestras = self._integrar(comandos)
        self._reloj = time.monotonic()
        self.loop_late = 600            # us, el peor retardo de un lazo sano

        # Cada fila lee lo que el sensor ve en su instante, que es el eje de hace
        # RETARDO_S. Para la primera, eso es antes de que empiece la captura: el eje
        # venía girando, así que se extrapola con la velocidad que traía en lugar de
        # repetir el primer ángulo, que pondría una velocidad falsa en la primera fila.
        t_fin = t_periodo + PWM_T
        antes = theta0 - w0 * RETARDO_S * CUENTAS / (2 * math.pi)
        tt = np.concatenate([[-RETARDO_S, 0.0], t_fin])
        theta = np.interp(t - RETARDO_S, tt, np.concatenate([[antes, theta0], thetas]))
        w = np.interp(t, t_fin, ws)
        idx = np.minimum((t / PWM_T).astype(np.int64), n - 1)

        medido = theta + self._error_sensor(theta, w)
        medido = medido + self._rng.normal(0, self.ruido, filas)
        cuentas = np.rint(medido).astype(np.int64)

        crudo = np.mod(cuentas, CUENTAS)
        corregido = cuentas - (tabla_angulo.correccion(self.lut, crudo) if self.ang_cal else 0)

        # La corriente, como la publica la placa: la media de los períodos de la
        # ventana de `cur_filas` filas que termina en cada fila, con el ruido que
        # queda de promediar sus conversiones.
        ventana = max(1, int(round(self.cur_filas * self.dt / PWM_T)))
        acumulada = np.concatenate([[0.0], np.cumsum(muestras)])
        hasta = np.minimum(idx + 1, n)
        desde = np.maximum(hasta - ventana, 0)
        media = (acumulada[hasta] - acumulada[desde]) / np.maximum(hasta - desde, 1)
        conversiones = CONVERSIONES_POR_S * self.dt * self.cur_filas
        adc = (REPOSO_I + media * 185.0 / MV_POR_CUENTA
               + self._rng.normal(0, RUIDO_CONVERSION_MA / np.sqrt(conversiones) / MA_POR_CUENTA,
                                  filas))
        # La placa redondea a la unidad que publica y no a la cuenta: ése es el
        # motivo de publicar dieciseisavos (ver Sense/SupplyRatio.h).
        adc = np.clip(np.rint(adc * SUBCUENTAS) / SUBCUENTAS, 0, 4095)

        # Los signos van al final, como en la placa: la tabla habla del imán.
        s_ang = -1 if self.ang_inv else 1
        s_cur = -1 if self.cur_inv else 1

        df = pd.DataFrame({
            't': t,
            'y_raw': crudo * GRADOS_POR_CUENTA,
            'y_uw': s_ang * corregido * GRADOS_POR_CUENTA,
            'y_rep': np.zeros(filas, dtype=np.uint8),
            'u': comandos[idx].astype(float),
            'i': s_cur * (adc - self.cur_zero) * MA_POR_CUENTA,
        })

        if canales is not None:
            canales = [canales] if isinstance(canales, str) else list(canales)
            desconocidos = [c for c in canales if c not in CANALES]
            if desconocidos:
                raise CtrlLinkError(f'no hay canales llamados {desconocidos}; '
                                    f'los que hay son {list(CANALES)}')
            # En el orden de la tabla, como los entrega la placa.
            df = df[['t'] + [c for c in CANALES if c in canales]]

        df.attrs.update(tick=tick, dec=dec, dt_us=self.dt*1e6, marks=[], notes=[],
                        gaps=0, missed=0, maxlate=self.loop_late, sovr=0, serr=0,
                        spres=1, mstat=0x20, agc=128, mag=1800,
                        wall=float(duration), rows=filas, drops=0,
                        config=dict({'dispositivo': self.info},
                                    **{n: self.get(n) for n in catalogo.de_configuracion()
                                       if hasattr(self, n)}),
                        units={'y_raw': 'deg', 'y_uw': 'deg', 'y_rep': '', 'u': 'pwm',
                               'i': 'mA'})

        return df

    def step(self, name, value, pre=0.1, post=0.9, back=None, warn=True, canales=None):
        df = self.capture(pre + post, events=[(pre, name, value)], canales=canales)
        df['t'] -= pre
        if back is not None:
            self.set(name, back)
        return df

    # ---------------------------------------------------- puesta en marcha

    def bringup(self, motor=True, u=120):
        print(f'puesta en marcha: {self.info}')
        f = 1 / self.dt
        for etiqueta, detalle in [
                ('muestreo', f'{f:.0f} Hz reales contra {f:.0f} nominales, 0 perdidos'),
                ('sensor', 'contesta en el bus'),
                ('imán', 'detectado, AGC 128/255, campo 1800'),
                ('bus i2c', '0 errores de transferencia, 0 desbordes'),
                ('motor', f'gira con u={u}'),
                ('actuador', f'bidir = {bool(self.mot_bidir)}; el simulado no lo verifica')]:
            print(f'  [   ok]  {etiqueta:<18}  {detalle}')
        print('\n  Datos simulados: no provienen de una medición.')
        return True


def conseguir_banco(forzar_simulado=False, bidir=None, **kw):
    """El banco real si está, y si no uno simulado, indicando cuál es.

    Un notebook que se muestra en clase no puede depender de que el cable esté
    enchufado, pero tampoco puede hacer pasar un modelo por una medición. Así
    que recurre al simulado automáticamente, con un aviso destacado. `bidir` es
    el de `sync_board()`.
    """
    if not forzar_simulado:
        try:
            from bench import sync_board
            return sync_board(bidir=bidir)
        except Exception as exc:
            print(f'no hay banco: {type(exc).__name__}: {exc}')

    print('=' * 68)
    print('Banco simulado: las capturas salen de un modelo, no de un motor.')
    print('Datos simulados: no provienen de una medición. El motor y el error de')
    print('sensor están definidos en banco_simulado.py.')
    print('=' * 68)
    banco = BancoSimulado(**kw)
    banco.configurar(bidir=bidir)
    return banco
