nicber/arduino-jupyter/(commit log)

2026-08-29 Add AS5600Async library and 5 kHz sample loop sketch
    AS5600<Bus> samples RAW_ANGLE over an interrupt-driven I2C bus, driven from
    a Timer2 ISR at exactly 5.000 kHz. Bus access is a static-dispatch policy
    (no virtuals, no vtable); NI2CBus binds it to nI2C, added here as a submodule
    because it is the only packaged Arduino I2C library that is genuinely
    ISR-driven and fires its completion callback from the TWI ISR.
    The AS5600 suppresses address-pointer auto-increment on RAW_ANGLE reads
    (datasheet [v1-06] page 13), so with the pointer parked each sample is a bare
    two-byte read, ~90 us at 400 kHz against a 200 us budget. The pointer is armed
    lazily: startup, a STATUS read, and a bus error all leav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
2026-08-30 Add CtrlLink, a serial protocol for driving the loop from Jupyter
    Sets gains and reference values from a notebook and streams the resulting
    timeseries back as a DataFrame, so a step response is a few lines of Python.
    Telemetry is fixed-width hex, one row per control period. The width is what
    matters, not the hex: the row length is constant, so the bandwidth budget is
    exact rather than worst-case and a capture decodes in one np.frombuffer
    instead of tokenising line by line. Lines starting with '#' are text, so
    replies and diagnostics interleave with the stream harmlessly and the whole
    thing stays readable in the Serial Monitor. Parameters and channels are
    declared as PROGMEM tables and disco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
    [ControlDemo.ino, ctrllink.py, test_ctrllink.py]
2026-09-08 Integer control loop, per-mode controllers, and loop health reporting
    The control step ran on floats and carried a half-finished current-loop
    experiment: an error computed from position and then overwritten by one
    computed from current, a sensor offset declared int32_t but registered as
    CTRL_I16, and a current scaling that overflowed int before it was assigned
    (int is 16 bits here, so 5*1000*1000 is already garbage).
    ControlMath is new: Fixed<Raw, Frac> puts the Q format in the type, so scale
    conversions fold at compile time and a gain of 5e-5 and a gain of 0.5 can each
    have the resolution they need. fpm and CNL would have been better than writing
    one, but both need <type_traits> and <limit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
    [ControlDemo.ino, ctrllink.py, test_ctrllink.py]
2026-09-08 Parameters cross the wire in fixed point; notebook keeps only experiments
    The device was storing gains and filter time constants as floats and
    converting them itself. Now it stores exactly what its arithmetic multiplies
    by -- a gain in Q22, an integral gain in Q30, a filter pole in Q16 -- and the
    parameter table publishes each format's fractional bits. The host multiplies
    on the way in and divides on the way out, so `dev.kp = 0.5` still reads as it
    did while the sketch no longer executes a single floating-point instruction.
    refresh_tuning() is integer-only, and `main` disassembles with no float
    helpers at all.
    Fractional bits rather than a channel's arbitrary float scale, because that is
    wh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
    [ControlDemo.ino, bench.py, ctrllink.py, test_ctrllink.py]
2026-09-08 Make the host side work on Windows
    find_port() matched on port names -- usbserial, usbmodem, ttyUSB, ttyACM --
    none of which a Windows machine has. Every port there is COM<n>, so the search
    returned nothing and no student on Windows could connect at all. It now selects
    on USB vendor id, which every platform reports and which says nothing about
    what the port is called, with the old name matching kept as a fallback for
    platforms that leave vid unset (with COM added to it).
    time.sleep() on Windows rounds up to the system timer tick, 15.6 ms by default,
    before Python 3.11. _BYTE_GAP is half a millisecond, so every command would
    have been thirty times slower than intended: a six-millisecond `set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
2026-09-08 Translate all prose to Spanish, using the course's terminology
    Comments, docstrings, documentation, notebook markdown and every
    user-visible string now read in Spanish, following the conventions in
    practicas_de_control/CONVENCIONES.md: e = r - y, u as the señal de
    control, referencia (not consigna), lazo abierto/cerrado, planta,
    régimen permanente, sobrepico, escalón. Impersonal register throughout,
    as that file asks for student-facing text.
    Identifiers stay in English. Parameter and channel names are the wire
    protocol shared by firmware and host, and kp/ki/kd/ref/u/e/y is standard
    control notation; the existing course material already pairs Spanish
    prose with an English API.
    The protoc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
2026-09-08 Add a README that gets someone from a clone to a measurement
    Presents the bench and walks through setting it up: clone with
    submodules, the Python environment, the tests, the sensor check, the
    notebook.
    Three things go up front because they are what makes a first attempt
    fail. The tests run against the simulated device, so a broken install is
    told apart from broken wiring before a board is involved. The loop runs
    with MOTOR_PWM_PIN commented out, which lowers the entry cost to an
    AS5600 board and a magnet, and the README says what degrades when it is.
    And the motor moves, which is said before any instruction to run a cell.
    Then what can be changed from the notebook, a symptom-to-cause tabl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
2026-09-08 Survive a disconnected sensor, and measure the loop honestly
    Found by running the notebook against the board with the AS5600 not
    wired: with nothing on the bus every sample failed, and the resulting
    error storm cost the control loop 451 of every 1000 periods. The
    diagnostics reported the loop was fine.
    AS5600 now gives up on a sensor that fails 32 transfers in a row and
    polls it every 2500 samples instead of every one. Any transfer it
    answers marks it present again, so reconnecting is picked up within half
    a second. Missed periods go from 451/s to 0, I2C errors from 4800/s to
    2/s, and the real loop rate from 575 Hz back to 994 Hz. The sketch
    publishes `spres`, which is state and not a count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
    [ControlDemo.ino, bench.py, ctrllink.py, test_ctrllink.py]
2026-09-08 Leave the link usable when a notebook cell is interrupted
    Stopping a cell mid-capture left the device streaming into a port nobody
    was reading. The rows outlive the cell, so the next command reads
    telemetry where it expects a reply: `get` comes back with a capture's
    data, `set` verifies against a row, and the link looks like it needs a
    kernel restart. A cell cut in the middle of `_send` is the same problem
    from the other side -- the bytes that made it are sitting in the
    device's line buffer, and they glue themselves to the front of the next
    command.
    Every operation now takes the link, and one that leaves through an
    exception -- KeyboardInterrupt included, which is what the stop button
    raise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
    [ctrllink.py, test_ctrllink.py]
2026-09-08 Force the reset that reconnecting only pretended to do
    sync_board() reopens the link at the top of every cell and says that
    this resets the board, so the loop starts from the sketch's defaults.
    It did not. What resets a UNO is the falling edge of DTR -- the line
    reaches RESET through a capacitor -- and opening the port only produces
    that edge if DTR was deasserted beforehand. On macOS with a CH340 bridge
    it is not: the line stays asserted between a close and the next open, so
    reopening generates no edge and the board never hears about it.
    Found by running the notebook twice in a row. Cell 8 leaves tickdiv at
    50, and the whole second pass then ran at 100 Hz, carrying the gains and
    the mode t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
    [ctrllink.py, test_ctrllink.py]
2026-09-09 Drive an L298N, and fix the two bugs that hid behind it
    The bench moved to an L298N: ENA on a PWM pin, IN1/IN2 for direction. A
    direction change now opens the bridge with ENA before touching IN1/IN2, so
    it never crosses a conducting state. The dead time between those writes is
    several times what the L298 needs, but that is not the argument -- each of
    its half bridges hangs off a single logic input, so no pin ordering can make
    one leg conduct both ways.
    Unidirectional/bidirectional and the PWM frequency stop being #defines and
    become parameters, answered from the notebook: they are properties of the
    bench, not of the program. The PWM moves to Timer1, the only timer left, and
    runs phase-corre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
    [ControlDemo.ino, bench.py, ctrllink.py, test_ctrllink.py]
2026-09-09 Halve the loop rate, and stop compiling for size
    The control loop ran at 1 kHz, where the six-channel telemetry row costs
    41 % of a 1 Mbaud link and roughly 20 % of the control periods were being
    dropped. The notebook already worked around it by setting tickdiv = 10 in
    the one cell that compares control laws. Make 500 Hz the default instead:
    the row falls to 21 % of the link, the worst attention delay drops from
    about 60 % of the period to 30 %, and no period is missed.
    The AVR core compiles with -Os. This sketch would rather have cycles than
    bytes, so pass -O2 through --build-property on the compile and the link.
    Measured on this sketch: -Os is 17018 bytes of flash, -O2 is 18986 (58 %
    of t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
    [ControlDemo.ino, bench.py]
2026-09-09 Plan the AS5600 calibration before writing any of it
    The sensor's angle error is a fixed function of shaft angle, so it looks to
    the loop like velocity ripple that no gain removes. The literature converges
    on a small set of low-order harmonics -- ODrive fits the 1st and 2nd, SimpleFOC
    stores a table with linear interpolation -- and this bench can measure them
    against nothing but time, by assuming constant velocity over a revolution.
    The plan is mostly about what that assumption cannot separate. A brushed motor's
    commutation ripple is angle-locked too, so one run at one speed cannot tell the
    sensor from the motor. Sweeping speed can: the sensor's amplitude is flat in w
    while a torque ripple'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
2026-09-09 Correct the angle the AS5600 reports, and let the class watch it happen
    The sensor's error is a fixed function of shaft angle, so the loop sees it as
    velocity ripple that no gain removes. Measuring it needs no reference encoder:
    if the shaft turns evenly, time is the ruler, and what is left after removing
    the shaft's smooth march is the error, with every revolution stacked on top of
    the last.
    The part that is easy to get wrong is what that residue contains. A brushed
    motor's commutation ripple is angle-locked too, so one run at one speed cannot
    tell the sensor from the motor, and reversing direction -- the obvious move --
    does not separate them either, because the inertia term is even in sp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
    [ControlDemo.ino, banco_simulado.py, bench.py, calib.py, ctrllink.py, fakeuno.py, test_calib.py, test_ctrllink.py]
2026-09-09 Say in the plan what the implementation actually did
    Two sections described a design that was replaced while building it. The table
    was going to live in EEPROM behind a magic header and a CRC; it lives on the
    computer instead, because a calibration belongs to a bench and not to a
    program, and because the ugly EEPROM case is not the missing table but the
    stale one applying itself in silence. And loading it was going to need three
    new `lut` commands; it needed none, because `lutw` carries the index inside the
    value and refresh_tuning() already ran after every parameter write.
    Also point at where each piece ended up, so the plan can be read next to the
    code instead of instead of it.
    Co-Author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
2026-09-09 Fix the three things the real bench found
    Ran the whole thing on the hardware. The table path is exact: five different
    tables uploaded over 64 `set` commands, five Fletcher sums matching the AVR,
    and the correction shifting the reported angle by exactly the interpolated
    value at the resting count -- to the count, including the +127/-128 extremes,
    at no measurable cost to the loop. Measuring it needed the step taken *inside*
    one capture; comparing two captures folds the shaft's drift into the answer,
    which is how an earlier attempt produced a phantom off-by-one.
    Three real defects, in order of how much they mattered.
    The bench's magnet sits far enough out that its AGC is railed, and the sen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
    [ControlDemo.ino, bench.py, calib.py, test_calib.py]
2026-09-09 Widen the table until it fits the sensor, and fix what hid the answer
    The magnet is mounted properly now -- AGC 165 of 255, mid scale -- and the error
    is still 24 degrees peak to peak, almost all of it in the second harmonic. That
    retires the argument the int8 table was built on. AGC reports distance, not
    centring, so a magnet can sit at exactly the right height and still be tilted,
    and there the error is real, is the sensor's -- flat in speed from 15 to 37
    rev/s, in both directions -- and a table corrects it. The old range represented
    a tenth of it. Entries are now int16, still in eighths of a count, reaching 45
    degrees; `lutw` grew to u32 to carry them, the interpolation uses an int32
    inte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
    [ControlDemo.ino, banco_simulado.py, bench.py, calib.py, test_calib.py]
2026-09-09 Make every cell start from a calibrated sensor
    The board comes up uncalibrated on purpose, and sync_board() resets it at the top
    of every cell, so until now every cell after the calibration section measured
    against the sensor's raw angle -- twenty-five degrees peak to peak on this bench.
    The calibration was something you had to remember, which is the same as something
    you forget.
    sync_board_cal() is sync_board() plus the bench's table, and the notebook calls
    it everywhere. It resolves the file relative to the repository rather than the
    working directory, says in one line what it applied, and when there is no file
    says that instead of failing -- the loop runs fine on a crooked angle, it just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
    [bench.py]
2026-09-10 Explain the hardware in a notebook, one configuration at a time
    There was nowhere to point somebody who asks how the bench is wired. The README
    has the pin table and the reasons scattered through eight sections, and
    control_demo.ipynb starts from a working bench and never says what a working
    bench is. notebooks/hardware.ipynb is the walkthrough, and it is built to be
    shown on a screen: wiring diagrams, and the four configurations the bench grows
    through, each one useful on its own.
    A is the sensor alone -- no bridge, no current sensor -- and it is not a toy: the
    angle, the unwrapping, the filters, the noise floor and the loop's timing are all
    visible there, and bringup(motor=False) checks e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
    [banco_simulado.py]
2026-09-10 Give the one-quadrant drive a section of its own
    It was one bullet under `bidir`, which is the wrong weight for what is probably
    the most common bench. Anybody wired that way needed to read the whole H-bridge
    section and then infer what did not apply to them.
    Section 2 now has 2.1 for the full bridge and 2.2 for a single quadrant, with its
    own two wirings: an L298N with IN1/IN2 tied off, and a MOSFET with a flyback
    diode, which the diagram says is not optional. What `bidir = 0` does is one
    thing, and the section derives the rest from it: the command clips to 0..255, so
    in open loop a negative uff does nothing, and in closed loop the controller can
    push but not come back. Overshoot is perman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
    [banco_simulado.py]
2026-09-10 Hacer que la placa arranque en un estado en el que se pueda hablar con ella
    Un banco nuevo trajo tres cosas que fallan de manera muda, y las tres se ven
    igual desde el notebook: una placa que "no anda".
    El reloj. Hay clones armados sobre un LGT8F328P, que no lleva cristal: usa un RC
    interno de 32 MHz y arranca dividido por 8, o sea a 4 MHz. Todo el proyecto esta
    calculado para 16 MHz, asi que a 4 MHz no anda nada empezando por el puerto
    serie, que emite cuatro veces lento y entonces la placa no puede ni avisar lo que
    le pasa. boardClockBegin() mira CLKPR y corrige solo a la placa que arranco
    dividida, asi que la que hoy anda sigue andando igual. Medido: 16,04 MHz.
    El bus. Grabar la placa l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
    [ControlDemo.ino, bench.py]
2026-09-10 Poder decidir si el motor no gira o si el sensor no lo ve girar
    Cuando el eje no se mueve hay dos culpables muy distintos --la placa no esta
    sacando el comando, o el puente no lo esta siguiendo-- y bringup() no puede
    separarlos, porque su unica evidencia es el angulo. Con el iman mal montado el
    angulo es ruido, y entonces un banco entero parece un motor muerto: es lo que
    paso en este, donde el motor daba 0,00 vueltas con cualquier comando y lo que
    fallaba era la fuente de potencia del puente.
    Puente_Bringup no depende del banco: configura el Timer1 igual que ControlDemo y
    lee sus propios pines de vuelta por el registro PIN. Si ENA conmuta y IN1/IN2
    obedecen, el comando esta saliendo y lo qu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
2026-09-12 Contar en 12 bits, y decir por qué el sensor no contesta
    Una tarde entera de banco para encontrar que la masa del módulo estaba al
    aire. Desde el protocolo eso se ve exactamente igual que un módulo quemado,
    un cable cortado o un corto: el sensor no contesta, y no hay forma de saber
    en cuál de los cuatro lugares hay que meter mano. Lo que sigue es lo que
    hubiera contestado esa pregunta en el primer minuto.
    La placa se mide a sí misma al arrancar, antes de tomar el bus:
    - El fondo de escala del ADC, que en este banco no es uno solo. El UNO tiene
    10 bits y el clon con LGT8F328P tiene 12, y la misma tensión mide cuatro
    veces más en uno que en otro. La sonda no depende de ning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
2026-09-12 No llamar calibración a un número que no lo es
    El renglón de la referencia ofrecía una cuenta con cara de calibración sobre
    una medición que en el clon no significa lo que dice. Los bits REFS del ADMUX
    son los del ATmega, y el LGT8F328P tiene su propio juego de referencias
    internas, así que lo que se estaba midiendo era una contra otra.
    El banco lo confirma con cuatro decimales: 1025 cuentas de 4096 es 0,2502, y
    1,024/4,096 es 0,25. Son dos de las referencias que el core lgt8fx declara por
    nombre. Y el número además depende de con qué referencia venía trabajando el
    ADC: el mismo código, en un sketch que arranca de otra manera, da 2585 en vez
    de 1025.
    Así que en el ATmega la me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
2026-09-12 Soltar el TWI antes de manotear sus pines, y darle a cada placa su referencia
    Dos cosas que el banco encontró con los cables cruzados sobre la mesa.
    La primera es un detector que no detectaba. Con SDA y SCL intercambiados, el
    renglón informaba "SDA ok, SCL ok" y el sensor no contestaba, que es
    exactamente la tarde que este código venía a evitar. La causa estaba escrita
    tres funciones más arriba, en el comentario de i2cBusRecover(): mientras TWEN
    esté puesto, SDA y SCL los gobierna el TWI y no el puerto. Y acá TWEN ya está
    puesto antes de que empiece setup(), porque nI2C construye su objeto global
    durante la inicialización estática y su constructor enciende el periférico. Los
    puls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
2026-09-12 Dejar puestos los signos del banco, y no sólo aconsejarlos
    `bringup()` medía la polaridad y después dejaba la placa como estaba, así que el
    consejo se perdía en el reset de la celda siguiente. Ahora la corrige, la vuelve
    a medir accionando el motor --que es lo único que la prueba--, y devuelve un
    `Cableado` con los tres números que describen al banco y no al programa: `bidir`,
    `uinvert` e `iinvert`. Los anota además en un archivo, y `sync_board()` los
    repone después de cada reset, igual que ya hacía con la calibración del sensor.
    `iinvert` es nuevo y hace falta que sean dos signos: `uinvert` da vuelta el
    puente, o sea el ángulo y la corriente a la vez. Si con el ángulo ya derec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
    [ControlDemo.ino, banco_simulado.py, bench.py]
2026-09-12 Elegir la referencia del ADC donde el clon la elige de verdad
    Los bits REFS del ADMUX no eligen la referencia en el LGT8F328P. La eligen DACON,
    VCAL y el bit REFS2 de ADCSRD; el core lgt8fx escribe REFS igual, pero después de
    haber configurado esos tres, así que REFS es resabio y no elección. Este sketch
    escribía sólo REFS, o sea que en esa placa no elegía nada: la referencia quedaba
    en lo que hubiera quedado de antes.
    Eso es lo que estaba detrás de la rareza anotada en BoardStart.h --el mismo código
    leyendo el canal interno da números distintos en corridas distintas-- y de algo
    peor: el cero de la corriente no se podía calibrar. Entre la captura que lo medía
    y la que lo verifica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
2026-09-12 Buscar el signo de la corriente donde la corriente existe
    Un motor sin carga en régimen no consume: la fuerza contraelectromotriz le cancela
    el comando, así que la corriente vive en el arranque y en ningún otro lado. Medido
    en este banco, con el eje parado y un escalón a u = 255: 925 mA de pico contra
    125 mA ya girando; a u = 120, 317 mA contra cero. Un barrido de u de 0 a 255 en
    régimen mueve la lectura 4 cuentas sobre 4096 mientras el eje pasa de 0 a 114
    vueltas por segundo.
    Así que `spin()` deja de informar el promedio del tirón y pasa a informar la
    muestra de mayor módulo, con su signo. El promedio diluía el arranque hasta el
    ruido y entonces el signo que se informaba era el de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
2026-09-12 Poner una red bajo la interfaz antes de moverla de lugar
    La tabla de parámetros y la de canales son la interfaz pública del sketch: los
    notebooks las usan como atributos y como columnas. Un nombre que cambia, una
    entrada que se reordena o un frac que queda con el del vecino rompen el otro lado
    en silencio, y no había ningún test que mirara eso.
    Lee las dos tablas del sketch en lugar de preguntarle a una placa, así corre sin
    hardware y sin compilar, que es lo que hace que sirva de red durante un reacomodo
    grande. Cuando una entrada cambia a propósito, --guardar deja el diff del golden
    en el commit.
    Claude-Session: http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
2026-09-12 Darle un dueño a cada cosa que el sketch tenía suelta
    Seis módulos, cada uno con una sola responsabilidad y con el estado que le
    corresponde adentro. Ninguno tiene una variable static escondida en una función:
    los trece contadores y latches que vivían así --el sentido cableado del puente, el
    contador de muestras de la ISR, las dos lecturas anteriores de los contadores del
    sensor, el turno de la ronda de registros, el modo con el que corrió el período
    anterior-- pasaron a ser miembros con nombre, que se pueden leer y razonar desde
    afuera.
    Actuator/HBridge el puente: magnitud modulada, sentido en dos pines
    Sampler/SampleClock el reloj del lazo: período rígido y diviso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
2026-09-12 Armar el sketch con los módulos en lugar de con globales
    El sketch ya no hace casi nada por sí mismo: arma los nueve módulos, los cablea y
    publica sus parámetros. Lo que queda es lo que de verdad es de este sketch y de
    ningún módulo: qué pines, qué sensor, qué escalas, y el orden en el que arranca.
    71 piezas de estado suelto -> 17 objetos con nombre, nueve de ellos módulos
    13 static adentro de funciones -> cero
    1452 líneas -> 768
    refresh_tuning() de 109 líneas con siete temas -> 34, una línea por dueño
    refresh_tuning() dejó de ser la función que le escribe a todos. Cada módulo se
    hace cargo de su propia detección de cambios, así que un barrido de ganancia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
2026-09-12 Sacarle a ctrllink lo que sabía del AS5600 y del motor
    El enlace se queda con lo que define el protocolo: filas, descartes, huecos, y los
    dos contadores del lazo, que no son de ningún hardware porque cualquier
    dispositivo que hable este protocolo tiene un período de control que puede no
    llegar a cumplir. Todo lo demás --el sensor que no contesta, sus pines, los
    pull-ups, el imán, el motor-- se fue a bench.DiagnosticoDeBanco, que es quien sabe
    qué equipo hay del otro lado.
    El mecanismo es un colaborador y no una subclase: CtrlLink recibe `diagnostico` y
    le pregunta. Cuatro métodos, todos opcionales. Las notas se parten en dos, antes y
    después de las genéricas, porque el orden import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
2026-09-12 Que los sketches de puesta en marcha dejen de copiar
    Tres duplicaciones, y ninguna era una copia fiel: ya habían empezado a separarse,
    que es lo que las hace peligrosas.
    El puente. Puente_Bringup tenía su propio Timer1 y su propio setDuty(), y
    divergían del sketch de control en dos cosas: dividía por 255 donde el otro corre
    ocho bits, y prendía COM1A1 al configurar donde el otro lo deja apagado hasta que
    haya algo que accionar. Ahora usa HBridge. Como su trabajo es mover ENA y el par
    IN1/IN2 por separado para leer cada pin de vuelta, el módulo expone duty(): la
    magnitud sola, documentada como el camino del diagnóstico, contra write(), que
    decide las dos cosas juntas y es el único qu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
2026-09-12 Hacer que el banco simulado no pueda callar
    BancoSimulado reimplementa a mano la superficie que los notebooks usan, sin heredar
    de Bench ni compartir contrato. Es a propósito: lo que se muestra en clase tiene que
    correr sin la placa, y hacer que ese archivo importe el del enlace serie lo ataría a
    pyserial para nada. El precio era que el día que Bench ganara un método, el simulado
    no fallaba: callaba.
    El test cobra ese precio, y saca la superficie de los propios notebooks en lugar de
    una lista escrita a mano que envejecería igual que el simulado: todo lo que aparezca
    como `dev.algo` o `banco.algo` en una celda tiene que existir. Se parsea con ast y no
    con una expresión regular, porque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
2026-09-12 Partir BoardStart en sus tres trabajos
    Eran casi quinientas líneas con tres cosas que fallan distinto y se arreglan en
    lugares distintos: el reloj, el ADC, y el bus I2C con su diagnóstico eléctrico y su
    maestro por software. Ahora cada uno tiene su header, bajo namespace board, y
    BoardStart.h los incluye a los tres para quien quiera el arranque entero sin elegir.
    BoardClock.h 78 líneas dejar el reloj donde el compilador cree que está
    BoardAdc.h 149 líneas qué placa es, cuánto vale su referencia, y elegirla
    I2CBus.h 300 líneas destrabar el bus y decir qué le pasa a sus dos cables
    Se partió por rangos de línea y no retipeando, para no perder ni un comentario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
    [ControlDemo.ino]
2026-09-12 Poner la documentación al día con los nombres y los módulos
    Los 36 renombres dejaron la documentación describiendo parámetros que ya no existen,
    que es la clase de desfasaje que hace que alguien copie una línea de un README y no
    le funcione. README.md, PROTOCOL.md y Docs/CALIBRACION_AS5600.md quedan al día, y con
    ellos las referencias a funciones que se mudaron: los dos fragmentos de firmware del
    documento de calibración muestran ahora el código que de verdad hay, y el README
    explica dónde está la ley de control ahora que vive en una librería.
    Los canales no se tocaron en ningún lado: son columnas de un DataFrame.
    Y queda anotado que LTO no se activa, con el número que lo jus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
2026-09-12 Cerrar los dos static que quedaban escondidos en una función
    La tasa de muestreo de AS5600_Loop5k se saca por diferencia contra la impresión
    anterior, y los dos valores anteriores vivían en static adentro de printAngle(). Es
    lo mismo que se corrigió en todo el resto: estado escondido en un lugar donde nadie
    lo busca. Ahora tienen nombre y están a nivel de archivo.
    Con esto no queda ni un static de función en los cuatro sketches ni en las librerías
    propias. Lo que sigue apareciendo con esa palabra son funciones miembro estáticas y
    un miembro de datos de clase, que es otra cosa.
    Claude-Session: https://claude.ai/code/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
2026-09-12 Que la placa se cuente sola, y arreglar dos nombres que enganaban
    Segunda pasada de nombres, sobre los que quedaron crípticos o mintiendo:
    lop_* -> loop_* «lop» se lee como un error de tipeo
    brd_* -> board_* idem
    ang_filt -> ang_sfilt para no confundirlo con ang_alpha: uno es el SF
    interno del sensor y el otro un polo nuestro
    ang_ovr -> ang_busovr son desbordes del bus, no del ángulo
    ang_err -> ang_buserr «ang_err» se lee como error de ángulo, que es otra cosa
    cur_malsb -> cur_ma_lsb miliamperes por LSB, no una palabra sola
    Y lo principal: la interfaz se descubre sola. Poner `dev` en una celda muestra la
    tabla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
    [ControlDemo.ino, banco_simulado.py, bench.py, calib.py, catalogo.py, ctrllink.py, fakeuno.py, test_calib.py]
2026-09-12 Probarlo en la placa, y corregir el umbral que no daba
    Probado en el clon con LGT8F328P, que es justo la placa que ejercita el arreglo de
    la referencia del ADC. El sketch refactorizado anda: 503 Hz reales contra 500
    nominales sin un período perdido, el sensor contesta, el imán está bien montado, el
    bus limpio, el motor da 17 vueltas con u = 120 y 86 mA de pico, y el notebook de
    hardware corre de punta a punta sin un solo error contra la placa de verdad.
    Va un test nuevo, el único que necesita hardware. Los otros prueban la aritmética en
    la máquina de escritorio, el protocolo contra un dispositivo inventado y que los
    nombres existan; ninguno puede probar que el firmware grabado se comp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
    [bench.py, test_hardware.py]
2026-09-13 Que la computadora elija qué canales emitir en cada captura
    Formatear una fila y sacarla por la UART le cuesta a la placa más que el paso PID,
    así que el techo de frecuencia del lazo lo pone la telemetría. Ahora CtrlLink tiene
    un segundo parámetro incorporado, `chans`: una máscara con un bit por canal. Se toma
    en `start` y no durante el flujo, porque cambiar el ancho de la fila a mitad de
    camino dejaría a la computadora leyendo con el encabezado anterior. El encabezado
    lista sólo los activos, así que ctrllink los decodifica sin cambios. `start` rechaza
    una selección cuya fila no entre en el buffer, y `begin()` ya sólo rechaza una tabla
    de más de 16 canales.
    Del lado de Python, `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
2026-09-13 Dejar la placa en lazo abierto: el comando entra, el ángulo y la corriente salen
    El sketch se llama Banco y hace una sola cosa: pone `ctl_uff` sobre el
    actuador, muestrea el AS5600 a 5 kHz, lee la corriente por el ADC y emite una
    fila por período con y_raw, y_uw, u e i. Se van el PID, la rampa, el lazo de
    corriente, los filtros de a bordo y con ellos Control y ControlMath enteras, la
    frecuencia de PWM como parámetro, los tres números del cableado y el
    diagnóstico eléctrico del bus.
    Nada de lo que se mide lleva un polo de la placa adentro: el ángulo sale
    desenrollado sin filtro, sin cero y sin dar vuelta el signo, que es de qué lado
    están dos cables y se elige al procesar. El filtro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
2026-09-13 Calcular la velocidad de este lado, y que el motor de mentira sea el del banco
    La placa entrega el ángulo y nada más, así que la velocidad se calcula acá:
    `ensayo.velocidad()` deriva y promedia con una ventana centrada, que no atrasa,
    y se puede poner en cero para ver la cuantización desnuda. `normalizar()` pasa
    una captura a segundos, por ciento de PWM, radianes, radianes por segundo y
    amperes; `signo()` deduce para dónde va el ángulo mirando sólo los comandos
    positivos; `guardar()` / `cargar()` la llevan a un CSV, y `esperar_quieto()`
    no deja arrancar un ensayo con el eje todavía girando.
    bench.py queda en compilar, conectar y verificar: se van las ganancias, los
    filtros, las ref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
2026-09-13 Que el motor de mentira consuma lo que consume el de verdad
    Con 6 ohm el arranque llegaba a casi un ampere y la muestra de corriente se
    despegaba diez desvíos del ruido, así que en el simulado el canal resolvía un
    motor que en el banco no resuelve. Resistencia e inductancia cuatro veces más
    grandes, y la inercia y los rozamientos cuatro veces más chicos, dejan la
    mecánica idéntica y la corriente en las decenas de mA que tiene la del banco.
    Claude-Session: https://claude.ai/code/session_019N71utXCSHHwPZ6KLMktuW
2026-09-13 Contar el banco como lo que es ahora
    El notebook de hardware pierde las secciones de lazo cerrado y el de
    demostración se va entero. Lo que queda es el recorrido del montaje, con el
    actuador de un solo cuadrante como el caso de este banco --empuja y no frena,
    un comando negativo empuja para el mismo lado, y el eje sigue girando segundos
    después de soltarlo--, la API, y un punto de partida para identificar la planta
    en radianes por segundo, con `ensayo` y esperando al eje antes de cada escalón.
    La nota de la corriente dice por qué el canal no resuelve este motor.
    El README y PROTOCOL.md dejan de prometer un PID, y la documentación de la
    calibración deja de nombrar parámetros que ya no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
2026-09-13 Que el motor de mentira arranque y se detenga donde el de verdad
    La zona muerta del banco va de 7 a 10 %, y la de mentira dejaba de girar recién
    en 5 %. Un Coulomb más alto y un viscoso más bajo la llevan a arrancar en 10 % y
    detenerse en 8 %, sin tocar la ganancia de arriba ni la razón entre bajar y
    subir.
    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
2026-09-13 No guardar en el repositorio lo que mide cada banco
    Los ensayos que se guardan con ensayo.guardar() son datos de un banco
    concreto, igual que su calibración.
    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
2026-09-13 Que el promedio de la velocidad no repita la primera muestra en los bordes
    Rellenar con el valor del borde copiaba la primera diferencia, que es una sola
    muestra con todo su ruido, en media ventana de filas: con 100 ms el pico a pico
    de una velocidad constante crecía en lugar de achicarse. En los extremos la
    ventana ahora se achica a las muestras que hay.
    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
2026-09-13 Que la primera fila del banco de mentira no traiga una velocidad falsa
    El sensor lee el eje de hace medio milisegundo, y para la primera fila de una
    captura eso es antes de que empezara: repetir el primer ángulo acortaba la
    primera diferencia y la velocidad caía un cuarto en esa muestra. Se extrapola
    con la velocidad que traía el eje.
    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
2026-09-13 Devolver el sketch de control y lo que usa, sin sacarle nada a Banco
    El merge de banco-identificacion borró ControlDemo junto con Control y
    ControlMath, y le sacó a las librerías compartidas lo que sólo usaba el lazo:
    el TOP movible, bidir e invert del puente, el cero, el filtro y rezero() del
    ángulo, el signo y el filtro de la corriente, la referencia interna del ADC y
    el diagnóstico eléctrico del bus.
    Vuelve todo, y Banco sigue midiendo lo mismo: los filtros arrancan con alpha 1
    e invert en cero, adc_select_vcc() queda como atajo y FreeAdc::begin() toma la
    referencia interna como argumento opcional. Lo único que no podía convivir es
    el signo del ángulo, así que update() sigue s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
    [ControlDemo.ino]
2026-09-13 Que sync_board() pueda grabar otro sketch que Banco
    sync_board(sketch='ControlDemo') --o una ruta-- elige qué se compila y se
    carga; por omisión sigue siendo SKETCH. Cada sketch compila en su carpeta de
    build/ y guarda su propia huella de fuentes, así que alternar entre dos no
    recompila ninguno. sync_board_cal() lo pasa de largo.
    Claude-Session: https://claude.ai/code/session_0174YtWkboYFTBPDQctLMUSR
2026-09-13 Sacar la calibración compilada en un header
    Los sketches ya no toman Calibracion.h con __has_include ni cargan CAL_LUT al
    arrancar, y se van con eso escribir_header(), su test, la entrada del
    .gitignore y lo que lo contaba en el README, en el documento de calibración y
    en el notebook. La tabla vive sólo en la computadora, que la empuja al
    conectarse.
    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
2026-09-13 Dejar a Banco con sus módulos simples, y lo del lazo del lado del lazo
    AngleTracker, CurrentSense, FreeAdc y HBridge vuelven a ser los que dejó el
    merge: sin filtro, sin cero ni signo, y sin nada que haya que apagar. Lo que
    sólo ControlDemo necesita pasa a libraries/Control: LoopAngle refiere el ángulo
    a offset y lo filtra, LoopCurrent le da signo a la corriente y la filtra, y
    LoopDrive lleva el TOP como parámetro, bidir e invert.
    A las librerías compartidas sólo se les suma lo que Banco no llama:
    HBridge::set_top() y, en BoardStart, adc_select_internal() y adc_bandgap().
    El .hex de Banco sale idéntico byte a byte al de 17a0aa2.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
    [ControlDemo.ino]
2026-09-13 Instalar el banco en Windows con el entorno dyc, y que el notebook avise si el kernel es otro
    Probado en Windows 11 con Miniforge, el Arduino IDE 2.3 y el clon con LGT8F328P:
    hardware.ipynb corre entero contra la placa.
    El IDE 2 trae su propio arduino-cli, pero fuera del PATH, así que quien instalaba
    sólo el IDE no podía compilar. sync_board() lo busca ahí cuando no hay uno en el
    PATH, y si falta el core de AVR el error dice dónde instalarlo.
    Un kernel equivocado se veía como un ModuleNotFoundError sobre serial o control,
    que invita a instalar paquetes en el Python que no es. La primera celda de cada
    notebook llama ahora a entorno.verificar(), que dice qué falta y con qué Python
    se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
    [bench.py, entorno.py]
2026-09-13 Dejar en el notebook de hardware la API del TP2, sin la identificación, para los dos actuadores
    La identificación --la curva estática, el ajuste de tau, la validación-- es el
    trabajo del TP2, y el notebook la resolvía. En su lugar, la sección 5 recorre en
    el orden de un ensayo cada función que el TP necesita, con un ejemplo que corre:
    el comando en por ciento, esperar al eje, capturar, un escalón desde el régimen,
    una serie de escalones y una escalera con events, la velocidad con tres ventanas,
    las unidades de un modelo y el CSV.
    Algunos bancos tienen un puente en H y otros un transistor. El notebook ya no da
    por hecho el segundo: la celda de 2.2 dice cuál tiene el banco, y 5.2 y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
2026-09-13 Armar el zip del TP2, y verificar la instalación sin la placa
    herramientas/empaquetar_tp2.py arma dist/arduino-jupyter-tp2.zip con lo que el TP2
    necesita: el sketch Banco y los dos de puesta en marcha, las bibliotecas con nI2C
    adentro --que es justo lo que el Download ZIP de GitHub no trae--, el Python, los
    dos notebooks, dyc.yml y el README. Toma los archivos de git, así que no se cuela
    build/ ni datos ni la calibración de un banco, y anota el commit en VERSION.txt.
    herramientas/verificar.py comprueba, sin la placa, que el entorno tenga los
    paquetes, que cada sketch compile con las mismas banderas que sync_board(), que
    pasen las pruebas de Python y que los notebooks corran enteros contr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
2026-09-13 Configurar VS Code para el proyecto, y llevar la configuración en el zip del TP2
2026-09-14 Resolver en la placa los signos, el actuador y la medición de corriente
    La placa congela el ángulo y la corriente en el tick de cada fila, y marca con
    y_rep las muestras del AS5600 que repiten la anterior. Los signos del banco
    (ang_inv, cur_inv) y el tipo de actuador (mot_bidir) viven en la placa:
    sync_board(bidir=...) los carga, bringup() mide los signos y verifica que el
    actuador haga lo que se declaró, y ensayo.signo() desaparece.
    La corriente se mide con el ADC corriendo libre y promediando todas las
    conversiones de cada fila (RowAdc), sobre una ventana de cur_filas filas
    (WindowMean): una conversión por fila caía siempre en la misma fase del PWM y
    se desviaba de la media hasta 300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
    [Banco.ino, banco_simulado.py, bench.py, catalogo.py, ensayo.py, test_ctrllink.py, test_hardware.py]
2026-09-14 Llevar a ControlDemo la medición de corriente y las muestras en el tick de Banco
    ControlDemo congela el ángulo y la corriente en el tick, mide la corriente con
    RowAdc, la compensa con el ciclo de trabajo, y tiene la ventana de filas (por
    omisión un período, para no atrasar el lazo) y el notch de la red. El PWM por
    omisión pasa a 1050 Hz. Se va la opción de referencia interna, que no convive
    con RowAdc, y FreeAdc, que ya no usa nadie.
    bench busca el signo de la corriente con el nombre que tenga el sketch
    (cur_inv o cur_invert): con ControlDemo, sync_board() se caía al medir el cero.
2026-09-14 Usar los mismos nombres de parámetros y canales en Banco y ControlDemo
    ControlDemo pasa a cur_inv y mot_inv, y emite y_rep como Banco. bench deja de
    buscar variantes del nombre, y configurar() carga cada signo que la placa tenga
    por separado, así ControlDemo recibe cur_inv aunque no tenga ang_inv.
2026-09-14 Corregir lo que encontró la revisión: mot_inv, bringup en ControlDemo y el notch
    - LoopDrive sólo invierte el comando con bidir: con un solo cuadrante el puente
    recortaba a cero el comando invertido y el motor no recibía nada.
    - bringup() mide y guarda sólo los signos que la placa declara: en ControlDemo,
    que no tiene ang_inv, se caía.
    - MainsNotch recalcula y reinicia su estado sólo cuando cambian sus parámetros o
    la frecuencia de las filas, y no en cada escritura de ctl_uff.
2026-09-14 Desenrollar el ángulo a 5 kHz, medir bien el signo de la corriente y poner al día la documentación
    - El ángulo se desenrolla en la ISR sobre cada muestra (Banco y ControlDemo,
    LoopAngle::update_unwrapped): por fila, con loop_div 25 o 50, la velocidad
    salía con el signo cambiado por encima de ~600 rad/s.
    - bringup detecta el signo de la corriente con el arranque menos el final del
    tirón, que cancela lo que el PWM le hace a la lectura.
    - calibrar_caida aborta si el eje gira y deja la compensación como estaba.
    - El cero se mide sin el principio de la captura.
    - ensayo.velocidad es una diferencia central sobre el tiempo real, sin atraso;
    signo_banco se acepta con un FutureWarning.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
2026-09-14 Sacar los sketches de bringup y de experimentos, y la compatibilidad con la v1
    AS5600_Bringup, Puente_Bringup, AS5600_Loop5k, AdcFase y adc_fase.py salen del
    repositorio y del zip; las referencias del README y de las librerías se
    reescriben sin ellos. signo_banco y su aviso se van: la v1 nunca llegó a los
    alumnos.
2026-09-14 Dibujar el BD139 que tiene el banco en lugar de un MOSFET
    El diagrama de la configuración B′ mostraba una compuerta G con 1 kΩ, y las
    tablas de pines hablaban de la puerta del transistor; el banco tiene un BD139
    con 220 Ω en la base. El notebook explica además de dónde sale la caída que
    compensa calibrar_caida().
2026-09-14 No afirmar un diagnóstico de la corriente que no está medido, y registrar la configuración en el CSV
    - README y hardware.ipynb ya no dicen que la compensación deja hasta -100 mA ni
    que una corriente negativa es un artefacto: lo que queda con el motor andando
    no está medido y así se dice.
    - zero_current: la diferencia entre emitir todos los canales y uno solo son
    unos 20 mA, no 60.
    - Cada captura guarda en df.attrs['config'] la placa y las perillas que
    cambian lo que se mide (catalogo.de_configuracion()); el enlace recuerda lo
    que leyó o fijó para no sumarle una ronda de get a cada captura. guardar()
    lo escribe arriba del CSV y cargar() lo devuelve.
    - Fuera las referencias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
2026-09-14 Compensar la caída de AVCC con una tabla de 17 puntos calibrada en una sola captura
    - SupplySag pasa de una recta con escalón en D = 1 a una tabla contra el ciclo
    de trabajo, interpolada, que se carga como la del ángulo: cur_sagw
    empaquetado y cur_sagsum de Fletcher. Banco y ControlDemo, mismos nombres.
    - calibrar_caida(): fuente del motor apagada, una sola captura con 20 s de
    reposo, la escalera de puntos por eventos y 10 s de reposo, cada punto
    referido a la recta entre los dos reposos; carga, verifica y guarda la tabla
    en cableado.json. Una recta vieja de cableado.json se convierte a tabla.
    - Medido con el sensor puenteado: la caída depende del ciclo de trabajo y no
    de la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
2026-09-15 Medir la corriente contra la alimentación del sensor, con un divisor en A1, y un notch doble que no hay que calibrar
    El clon del banco funciona a 3,3 V y el ACS712 a los 5 V del USB, así que medido
    contra AVCC la lectura se corría con cualquier consumo de la placa. A1 lee los
    5 V del sensor por un divisor y la placa usa A0/A1 (Sense/SupplyRatio.h), en
    cuentas equivalentes a 1,25 mV contra 5 V: la escala del canal y el cero no
    cambian. Con la fuente del motor apagada, la lectura con el PWM pasa de -137 a
    -341 mA a entre -0,6 y +2,6 mA, y la red de 67 a 0,6 mA.
    - RowAdc alterna A0 y A1 cuando hay divisor, a /64 en el clon: a /32 el ruido
    con 10 filas era de 31 mA, a /64 de 9 mA (5 mA mid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
2026-09-15 Arrancar cada conversión con su canal ya elegido, y dos polos opcionales por canal
    Corriendo libre, en el LGT8F328P un cambio de canal escrito en la interrupción
    alcanzaba a la conversión que ya había arrancado o a la siguiente según cuánto
    tardara la interrupción: moviendo la escritura unos µs, A1 pasó de leer 1735 a
    2400. Eso era además el ruido de más del cociente. Ahora cada interrupción lee,
    elige el canal de la próxima y la arranca; a /32 el ruido con A0/A1 es de 17 mA
    por fila y 6 mA con 10 filas (21 y 5 mA sin divisor), así que se va el /64.
    cur_aa pone dos polos por canal antes de sumar la fila, en 16 bits con redondeo:
    con cur_filas = 1 baja el ruido de 17 a ~12 mA c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
2026-09-15 Sacar el doble polo: un antialiasing no mejora la corriente en la banda
    Simulado sobre 11 s de conversiones crudas A0/A1 continuas (17,5 kHz, sin
    pérdidas), con el motor en reposo y en régimen: en 0-200 Hz la caja de la fila
    deja el mismo ruido que un FIR de 1001 coeficientes cortando en 200 Hz, que
    CIC-2, CIC-3 o una caja a 1 kHz más un elíptico. El ruido es blanco desde la
    entrada y ya está en la banda; lo que se pliega cae en ceros (el PWM en 50·k Hz,
    el AS5600 en continua). Los dos polos por corrimiento subían el piso por debajo
    de 45 Hz, así que cur_aa se va.
2026-09-15 Documentar el montaje final de la corriente y avisar si el divisor de A1 está suelto
    - El ACS712 va en serie entre +5 V y el motor, con el diodo abarcando sensor y
    motor: medido, del lado del colector la lectura se corría mientras el eje
    giraba y el régimen variaba de +2 a +55 mA; del lado de +5 V se repite a ±1 mA.
    - README y hardware.ipynb con el montaje, el capacitor de A1 y los números
    finales: pico ~220 mA, régimen ~22 mA a u = 150, 5 mA de ruido con 10 filas,
    el cero moviéndose unos ±5 mA a lo largo de cuatro minutos.
    - sync_board() avisa si con divisor declarado A1 lee saturado o en cero: un
    divisor suelto no da error y corre la corriente cientos de mA.
    Co-Authored-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
    [Banco.ino, bench.py]
2026-09-15 Separar la placa de bench.py, la calibración del AS5600 a extras/, y el zip del TP2 con lo indispensable
    - bench.py queda con el banco: conexión, configurar(), declarar_divisor(),
    bringup() y cableado.json. Compilar, grabar y encontrar el puerto pasan a
    placa.py; sync_board() se usa igual.
    - La calibración del AS5600 (notebook, calib.py, test_calib.py y el método) va a
    extras/calibracion_as5600/, con sync_board_cal() y CALIBRACION en calib.py.
    hardware.ipynb la sigue aplicando si está medida.
    - ctrllink.py sin la caché de configuración: la configuración de cada captura se
    lee al terminarla.
    - empaquetar_tp2.py lleva lo mínimo para el TP2. Quedan en el repositorio y fuera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
2026-09-15 bringup: con sensor de ángulo, el motor anda si gira
    Sin fuente del motor y sin divisor en A1, decía 'motor ok' con 0 vueltas: tomaba como prueba el pico de corriente, que lo produce la caída de AVCC con el PWM. Sin sensor de ángulo, se usa el arranque contra el final, que cancela esa caída.
2026-09-15 Agregar tests_banco: bringup y el divisor de A1 contra un banco con fallas, y consistencia entre documentación y código
    No van en el zip del TP2. Por omisión prueban este repositorio; con ARDUINO_JUPYTER, un zip descomprimido. El banco con fallas es el clon a 3,3 V con el ACS712 en los 5 V del USB: con y sin divisor en A1, el divisor suelto, los signos dados vuelta y la fuente del motor apagada. Detecta el bug de bringup() sin fuente si se reintroduce. En C++, HBridge, SampleClock, SensorHealth, el desenrollado y propiedades de WindowMean y SupplyRatio.
    [Arduino.h, test_modulos_extra.cpp]
2026-09-15 Documentación: hardware.ipynb como única explicación del hardware, y el README con «El enlace»
    El README resume el actuador y la corriente y remite a hardware.ipynb, que suma lo que sólo estaba en el README: el divisor suelto, el LED que corre la lectura, el pico de arranque y el pliegue del PWM a 50 Hz. El README trae el protocolo en «El enlace», porque PROTOCOL.md no va en el zip; Banco.ino deja de citarlo y resume sus comentarios de hardware. De paso: el ángulo vuelve con el signo del banco y no «tal como lo entregó el sensor», la configuración del CSV lleva el divisor y no la compensación vieja, y el CSV para PID Tuner se exporta sin las líneas de configuración.
    Co-Autho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
2026-09-15 test_modulos.cpp: no nombrar un archivo que no va en el zip
2026-09-15 hardware.ipynb: el banco se midió sin el capacitor de A1
2026-09-15 README: instalar desde el zip entregado, sin la URL del repositorio
2026-09-15 Firmware: comentarios en registro técnico, sin historia de desarrollo, y coherentes con el código
    21 períodos de PWM en 20 ms, el clon sin cristal, accumulate() en SensorHealth,
    dónde se aplica la corrección del ángulo, nombres reales en library.properties.
2026-09-15 Python: mensajes con tildes, «Atención:» en lugar de «OJO», tono de apunte
    test_hardware muestra el período nominal en µs; comentarios de ctrllink y
    test_simulado alineados con el código.
2026-09-15 Calibración: tabla int16 de 128 bytes, ejemplo con la API real, y test de asegurar() que la llama
2026-09-15 README y hardware.ipynb: registro técnico, y el aviso de que el cero de la corriente se corre entre paradas
2026-09-15 tests_banco: seguir los mensajes nuevos y el mismo criterio de redacción
2026-09-15 Banco: el notch de la red arranca prendido (cur_notch = 3)
    Medido en el banco con cur_filas = 1 y el divisor en A1: los tonos de la red son de 1 a 2 mA contra ~15 mA de ruido, y el notch abre un hueco de ~±5 Hz en cada armónico sin cambiar el ruido total; en un escalón 0 -> 150, promediando 8, el pico de corriente llega a ~20 ms en lugar de ~5 ms, con la misma altura, y desde los 40 ms las respuestas coinciden. hardware.ipynb lo documenta y dice cómo apagarlo. El simulado arranca igual.
2026-09-15 MainsNotch: la señal en dieciseisavos de cuenta, y la continua exacta en Q12
    En cuartos de cuenta, los polos en r = 0,95 amplificaban el redondeo de las seis secciones y el notch le sumaba a la corriente unos 3,5 mA RMS: con la ventana de 10 filas y el notch prendido por omisión, el ruido pasaba de ~5,3 a ~6,8 mA, medido en el banco, y test_hardware.py fallaba en la prueba de las filas. En dieciseisavos el hueco de cada notch llega a 10^-2 mA²/Hz en lugar de 10^-1, y con 10 filas el notch ya no agrega ruido. Sigue en 16 bits; la entrada va de -2047 a 2047 cuentas alrededor del cero.
    b1 sale de los coeficientes ya redondeados, así la continua pasa con ganancia exactamente 1 (antes 1500 c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
2026-09-15 Corriente: PWM a 1250 Hz, media de 4 ticks antes de sumar la fila, notch en 250 Hz, y el Timer0 a 1000 Hz
    - PWM_TOP = 6400: un período del PWM son exactamente 4 ticks del muestreador.
    - RowAdc cierra cada tick (close_tick) y, con ma, suma a la fila la media de los últimos 4: ceros en todos los armónicos del PWM antes de decimar. cur_ma, prendida por omisión. ControlDemo llama a close_tick y la deja apagada.
    - MainsNotch: notch en el Nyquist de las filas (cur_nyq, prendido), ceros dobles en 250 Hz y polos en 225 Hz con r = 0,7, coeficientes con los ceros y la continua exactos en Q12; cur_notch pasa a máscara (1 = 50, 2 = 100, 4 = 150 Hz) y arranca apagado.
    - board::millis_1000hz(): el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
2026-09-15 Documentación: PWM a 1250 Hz, los filtros de la corriente y el Timer0 a 1000 Hz
    hardware.ipynb explica por qué 1250 Hz, qué hacen cur_ma y cur_nyq con lo medido, por qué el notch de red arranca apagado, y agrega a la nota al pie que en régimen la media salta entre dos niveles de una captura a otra, que los filtros no corrigen. README con los parámetros nuevos y el Timer0.
2026-09-16 Corriente: el canal en dieciseisavos de cuenta, y la escala de AVCC fuera del cociente
    Emulando la cadena entera sobre capturas del banco y comparándola contra la misma
    cadena en punto flotante, el que más ruido ponía no era el cociente en Q12 --0,47 a
    0,54 mA RMS-- sino el redondeo a cuenta entera, que ocurría dos veces: en la salida de
    SupplyRatio (1,69 a 2,07 mA) y otra vez a la salida del notch (1,75 a 1,93 mA). Llevar
    el cociente a Q16 no arregla nada y roza el desborde; en Q18 desborda.
    Así que se saca el cociente intermedio. Las potencias de dos se cancelan solas:
    c_q4 = mean0_q4 * scale_q4 / mean1_q4
    y lo que sale son dieciseisavos de cuenta, la unidad que MainsNotch ya l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
    [Banco.ino, ControlDemo.ino, test_modulos_extra.cpp]
2026-09-16 Python: la unidad del canal i y la cuenta del conversor son dos cosas distintas
    El canal `i` publica dieciseisavos de cuenta y `cur_zero` sigue en cuentas enteras,
    que es como se mide y como lo informa la placa. Todo lo que hablaba del conversor
    --el cero, los rieles, el margen, el umbral de los signos-- reconstruía la cuenta
    dividiendo `i` por la escala del canal, y así quedaba dieciséis veces inflado.
    `Bench._ma_por_cuenta()` es lo que separa las dos unidades, y la lee de `cur_frac`, que
    la placa publica: no hace falta tenerla escrita de este lado, y ControlDemo, que publica
    cuentas enteras con las mismas clases, sigue andando sin cambios.
    El aviso de «sin dither» sigue midiendo con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
2026-09-16 Documentación: la unidad del canal de corriente, y qué elige la referencia en el clon
    De BoardAdc.h: el comentario decía que la referencia la eligen DACON y REFS2. Medido
    barriendo los 256 valores de DACON, los 4 de REFS y cuatro bytes de calibración, con
    256 conversiones por punto: lo único que la mueve es REFS2. Y con el micro a 3,3 V la
    única referencia interna alcanzable es la de 1,024 V --no hay ninguna combinación que
    dé las cuentas de 2,048 ni de 4,096--; medida contra un nodo interno fijo da
    AVCC = 3,353 V, repetible al 0,03 % entre reinicios pero sin nada adentro del micro
    contra lo cual verificarla, y con el I2C del AS5600 corriendo se corre un 2,3 %.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
2026-09-16 MainsNotch: el lazo guarda un bit más abajo del dieciseisavo
    Con el canal publicando cuentas enteras, el redondeo que el filtro se realimenta quedaba
    tapado por el escalón de 6,8 mA de la salida. Publicando dieciseisavos quedó a la vista
    y pasó a ser el término más grande de toda la cadena: medido en la placa en reposo con
    `cur_filas = 10`, alternando el notch prendido y apagado tres veces, ponía 0,47 a
    0,53 mA sobre un piso de 0,33 a 0,43.
    Así que el estado del lazo pasa de int16 en dieciseisavos a int32 con `GUARD_BITS` más
    abajo, y el redondeo a la unidad del canal se hace recién a la salida. Cada bit baja
    6 dB ese ruido --simulado: 0,62, 0,35 y 0,21 mA con 0, 1 y 2-- y lo que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
2026-09-16 bench: medir la relación del divisor de A1 contra el reposo del sensor
    Declararla a mano con las resistencias deja la escala de miliamperes abierta ±7 % con
    resistencias del 5 %, y medirla pedía conocer los 5 V que alimentan al sensor, que no se
    pueden medir desde adentro del micro: están por encima de AVCC y el único camino es el
    divisor mismo.
    No hace falta. El ACS712 reposa en la mitad de SU alimentación, así que con el actuador
    abierto, y en cuentas del conversor, A0 = V5/2 y A1 = V5·k, de donde k = A1 / (2·A0) con
    V5 y la referencia del conversor cancelándose. En términos de lo que la placa ya publica
    es k = 2000 · cur_div / reposo, y no depende del cur_div que hubiera pues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
2026-09-16 Documentación: cuándo el notch de 250 Hz se gana el lugar, y el divisor medido
2026-09-16 Documentación: el salto de dos niveles entre capturas, y por qué el ADC sigue libre
    Lo que la nota al pie llamaba «el cero se corre de una parada del motor a otra» no es
    una deriva. Medido en reposo, en tramos de 3 s durante tres minutos: la corriente toma
    uno de dos niveles, el nivel se sortea al arrancar cada captura y no se mueve mientras la
    captura dura --el ruido entre filas es 0,5 mA y la primera mitad contra la segunda
    difieren 0,3 mA, contra 62 mA entre tramos--, y cambia de nivel en la mitad de los
    tramos. Con el motor en régimen pasa lo mismo, con la misma velocidad del eje (±0,3 %),
    así que es de la medición y no del motor.
    Qué se descartó, midiendo: el divisor (`cur_a1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
2026-09-16 RowAdc: un relleno de 3 us para que el conteo de conversiones por tick nunca sea par
    Es el arreglo del salto de dos niveles que el canal tomaba entre capturas, y ahora se
    sabe por qué pasaba. Alternando dos canales la secuencia de conversiones tiene período 2,
    y la interrupción del muestreador le roba tiempo a una conversión de cada tick: si en un
    tick entra un número PAR de conversiones la paridad se conserva y esa perturbación cae
    siempre sobre el mismo canal, sorteado al arrancar el flujo. Con un número impar la
    paridad se da vuelta en cada tick y se cancela sola.
    Medido barriendo el TOP del Timer2 --o sea el ritmo del tick-- con un solo binario, para
    que la alineación del códig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
    [bench.py]
2026-09-16 hardware.ipynb: qué queda de la deriva del reposo, medido con el relleno puesto
    El mismo experimento de tres minutos, antes y después: el desvío entre tramos de 3 s pasa
    de 30,9 a 0,37 mA y el rango de 63,6 a 2,0 mA, sin dos niveles. Lo que queda es una
    deriva lenta de 0,11 mA por minuto y 0,35 mA alrededor de esa recta, que no es ruido
    blanco --promediando las 1460 filas de un tramo el ruido entre filas daría 0,015 mA-- así
    que hay energía de baja frecuencia sin explicar, veinte veces más chica que antes pero no
    nula. Y hacer girar el motor corre el cero unos pocos mA: 2,0 mA de rango en tres minutos
    quieto contra 6 mA en seis ciclos con arranques de por medio.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
2026-09-16 Sense: las perillas del diagnóstico del conversor, compiladas afuera salvo -DSENSE_DIAG=1
    Son las que sirvieron para encontrar la paridad de las conversiones y para elegir el
    relleno de 3 us de RowAdc, y hacen falta de nuevo cada vez que cambie el trabajo de la
    interrupción del conversor o la del muestreador. Vivían en una rama aparte; así quedan a
    mano sin costar nada en el binario de siempre.
    dbg_settle el relleno, para barrerlo
    dbg_lock una ráfaga de N conversiones por tick, con la fase fija
    dbg_pre el preescalador del ADC, reaplicable en caliente
    dbg_mix el canal elegido por un LFSR, para romper el período 2
    dbg_ocr el TOP del Timer2: mueve el ritmo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
2026-09-16 Documentación: los números que quedaron viejos, medidos de nuevo con el firmware final
    Varias frases afirmaban cantidades medidas antes del relleno de RowAdc y del bit de
    guarda de MainsNotch. Remedidas en la placa:
    la deriva del cero en reposo 7 cuentas por minuto -> 0,11 mA por minuto
    conversiones de A0 por tick unas 2 -> una y media (tres en total)
    conversiones por fila unas 35 -> unas 30
    ruido en reposo, filtros off 2,9 / 0,37 mA -> 3,1 / 0,39 mA
    el cero entre parada y parada hasta ±60 mA -> 6 mA con arranques de por medio
    el cero entre uno y cinco canales unos 20 mA -> 0,7 mA
    repetibili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
2026-09-16 Verificar que la unidad del canal de corriente sea la misma en los cuatro lados
    La unidad del canal --dieciseisavos de cuenta-- está escrita en `SupplyRatio::FRAC_BITS`,
    la comparte `MainsNotch` (que lleva la señal adentro sin volver a escalarla), la copia
    `g_cur_frac` para publicarla por el enlace, y la repite `banco_simulado.CUR_FRAC`.
    Separarlas cambia la escala de `i` sin que nada se queje: el golden de `test_tablas.py`
    guarda la escala como el texto `SENSE_MA_PER_LSB`, así que el cambio de 6,76 a 0,42 mA por
    unidad pasó sin mover el golden.
    Ahora: un `static_assert` en Banco.ino ata el notch al cociente, y `test_consistencia.py`
    calcula la escala desde las constantes --`UV_PER_COUN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
2026-09-16 Sense y bench: los defectos que encontró la revisión antes del merge
    **MainsNotch: elegir los bits de guarda según las secciones.** Se habían fijado en 1 con
    una cota calculada sobre una sola configuración: la de 49,5 Hz con r = 0,95 y filas a
    500 Hz, cuya norma L1 es 24230. Pero la L1 crece cuando f0/row_hz baja y cuando el polo se
    acerca al origen, así que depende de `loop_div` y de `pole_milli`, que son perillas. Con el
    radio por omisión y `loop_div = 1` --filas a 5 kHz-- la de 49,5 Hz da 37594 y el acumulador
    de 32 bits desborda: `acc` da la vuelta, `y = acc >> 12` sale cualquier cosa y la sección
    queda corrupta mientras la configuración dure. Es una regresión del commit que ag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
2026-09-16 MainsNotch: el bit de guarda vuelve a ser fijo, y la sección que no entra no se pone
    Elegirlo en apply() según las secciones puestas andaba, pero es más máquina de la que hace
    falta: obliga a llevar la peor norma L1 en un miembro y deja los corrimientos del lazo como
    variables, dentro del bucle que corre por sección y por muestra. Mirando los números, no
    hace falta elegir nada.
    Con el bit de guarda fijo en 1 una sección entra si su norma L1 no pasa de 32000, y eso lo
    cumplen todas las configuraciones usables: con el radio por omisión la única que pierde
    algo es `loop_div = 1` --filas a 5 kHz-- donde se caen el par de 49,5 Hz y quedan cinco de
    siete; de `loop_div = 2` para arriba en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
2026-09-16 Aritmética: los desbordes que encontró la revisión, con las pruebas que los agarran
    Cinco lugares en los que una cuenta se daba la vuelta en silencio, y el
    compilador de escritorio que hacía falta para verlo.
    SupplyRatio::media_q4(): la guarda del camino corto descontaba el producto
    pero no el medio divisor que se suma para redondear. Hay una ventana de 4080
    valores de la suma en la que `suma * 16 + n / 2` desborda y la media sale 0 en
    lugar de 32896: la corriente publicada salta a -2048 cuentas, o sea -13,8 A.
    Se alcanza con loop_div >= 129 y la ventana de 32 filas. Es de la vuelta
    anterior, en el arreglo del desborde que tenía antes.
    AngleLut::checksum(): acumulaba módulo 256 sobre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
    [Banco.ino, banco_simulado.py, calib.py, test_calib.py, test_modulos_extra.cpp]
2026-09-16 Salud del lazo, rearranque del ADC y bus del sensor: lo que el diagnóstico no veía
    `maxlate` no podía expresar un lazo desbordado. SampleClock pisaba la marca de
    tiempo en cada período, atendido o no, así que medía contra el último tick y no
    contra el primero sin atender: el retardo informado quedaba acotado a un período
    pase lo que pase. Medido en la placa con loop_div = 1 y cinco canales: antes
    268 us (el 134 % de un período) con 5548 períodos perdidos; ahora 1540 us, o sea
    7,7 períodos, con 4371 perdidos. Cuesta cero ciclos: es no pisar la marca cuando
    ya hay un período sin atender.
    Al arreglarlo apareció que clear_health() ponía en cero los contadores pero
    dejaba la marca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
    [Banco.ino]
2026-09-16 El protocolo: lo que devolvía datos mal sin quejarse
    Ocho formas de que una captura o un `set` vuelva equivocado con aspecto normal.
    Un error del enlace que levanta excepción se ve; uno que devuelve un DataFrame
    bien formado, no.
    `dev.<nombre mal escrito> = x` no tocaba la placa y se leía de vuelta. El nombre
    caía en el manejo normal de atributos, quedaba en el objeto, y __getattr__ ni se
    enteraba: `dev.reff = 1000` devolvía 1000 con `ref` en 0 del otro lado. Con un
    motor girando eso es creer que se bajó una ganancia y que el lazo siga con la
    vieja. Hace falta en las dos capas --CtrlLink y Bench-- porque los notebooks usan
    la de arriba; verificado contra la placa que ahora levanta con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
    [bench.py, ctrllink.py, fakeuno.py, test_ctrllink.py]
2026-09-16 bench.py: calibrar contra una medición mala, y el signo que faltaba en bringup()
    declarar_divisor() tenía el mismo defecto que ya se le arregló a
    medir_divisor(): recalibraba el cero ANTES de mirar si A1 leía algo, y al
    abortar restituía `cur_div` pero dejaba `cur_zero` calibrado contra un divisor
    que ya no está. Medido sobre el banco simulado: cur_zero 2048 -> 4095 y el
    reposo de +8008 mA a -5822 mA, con el banco a medio calibrar y sin ningún aviso.
    A1 no se puede verificar antes de declarar el divisor --la placa sólo alterna
    canales cuando `cur_div` no es cero, así que sin divisor `cur_a1` vale 0 por
    definición; el simulador lo dejó claro--, pero sí se puede no tocar el cero h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
    [banco_simulado.py, bench.py]
2026-09-16 Documentación: los números del enlace, vueltos a medir en la placa
    La pérdida de bytes de comando no es del 4 %. Medido acá (60 comandos
    `get loop_div` de 13 bytes por caso), de corrido llegan enteros 14 de 60 sin
    flujo y 8 de 60 con flujo, o sea p ~ 11 % y ~ 14 % de los bytes. Espaciados
    0,5 ms por byte, 60 de 60 en las dos condiciones. Que la pérdida sea igual sin
    telemetría confirma que lo que se come los bytes es el muestreador y no la
    emisión.
    Y el argumento de por qué no se usa ISR_NOBLOCK no se sostenía: decía que el
    manejador de TWI también bloquea, pero dura ~9 us y eso entra holgado en los
    ~20 us que da el buffer de dos bytes del USART. El que no entra es el del
    muestre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
2026-09-16 Dos que cuestan casi nada: el checksum con cada `set`, y el primer período tras mover loop_div
    refresh_tuning() recalculaba el checksum de la tabla con CADA escritura de
    parámetro --`ctl_uff` incluido--, adentro del mismo período de control en el que
    cayó el `set`. Recorrer las 64 entradas cuesta del orden de 700 ciclos, y con la
    fila ocupando el 76 % del período eso lo convertía en el candidato más probable a
    período perdido en medio de una captura. `apply()` ya sabía si la tabla se movió
    y su valor devuelto se estaba tirando. `ang_lutsum` sigue describiendo lo que
    hay: la tabla no cambia por ninguna otra vía, y setup() lo calcula una vez sin
    condición para no depender de que el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
2026-09-16 Interrupciones: el techo de filas sube 37 %, medido alternando las dos versiones
    Tres cambios en el camino que corre por tick y por fila, y la nueva elección de
    SETTLE_US que hace falta después de tocarlo.
    MovingAverage: la media móvil sale de RowAdc a su propia clase, con un buffer
    circular y una suma corrida. Reemplaza correr el historial a mano --24 bytes de
    uint32 y 12 de uint16 movidos en CADA tick de 5 kHz-- por dos escrituras, y
    sumar cuatro términos por sumar el que entra y restar el que sale.
    N es parámetro de plantilla, así que la división que cierra la media se resuelve
    en compilación. Con N potencia de dos es un corrimiento; con cualquier otra es
    una división entera, y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
2026-09-16 Acotar lo que junta un tick, y el buffer de transmisión a 128
    El desborde que introdujo angostar la suma del tick a 16 bits. `close_tick()` es
    lo único que pone esa suma en cero y corre en la ISR del muestreador, así que
    cualquiera que enmascare esa interrupción con el ADC andando deja las
    conversiones acumulándose en un solo "tick" que dura lo que dure la pausa. Y eso
    pasa: `apply_sensor_filter()` llama a SampleClock::pause() y se toma de 2 a 7 ms
    --hasta 5 esperando el bus y 2 de holgura-- con el conversor libre. A /32 son de
    62 a 218 conversiones, o sea una suma de hasta 892 710, que en 16 bits da la
    vuelta 27 veces. En Banco corre en setup(), después de g_adc.begin(); en
    ControlDem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
2026-10-06 Lo que Banco y ControlDemo hacían cada uno por su lado, en las bibliotecas
    - AS5600::write_slow_filter(): el lee-modifica-escribe del CONF con el
    muestreador parado, que estaba copiado en los dos sketches.
    - SensorHealth::refresh_mounting(): la ronda de STATUS, AGC y MAGNITUDE; y
    los contadores saturan en lugar de dar la vuelta.
    - SampleClock::window(): la ventana de salud se abre y se cierra con la
    emisión. Un divisor nuevo y su contador se escriben juntos, con la ISR
    afuera, y sólo cuando el divisor cambió.
    - AngleLut: `sum` al día con cada apply(), y correction() se resta sobre lo
    desenrollado en lugar de corrected() más wrapped_error().
    - RowAdc::reconfigure() con la ISR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
    [Banco.ino, ControlDemo.ino, test_modulos_extra.cpp]
2026-10-06 Python: lo repetido en bench.py y ctrllink.py, y el banco simulado contra la placa
    bench.py nombra una sola vez lo que comparaba en varios lugares (los
    rieles del conversor, el rango de A1 con divisor, el reposo de 2000
    cuentas equivalentes), y configurar() mide el cero con zero_current().
    ctrllink.py junta la sugerencia de nombres y el descubrimiento del
    dispositivo. test_calib.py verifica que el banco simulado dé la misma suma
    y la misma corrección que calib.py, y ControlMath vuelve al zip: Sense la
    usa.
2026-10-06 Documentación: el buffer de 128 bytes, el contador de ticks y los números del enlace
    PROTOCOL.md dice qué cuenta `tick` (una llamada a emit(), se emita o no la
    fila) y qué no (un período que el lazo no atendió), con el buffer de
    transmisión de 128 bytes con que se compila Banco, y deja los números
    medidos donde se usan.
2026-10-06 Corriente: la cadena entera en CurrentSense, en dieciseisavos de punta a punta
    Banco y ControlDemo armaban a mano la misma cadena --la ventana de A0 y de
    A1, el cociente contra la alimentación del sensor, el cero, el notch y el
    signo-- y ControlDemo además redondeaba a cuentas entre un paso y otro.
    Ahora CurrentSense es la cadena, con push() por fila y apply() por
    escritura de parámetro, y LoopCurrent redondea una sola vez, al final.
    En Banco la salida es la misma, bit a bit. En ControlDemo también con el
    notch apagado, que es como arranca; con el notch prendido redondea menos.
    Se van SupplyRatio::counts(), MainsNotch::step() y la CurrentSense::update()
    en cuentas enteras, que sólo usa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
2026-10-06 ISR: el ángulo de cada tick en AngleSampler, el mismo en los dos sketches
    La ISR del muestreador hacía lo mismo en Banco y en ControlDemo: ver si la
    muestra es nueva, lanzar la transferencia, desenrollar, y en el tick de la
    fila congelar cuenta, ángulo desenrollado y frescura para que loop() los
    lea de una vez. AngleSampler<Sensor> lo hace con on_tick(), freeze() y
    take(); todo queda inline, y la ISR de Banco crece 8 bytes.
    En Banco, close_tick() pasa a ser lo primero de la ISR, como ya era en
    ControlDemo: el borde del tick del ADC se adelanta los pocos ciclos que
    tomaba leer el contador de muestras. Con prueba de escritorio contra un
    sensor simulado.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
2026-10-06 Arranque y bus: el ADIF pendiente, el orden del ADC, y lo que el sensor no necesitaba
    - RowAdc::begin() borra el ADIF que deja cualquier conversión anterior: al
    habilitar ADIE su interrupción entraba enseguida y sumaba esa cuenta a la
    primera fila. Y los dos sketches arrancan el ADC antes de refresh_tuning(),
    que lo reconfigura.
    - ControlDemo: si escribir el filtro del sensor falla en setup(), no queda
    marcado como aplicado y se reintenta con la próxima escritura.
    - AS5600Regs entra en AS5600.h: era una biblioteca aparte para un sketch de
    puesta en marcha que ya no existe. Se van read_status() y
    consecutive_errors(), y en CtrlLink rows(), drops() y period_us(): nadie
    los lla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
2026-10-06 ControlDemo: PWM a 1250 Hz, Timer0 a 1000 Hz y los dos filtros del PWM, como Banco
    El mismo TOP de 6400 y la misma media de 4 ticks (`cur_ma`) y notch en el
    Nyquist (`cur_nyq`), los dos publicados y prendidos al arrancar. Sin medir
    en la placa: ControlDemo corre además la ley de control. Flash 95 %.
2026-10-06 Python: la tabla de calibración en un solo lugar, y lo que la revisión encontró
    - tabla_angulo.py: la suma de Fletcher, la corrección y la escritura de una
    entrada, que estaban en calib.py y en banco_simulado.py. El simulador
    acota las entradas a ±4095, como la placa.
    - banco_simulado: `tick` avanza de a `dec` y cuenta las filas con `dec`;
    zero_current() y describe() son los de Bench; `loop_late` en 0 hasta una
    captura; `cur_filas` acotado a 32.
    - ctrllink: el eco de un parámetro entero tiene que coincidir exacto. Con la
    tolerancia relativa, `ang_lutw` aceptaba un valor corrido en ±4. Y pyserial
    se importa recién al abrir el puerto.
    - Afuera lo que nadie usaba: Calibracio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
2026-10-06 Pruebas de escritorio con mingw, y el zip sin las pruebas de ControlMath
    La tarea de VS Code compila con -D_USE_MATH_DEFINES, igual que correr.py:
    con -std=c++11 mingw esconde M_PI. El zip del TP2 no lleva
    libraries/ControlMath/test, que no corre nadie de los que lo reciben.
2026-10-06 Documentación y comentarios: lo que contradecía al código, y sin historia
    - CALIBRACION_AS5600.md §7 citaba corrected() y wrapped_error() y decía
    que la corrección va antes de desenrollar; ahora copia el código de
    Banco. §4, §9 y §10 en presente, no como plan.
    - PROTOCOL.md: sin la instalación con venv (está en el README), la lista de
    periféricos remite a hardware.ipynb, los nombres son de 11 caracteres.
    - README: la lista de periféricos y el filtro 2x remiten a hardware.ipynb, y
    el capacitor de A1 como recomendación.
    - Comentarios de las bibliotecas en presente, con las mediciones y sin la
    historia; RowAdc deja los números de ruido a hardware.ipynb.
    - test_consiste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
    [Banco.ino, ControlDemo.ino]
2026-10-06 TP3 en borrador: control de velocidad del motor identificado, con su clave
    El enunciado (tp3/tp3_control_motor.ipynb, generado por _fuentes/build_tp3.py), el
    lazo de referencia cerrado sobre el banco simulado (_fuentes/lazo_simulado.py) y la
    clave que sale de él (_fuentes/clave_tp3.py). El firmware todavía no tiene lazo de
    velocidad ni cadena de bloques: los nombres de la interfaz son provisionales.
2026-10-06 TP3: el PI de velocidad, cerrado sobre el ángulo, y que lo descubran
    Parte B del ejercicio 3: seguir un ángulo que avanza. Un proporcional deja error de
    seguimiento; el bloque (1/tau, 0), el mejor PI de velocidad, deja dos integradores
    y el lazo oscila sin apagarse. El 3.7 pide el porqué (z < 1/tau, sin que importe Kc)
    y el 3.8, diseñarlo con cuidado. El escalón grande y la bajada pasan a profundización.
